radi8/-HL_TX-RX_Filters/Takashi Filters/TestData/4_height.jpg

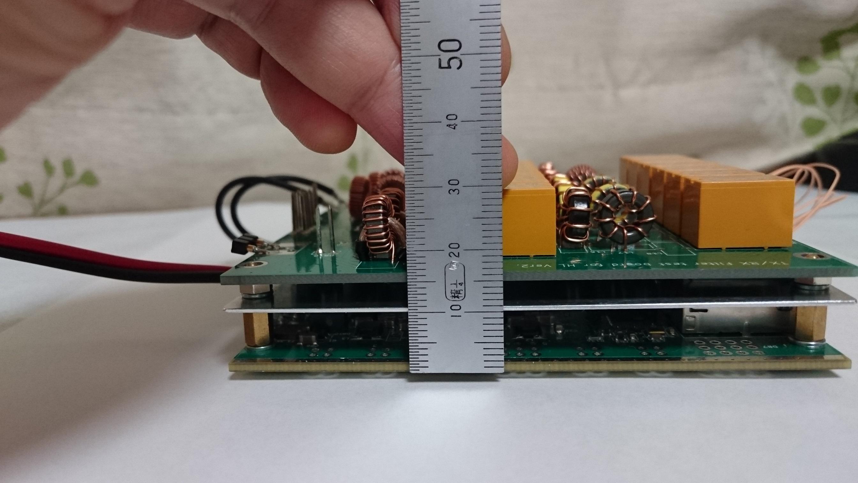
Takashi Filters/TestData/4_height.jpg
