radi8/-HL_TX-RX_Filters/Takashi Filters/TestData/1_HLv2b3_plus_CWKeyerIFwithAudioCodec.jpg

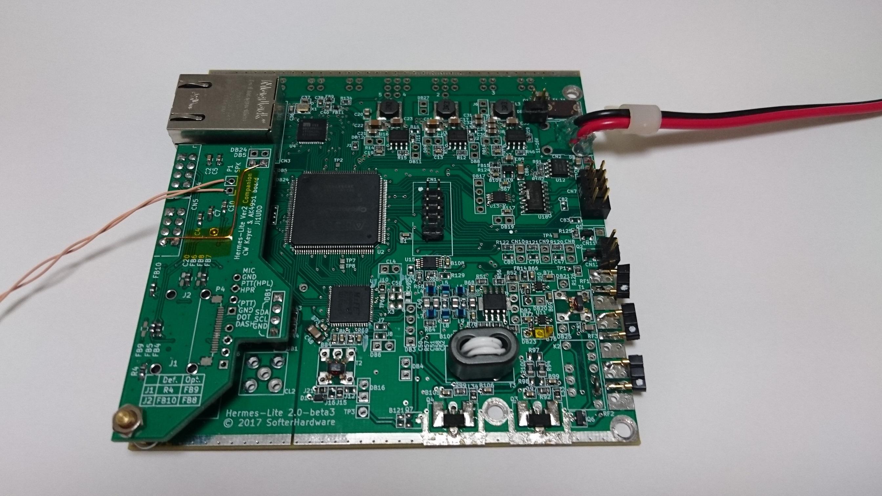
Takashi Filters/TestData/1_HLv2b3_plus_CWKeyerIFwithAudioCodec.jpg
