radi8/-HL_TX-RX_Filters/README.md

# HL_TX-RX_Filters
Transmit and receive filters catalog plus Kicad layout for 100 x 100 mm PCB and part listings
