radi8/-HL_TX-RX_Filters/report.txt

Info: Backing up file "/home/gvj/Kicad/Projects/HL_TX-RX_Filters/sym-lib-table" to file "/home/gvj/Kicad/Projects/HL_TX-RX_Filters/rescue-backup/sym-lib-table-2018-09-30-22-53-34".
Info: Backing up file "/home/gvj/Kicad/Projects/HL_TX-RX_Filters/HL_TX-RX_Filter.sch" to file "/home/gvj/Kicad/Projects/HL_TX-RX_Filters/rescue-backup/HL_TX-RX_Filter-2018-09-30-22-53-34.sch".
Info: Backing up file "/home/gvj/Kicad/Projects/HL_TX-RX_Filters/HL_TX-RX_Filter.pro" to file "/home/gvj/Kicad/Projects/HL_TX-RX_Filters/rescue-backup/HL_TX-RX_Filter-2018-09-30-22-53-34.pro".
Info: Backing up file "/home/gvj/Kicad/Projects/HL_TX-RX_Filters/HL_TX-RX_Filter-cache.lib" to file "/home/gvj/Kicad/Projects/HL_TX-RX_Filters/rescue-backup/HL_TX-RX_Filter-cache-2018-09-30-22-53-34.lib".
Info: Backing up file "/home/gvj/Kicad/Projects/HL_TX-RX_Filters/HL_TX-RX_Filter-rescue.lib" to file "/home/gvj/Kicad/Projects/HL_TX-RX_Filters/rescue-backup/HL_TX-RX_Filter-rescue-2018-09-30-22-53-34.lib".
Info: Backing up file "/home/gvj/Kicad/Projects/HL_TX-RX_Filters/HL_TX-RX_Filter-rescue.dcm" to file "/home/gvj/Kicad/Projects/HL_TX-RX_Filters/rescue-backup/HL_TX-RX_Filter-rescue-2018-09-30-22-53-34.dcm".
Info: Adding library "HL_TX-RX_Filter-rescue", file "${MYPRJ}/HL_TX-RX_Filters/HL_TX-RX_Filter-rescue.lib" to project symbol library table.
Symbol "PE4259" mapped to symbol library "HL_TX-RX_Filter-rescue".
Symbol "PE4259" mapped to symbol library "HL_TX-RX_Filter-rescue".
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
Symbol "D" mapped to symbol library "HL_TX-RX_Filter-rescue".
Symbol "CONN_01X02" mapped to symbol library "HL_TX-RX_Filter-rescue".
Symbol "Conn_Coaxial" mapped to symbol library "HL_TX-RX_Filter-rescue".
Symbol "GND" mapped to symbol library "power".
Info: Symbol library table mapping complete!
