radi8/-HL_TX-RX_Filters/FilterScans/12-10M_Trans_MiniVNA.pdf

# Testexport

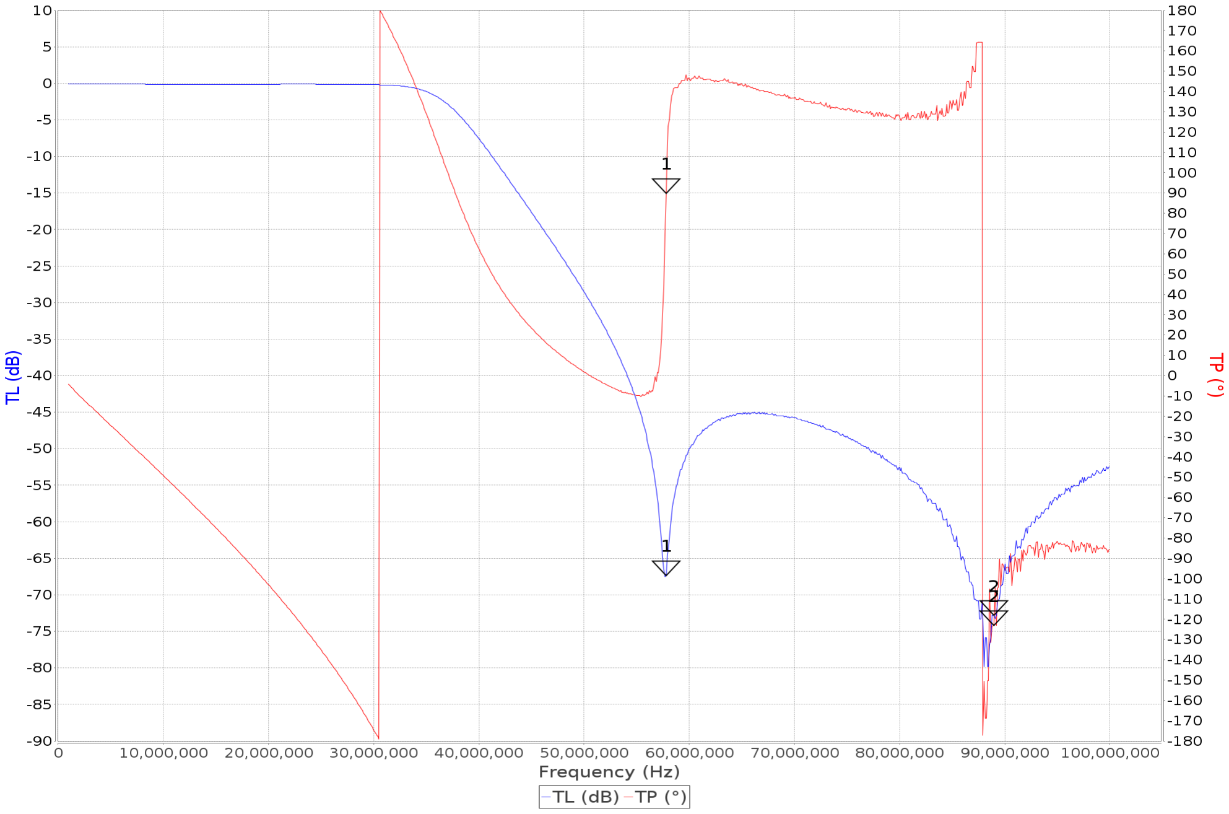
[picture p3: figure]

## Comment:

Date: | 31/08/17 9:53 PM
Mode: | Transmission
Analyser: | miniVNA-pro / mini radio solutions - miniVNA pro
Scan
Start: | 1000000 / 1,000,000
Stop: | 99998969 / 99,998,969
Samples: 943
Overscan: 5
Calibration
Samples: 2000
Overscan: 1
File: | TRAN_miniVNA-pro.cal
User: | gvj

## Plot generated on 31/08/2017, 9:53:38 PM

Marker | Freq. (Hz) | RL (dB) | RP (°) | TL (dB) | TP (°) | SWR | |Z| () | Rs () | Xs ()
1 | 57,795,803 | 0.00 | 0.00 | -67.37 | 89.79 | 0.00:1 | 0.0 | 0.0 | 0.0
2 | 88,975,754 | 0.00 | 0.00 | -72.81 | -123.15 | 0.00:1 | 0.0 | 0.0 | 0.0
1-2 | 31,179,951 | 0.00 | 0.00 | 5.44 | 212.93 | --- | 0.0 | 0.0 | 0.0
© DL2SBA 2013 | vna/J Version 2.8.6c | http://vnaj.dl2sba.com
