radi8/-HL_TX-RX_Filters/Takashi Filters/170814_PA_Mode_Spur_IMD_rev1.1.pdf

## HLv2 Beta3 PA Mode test : Spur and IMD

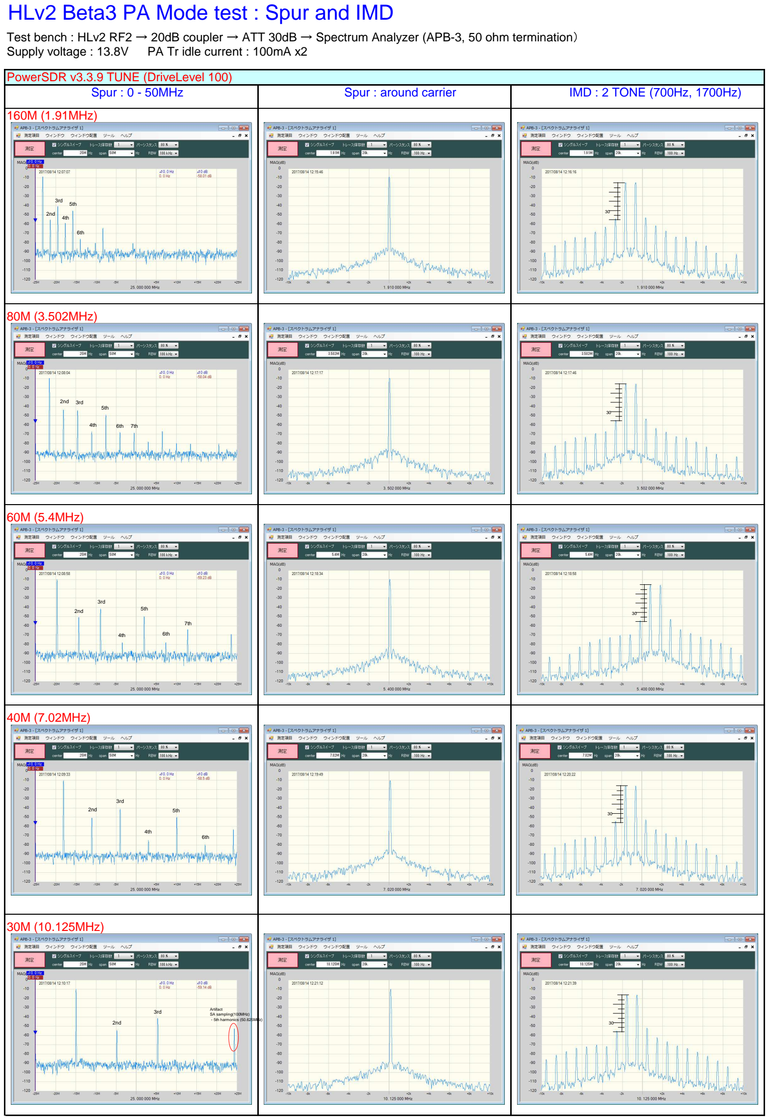
[picture p4: page 1]

Test bench : HLv2 RF2 → 20dB coupler → ATT 30dB → Spectrum Analyzer (APB-3, 50 ohm termination） Supply voltage : 13.8V PA Tr idle current : 100mA x2

PowerSDR v3.3.9 TUNE (DriveLevel 100)
Spur : 0 - 50MHz | Spur : around carrier | IMD : 2 TONE (700Hz, 1700Hz)
160M (1.91MHz)

80M (3.502MHz)

60M (5.4MHz)

40M (7.02MHz)

30M (10.125MHz)

2nd

3rd | Artifact SA sampling(100MHz)
- 5th harmonics (50.625MHz)

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
2nd 3rd

4th

5th

6th 7th

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
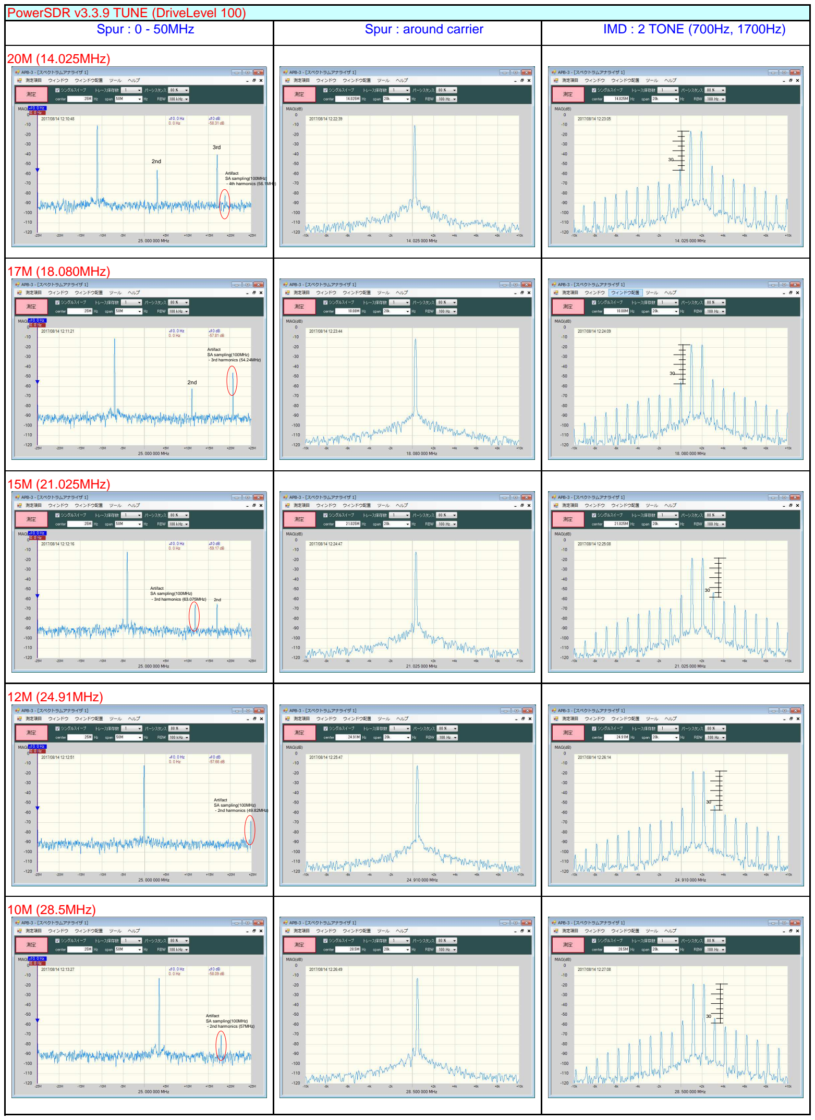
[picture p5: page 2]

PowerSDR v3.3.9 TUNE (DriveLevel 100)
Spur : 0 - 50MHz | Spur : around carrier | IMD : 2 TONE (700Hz, 1700Hz)

20M (14.025MHz)

17M (18.080MHz)

15M (21.025MHz)

12M (24.91MHz)

10M (28.5MHz)

Artifact
SA sampling(100MHz)
- 2nd harmonics (57MHz)

Artifact
SA sampling(100MHz)
- 2nd harmonics (49.82MHz)

Artifact
SA sampling(100MHz)
- 3rd harmonics (63.075MHz) 2nd

2nd

Artifact
SA sampling(100MHz)
- 3rd harmonics (54.24MHz)

2nd

3rd

Artifact
SA sampling(100MHz)
- 4th harmonics (56.1MHz)

30

30

30

30

30
