radi8/-HL_TX-RX_Filters/FiltersBp_gj/30-20M_mesh_schematic.png

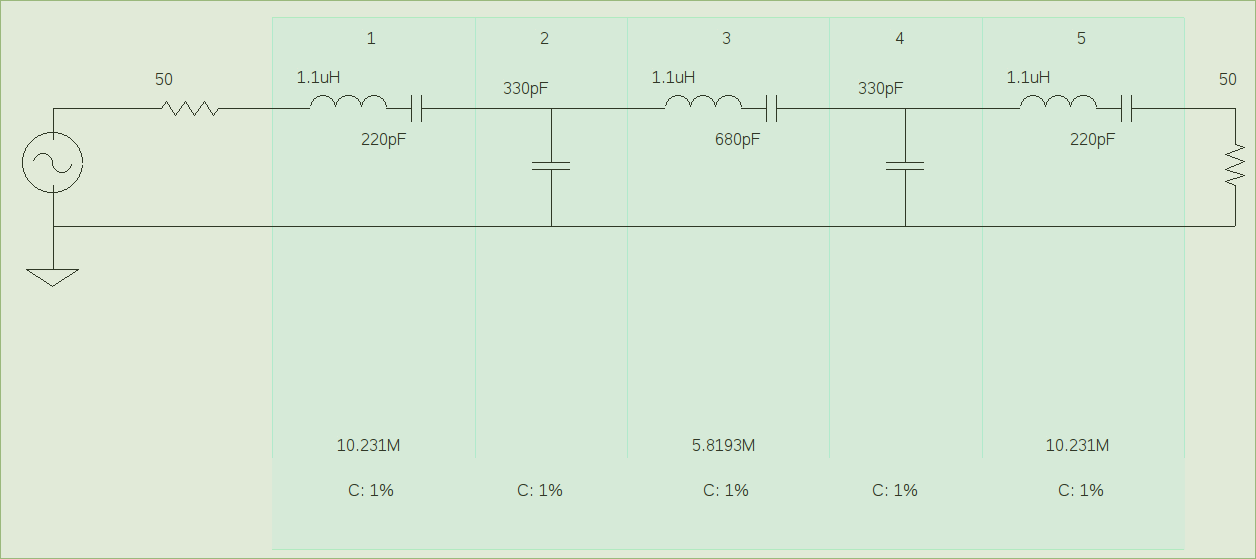
FiltersBp_gj/30-20M_mesh_schematic.png
