radi8/-HL_TX-RX_Filters/FiltersBp_gj/60-40M_mesh_schermatic.png

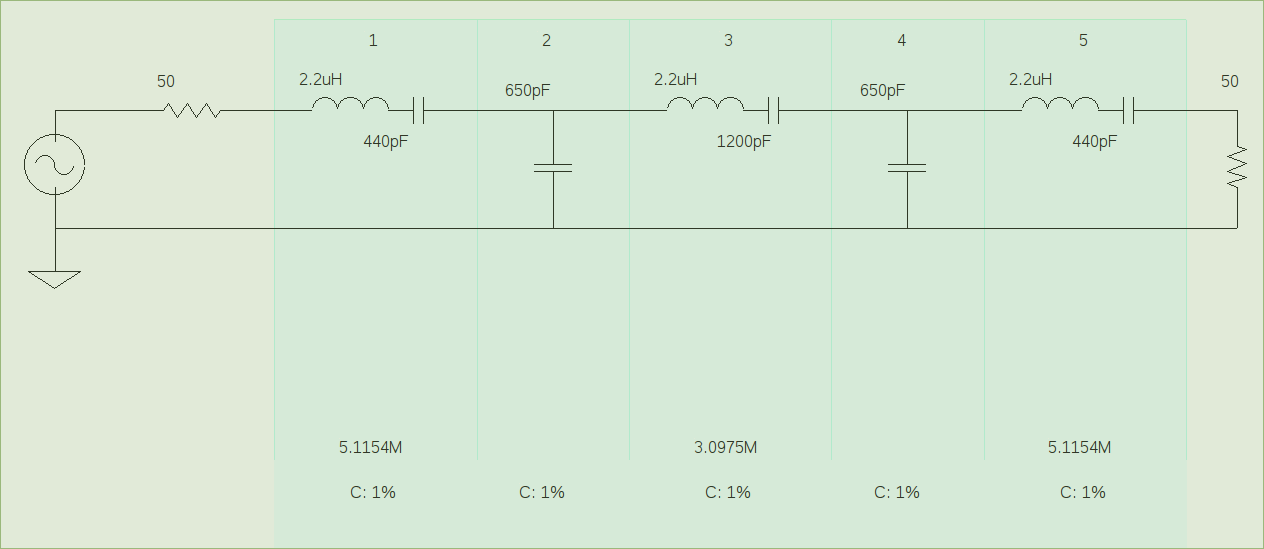
FiltersBp_gj/60-40M_mesh_schermatic.png
