radi8/-HL_TX-RX_Filters/FiltersRx_gj/Final Plots/Flooring Filter.png

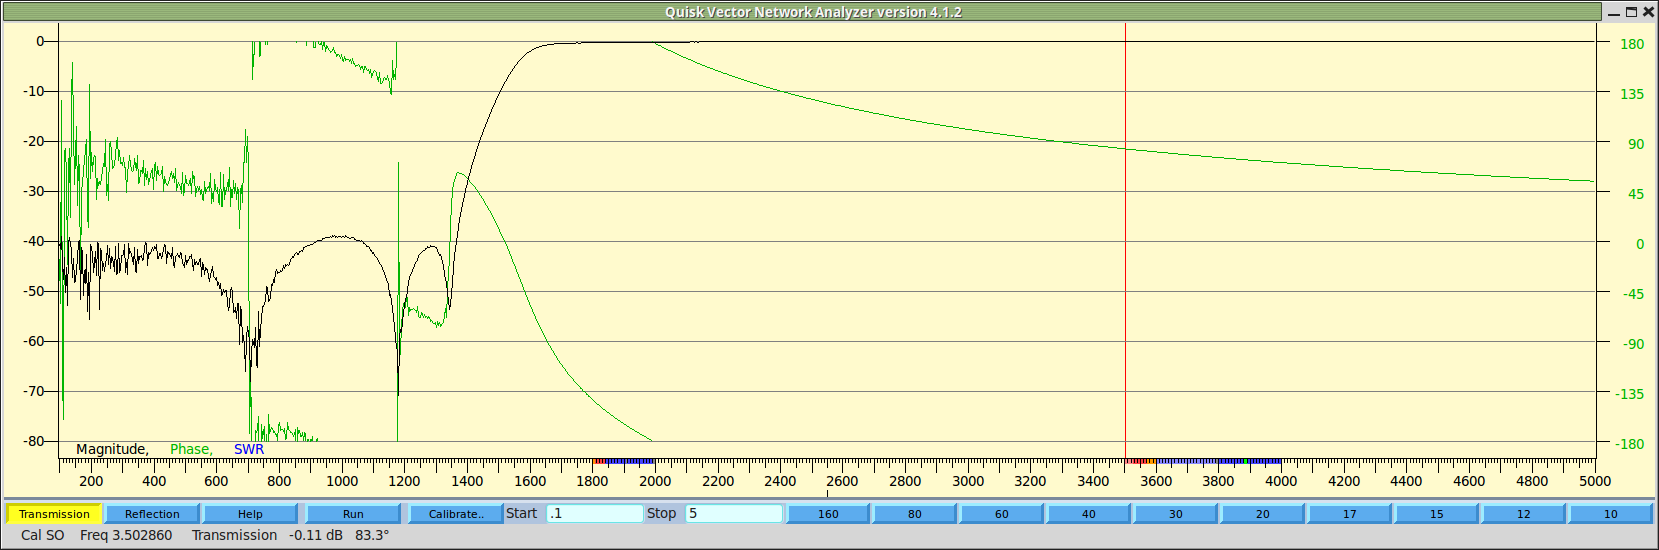
FiltersRx_gj/Final Plots/Flooring Filter.png
