radi8/-HL_TX-RX_Filters/FiltersRx_gj/Screenshot from 2016-07-10 22:16:24.png

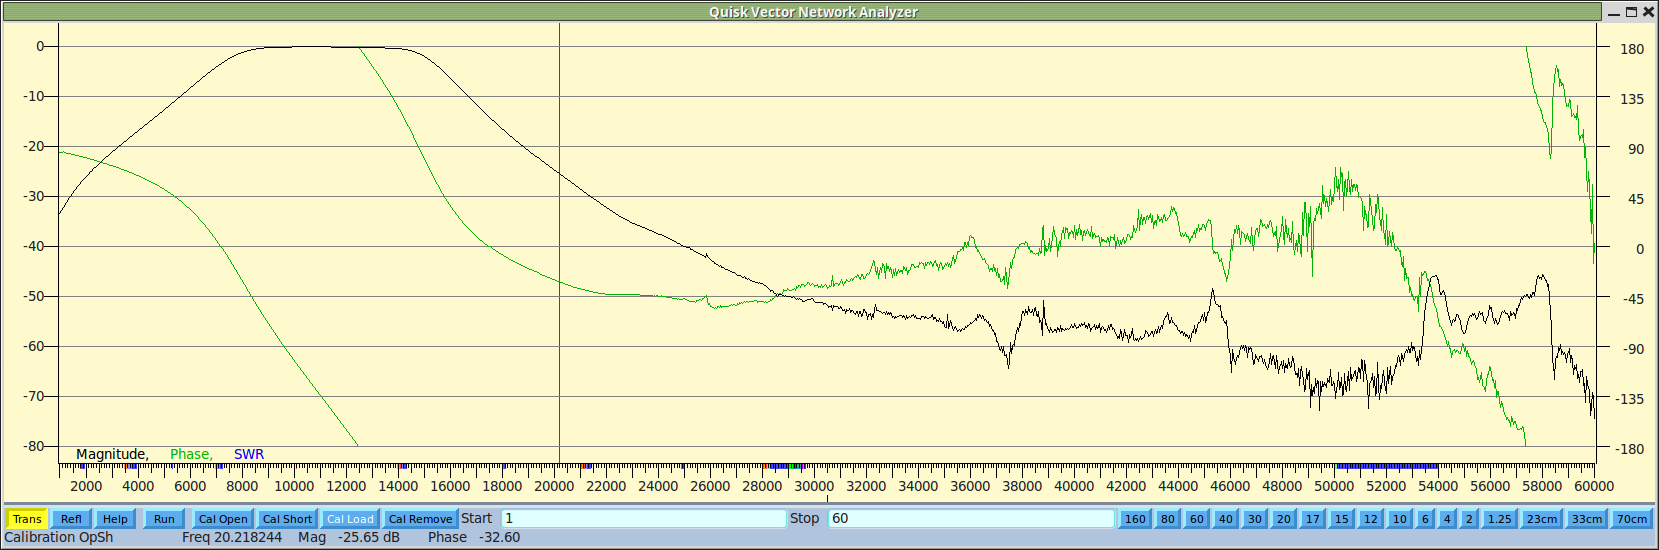
FiltersRx_gj/Screenshot from 2016-07-10 22:16:24.png
