radi8/-HL_TX-RX_Filters/FiltersRx_gj/Screenshot from 2016-07-14 20:33:30.png

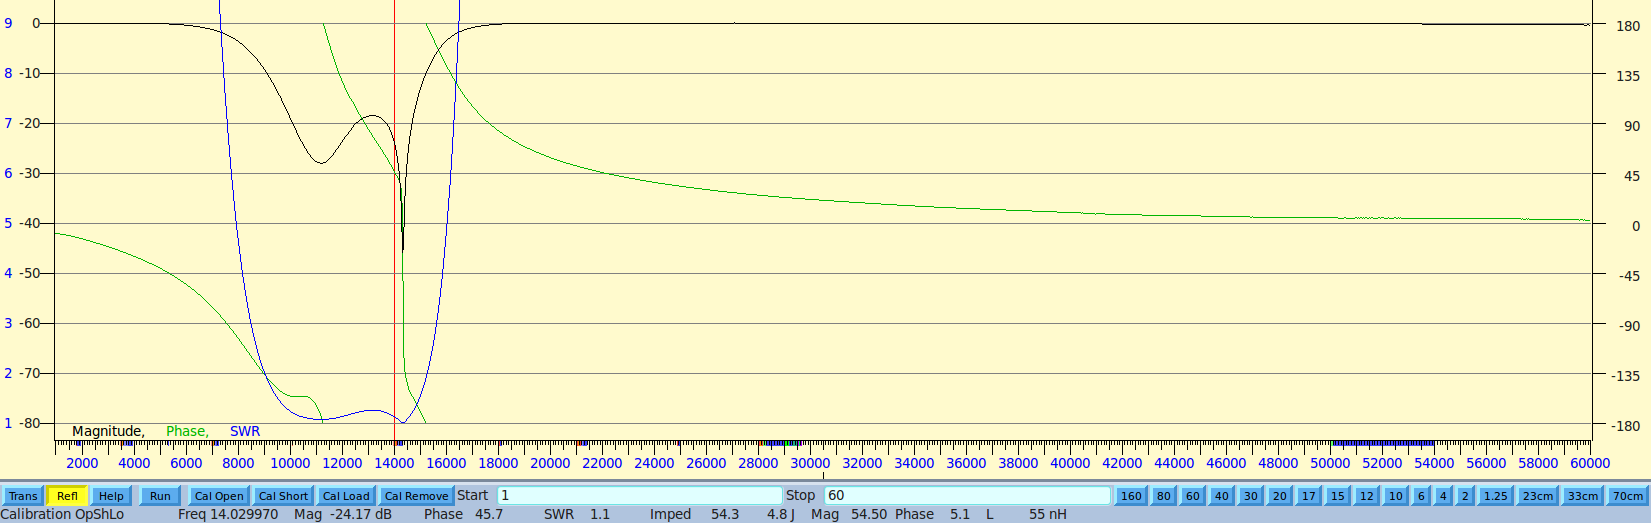
FiltersRx_gj/Screenshot from 2016-07-14 20:33:30.png
