radi8/-HL_TX-RX_Filters/FiltersRx_gj/Screenshots/40Mcauer5poleHP_Plot.png

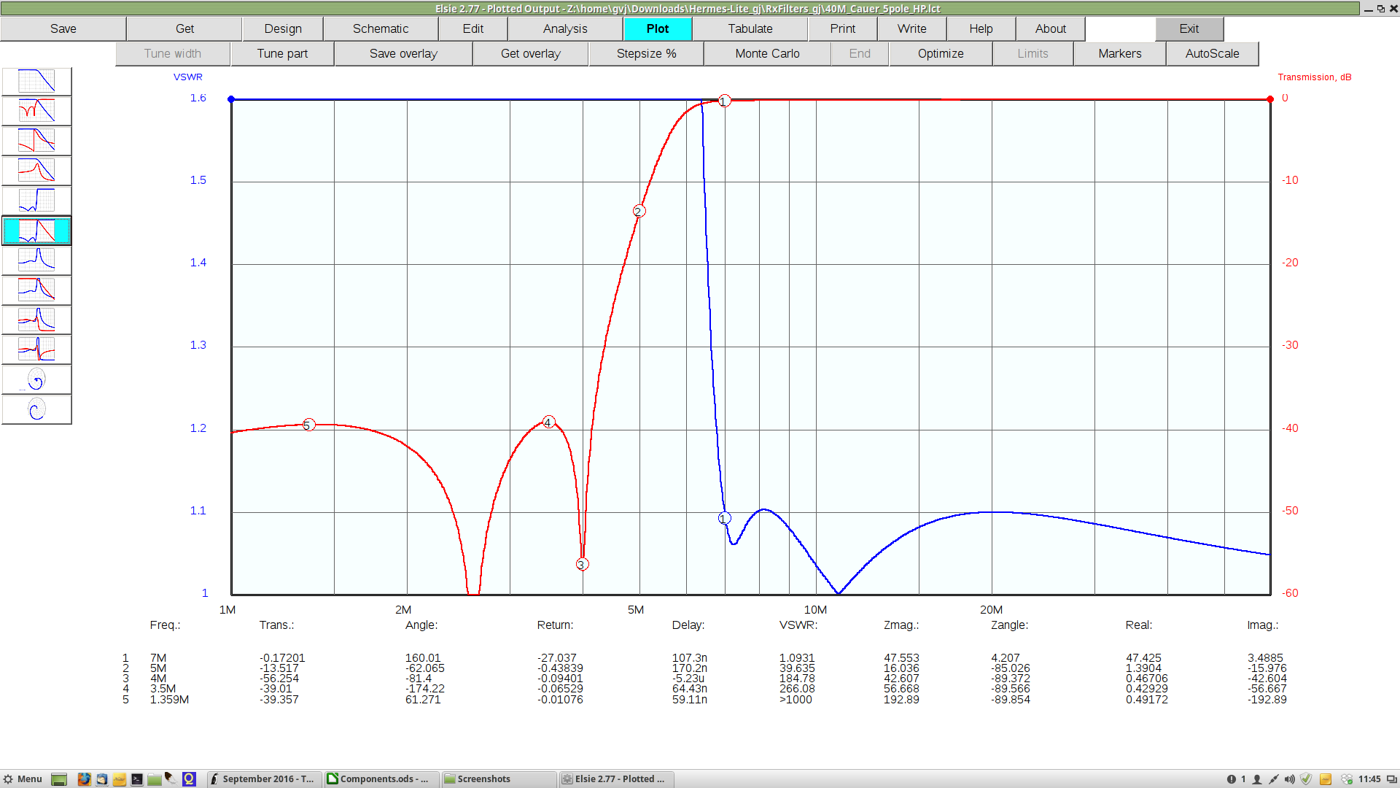
FiltersRx_gj/Screenshots/40Mcauer5poleHP_Plot.png
