radi8/-HL_TX-RX_Filters/FiltersRx_gj/Screenshots/60Mcauer5poleHP_Plot.png

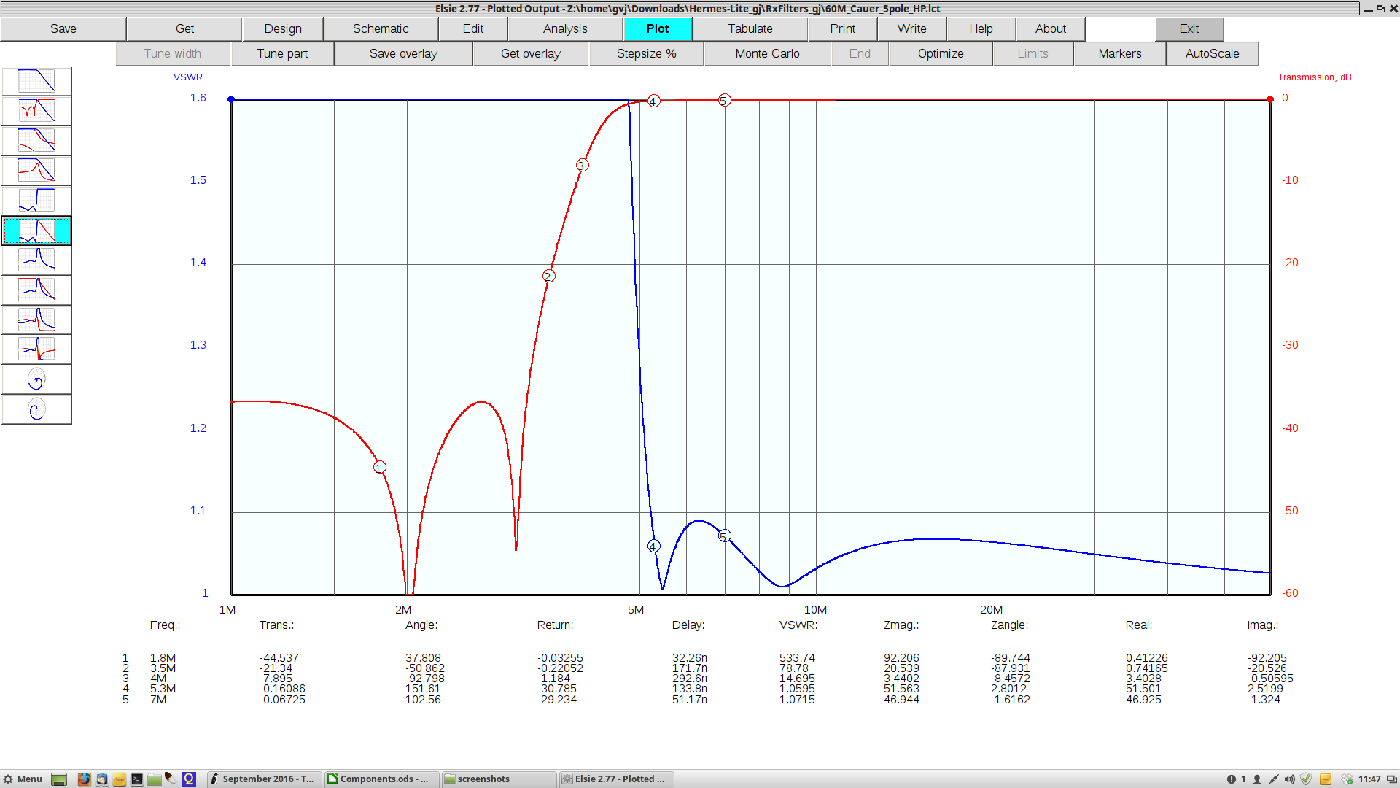
FiltersRx_gj/Screenshots/60Mcauer5poleHP_Plot.png
