radi8/-HL_TX-RX_Filters/FiltersRx_gj/Screenshots/80M_HP_Filter_5pole.png

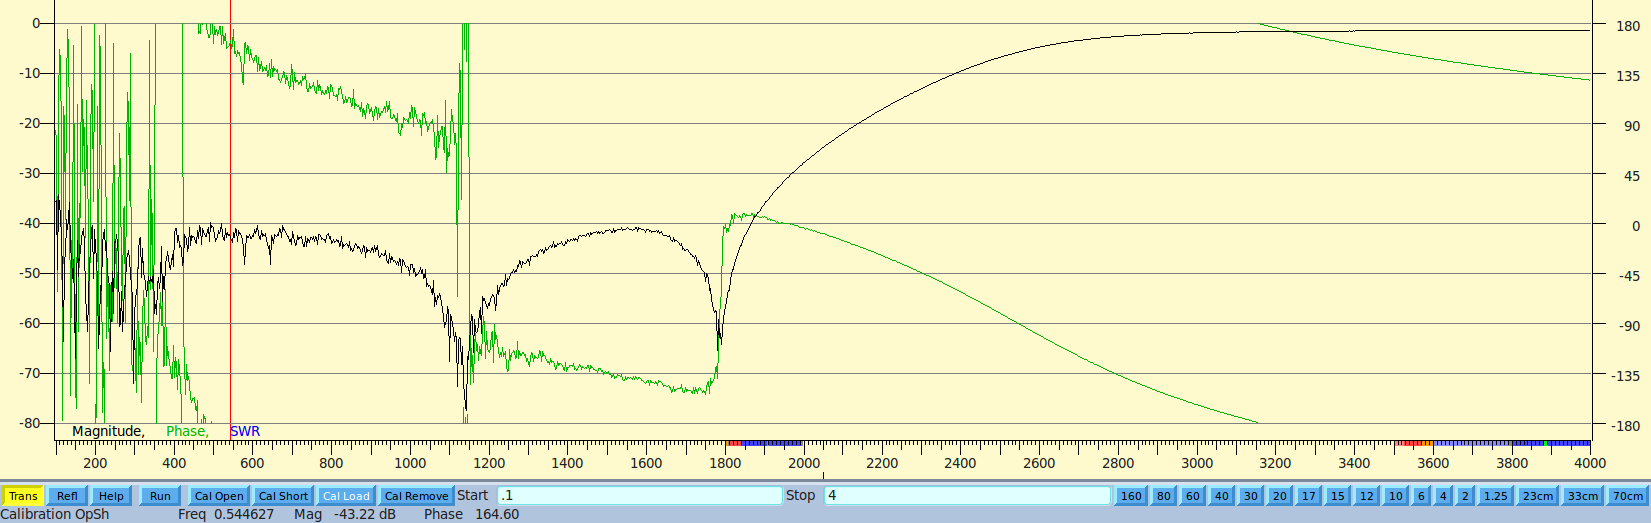
FiltersRx_gj/Screenshots/80M_HP_Filter_5pole.png
