radi8/-HL_TX-RX_Filters/FiltersRx_gj/Screenshots/80Mcauer5poleHP_Schem.png

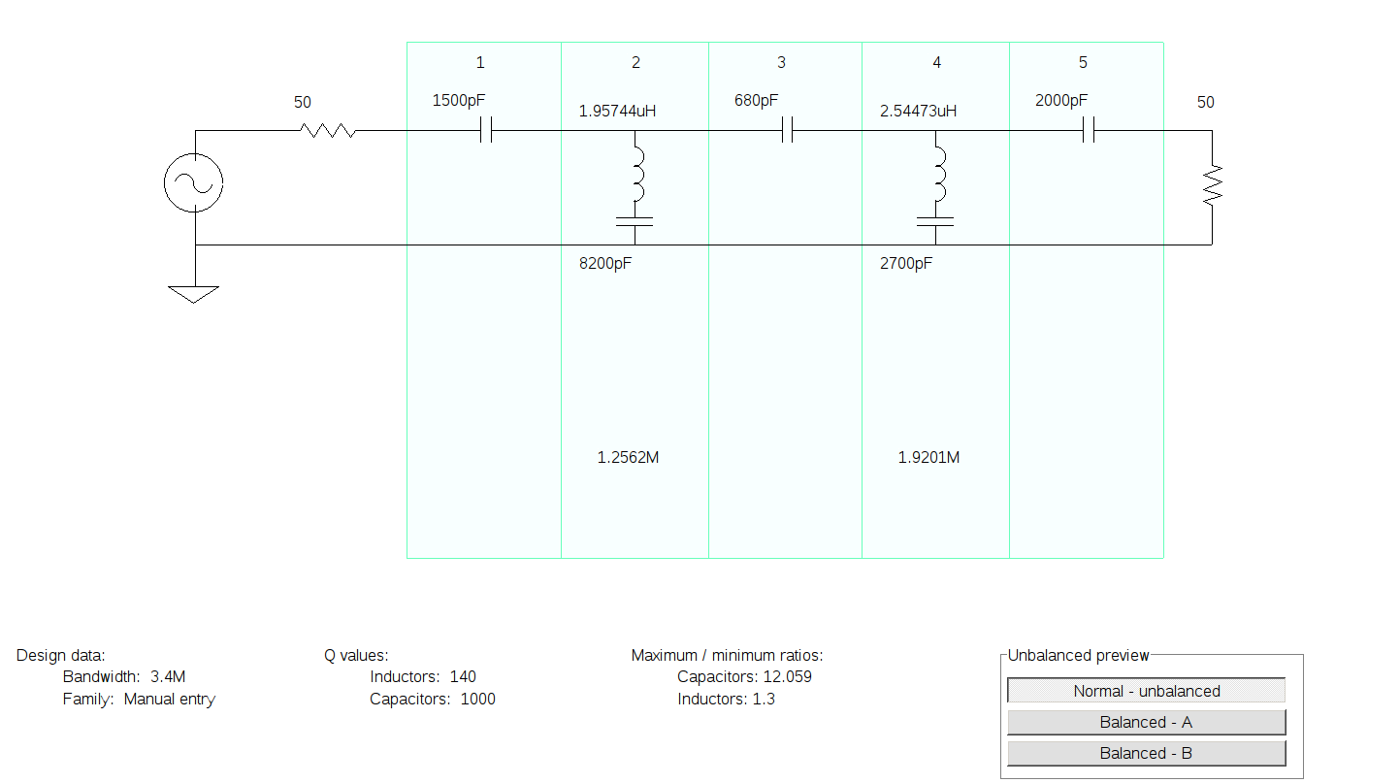
FiltersRx_gj/Screenshots/80Mcauer5poleHP_Schem.png
