radi8/-HL_TX-RX_Filters/FiltersRx_gj/Screenshots/160Mcauer7poleHP_Plot.png

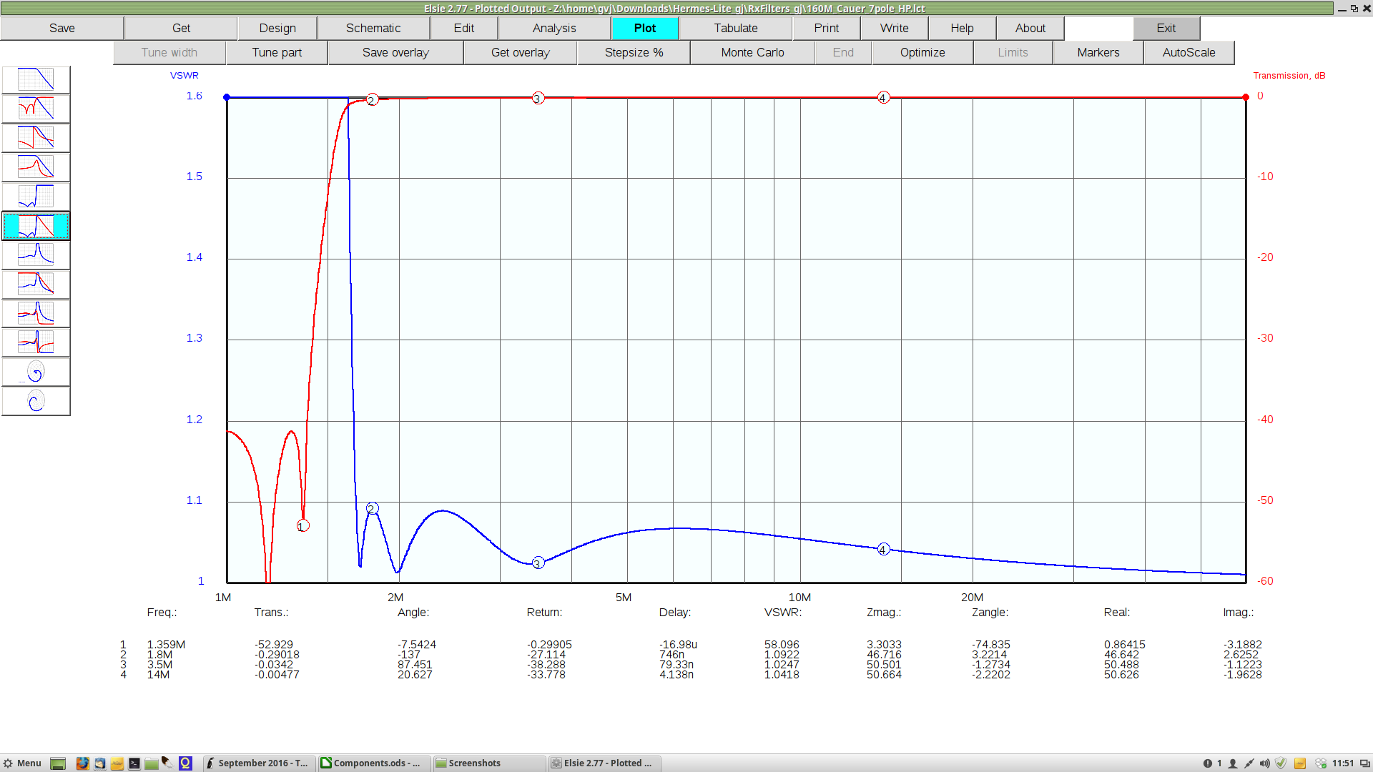
FiltersRx_gj/Screenshots/160Mcauer7poleHP_Plot.png
