radi8/-HL_TX-RX_Filters/FiltersRx_gj/Screenshots/Diode_switch_open.png

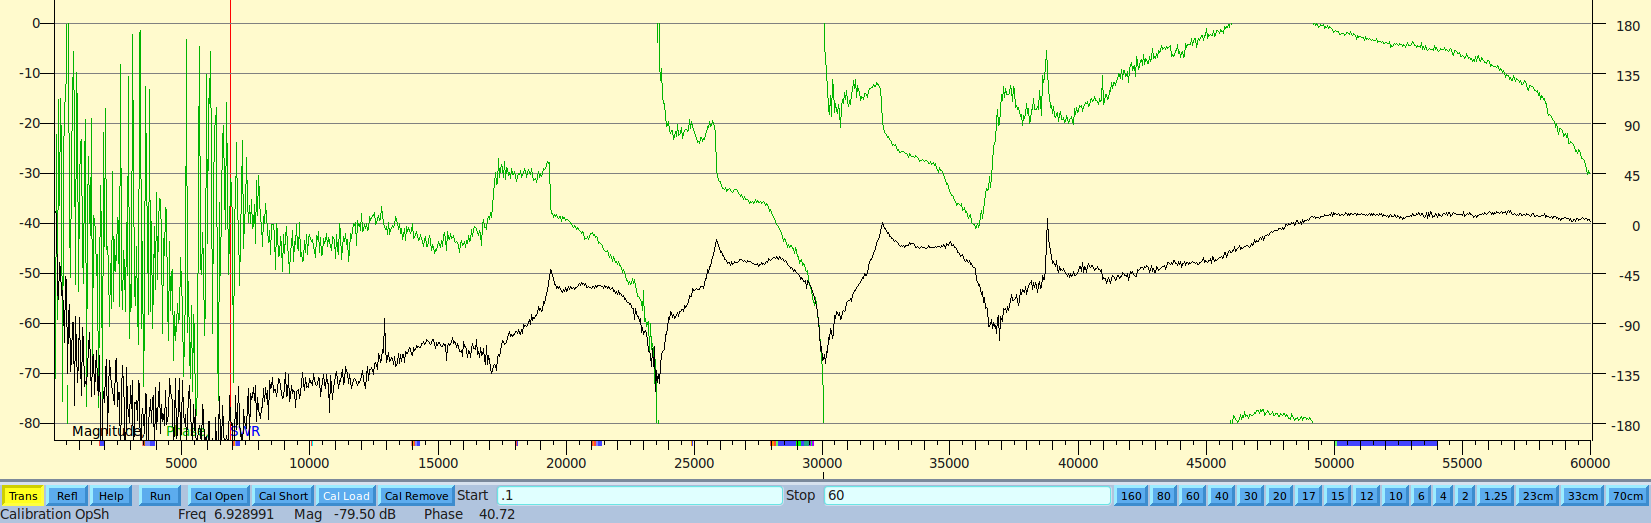
FiltersRx_gj/Screenshots/Diode_switch_open.png
