radi8/-HL_TX-RX_Filters/FiltersRx_gj/Screenshots/Filtered.png

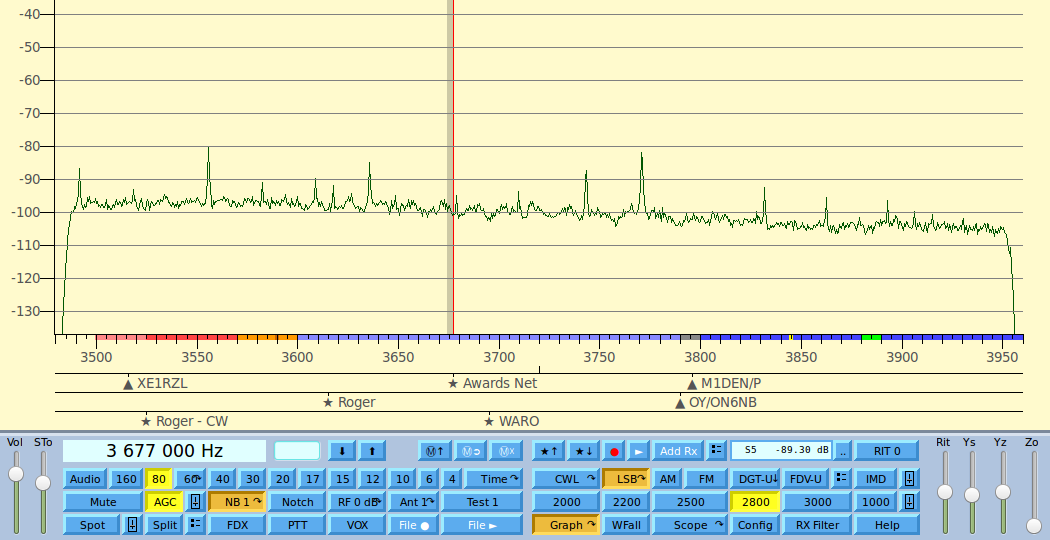
FiltersRx_gj/Screenshots/Filtered.png
