radi8/-HL_TX-RX_Filters/FiltersRx_gj/Screenshots/HPF_LPF_Filter.png

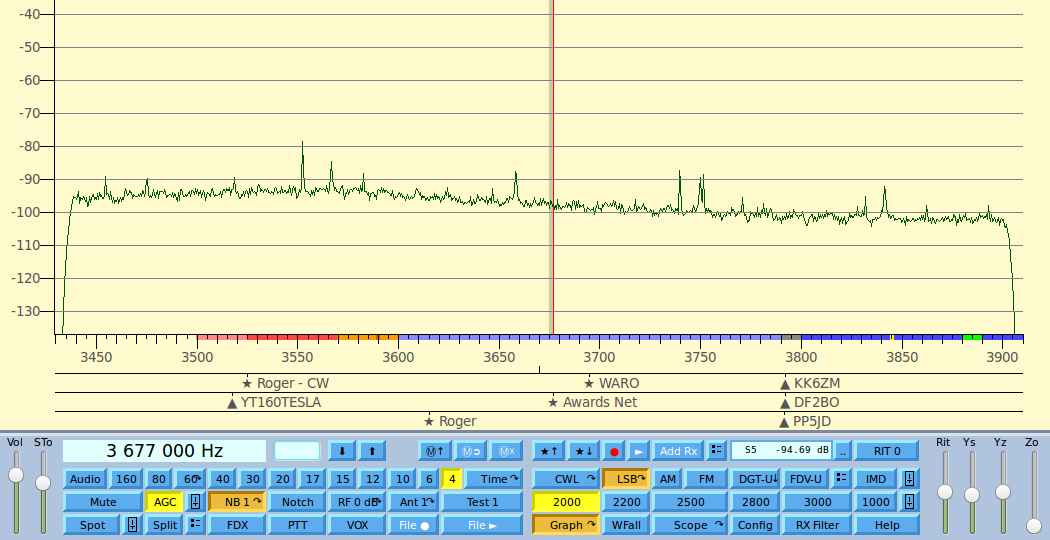
FiltersRx_gj/Screenshots/HPF_LPF_Filter.png
