radi8/-HL_TX-RX_Filters/FiltersRx_gj/Screenshots/No_Filter.png

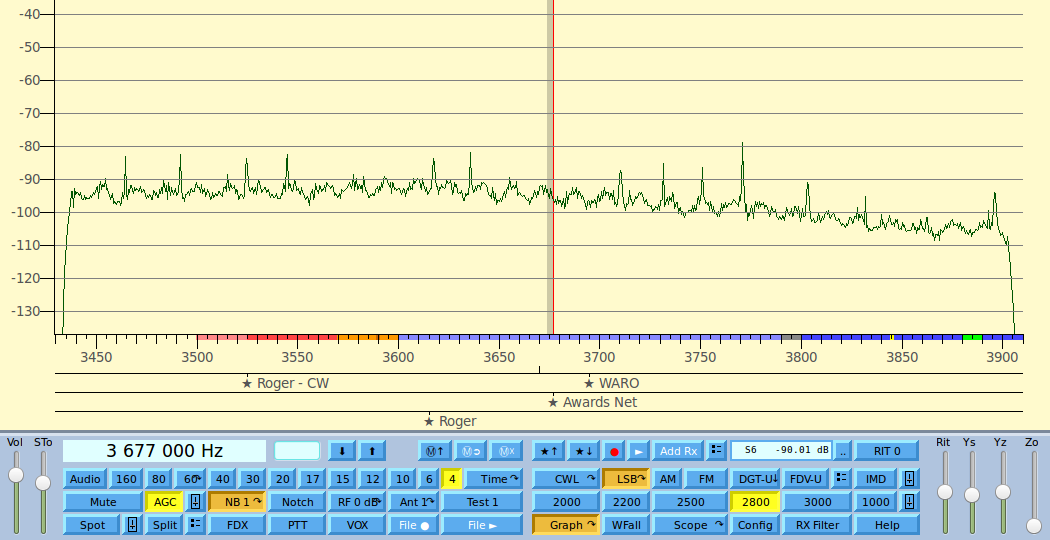
FiltersRx_gj/Screenshots/No_Filter.png
