radi8/-HL_TX-RX_Filters/FiltersRx_gj/Screenshots/With_HPF.png

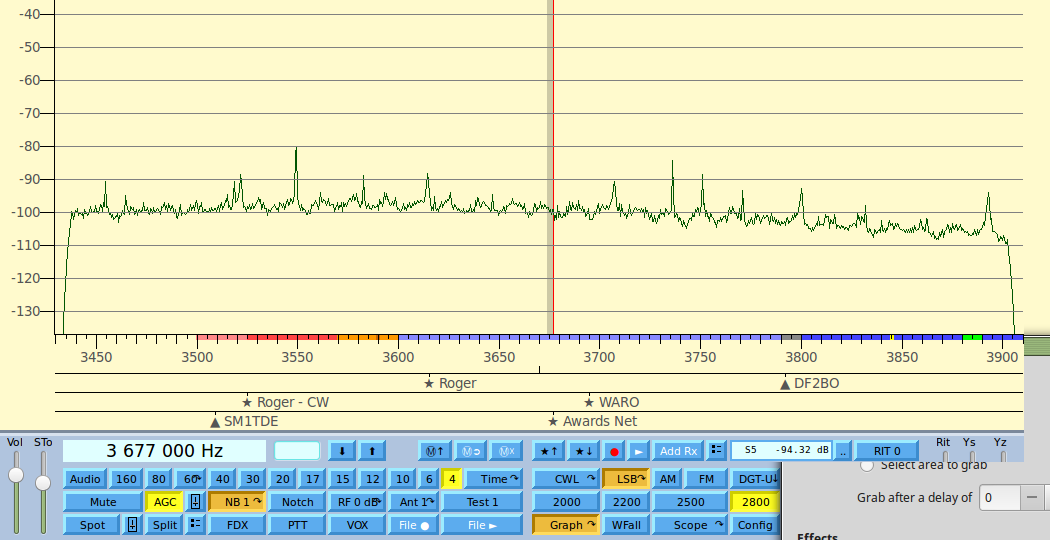
FiltersRx_gj/Screenshots/With_HPF.png
