radi8/-HL_TX-RX_Filters/FiltersTx_gj/12-10M_Cauer_LP_Plot.png

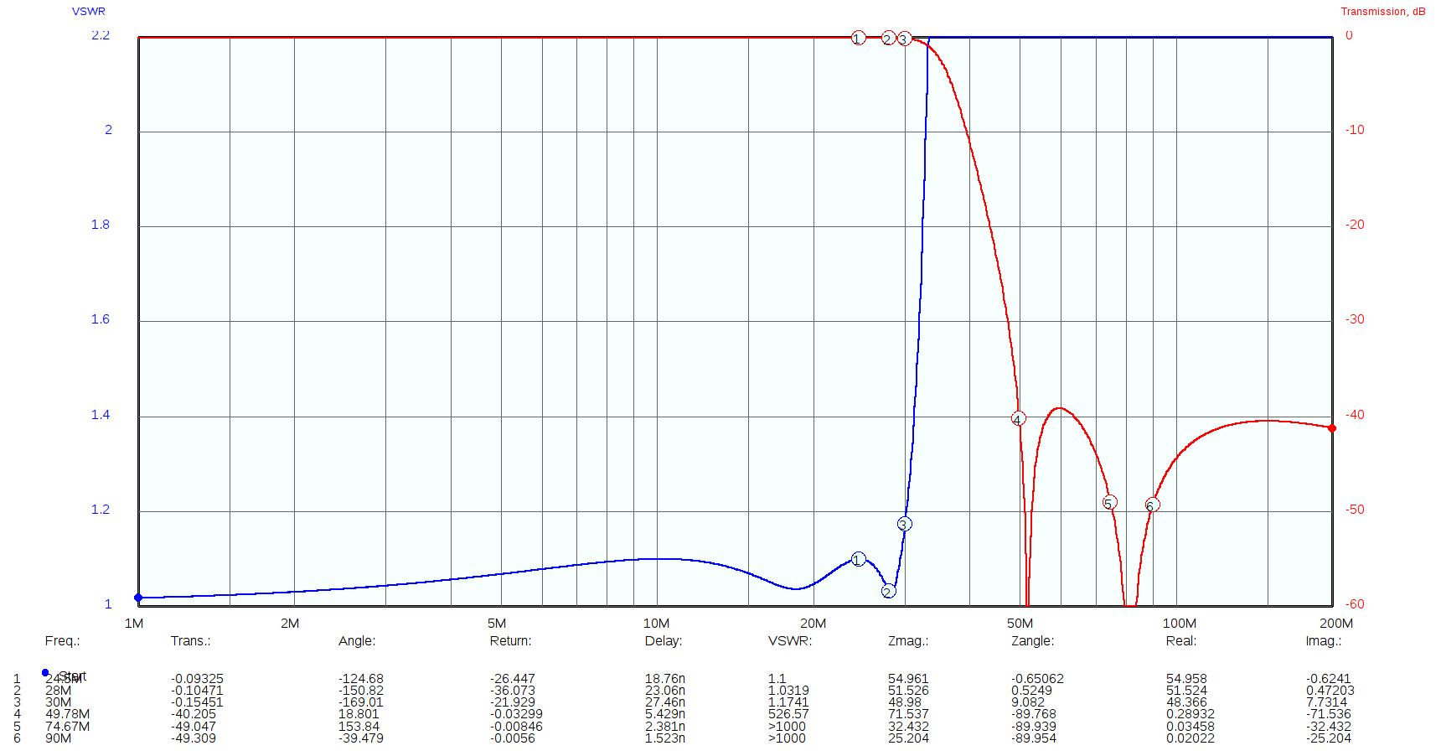
FiltersTx_gj/12-10M_Cauer_LP_Plot.png
