radi8/-HL_TX-RX_Filters/HL_TX-RX_FilterBack.png

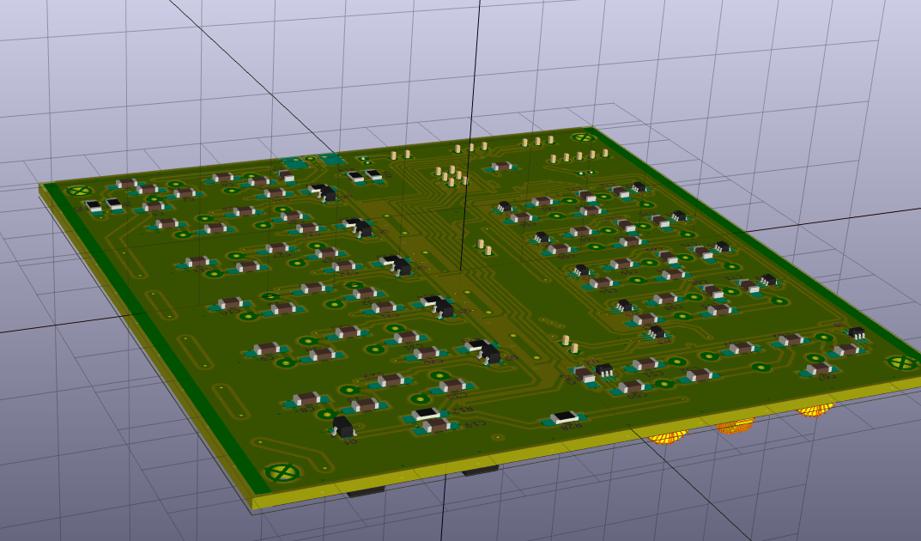
HL_TX-RX_FilterBack.png
