radi8/-HL_TX-RX_Filters/HL_TX-RX_FilterFront.png

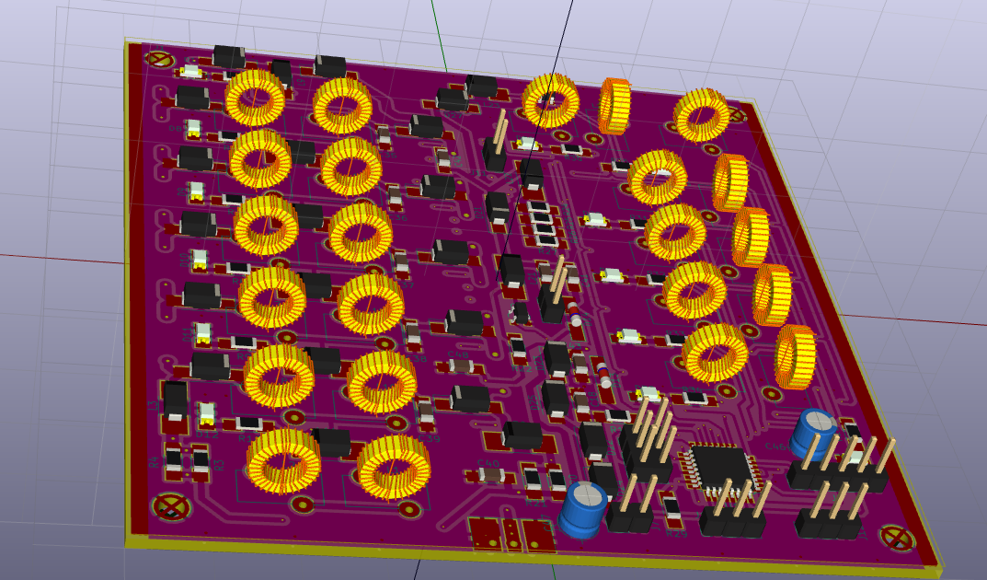
HL_TX-RX_FilterFront.png
