radi8/-HL_TX-RX_Filters/FiltersRx_gj/Filter Components.ods

 | Low Pass Filter Set
Band | C1 pF | L1 nH | C2 pF | C3 pF | L2 nH | C4 pF | C5 pF | L3 nH | C6 pF | C7 pF | L1 turns | L2 turns | L3 turns | File Name
56 MHz LPF | 33 | 158.57 | 10 | 68 | 98.4821 | 33 | 15 |  |  |  | 5t 10x10 mm | 4t 10x10 mm |  | 56MHz_Cauer_5pole_LP.lct
12-10 M LPF | 68 | 313.189 | 13.3 | 142 | 235.414 | 41.2 | 47 |  |  |  | 11t T37-10 | 10t T37-10 |  | 12-10M_Cauer_5pole_LP.lct
17-15 M LPF | 100 | 408.425 | 15 | 200 | 338.431 | 43 | 75 |  |  |  | 12t T37-6 | 11t T37-6 |  | 17-15M_Cauer_5pole_LP.lct
30-20 M LPF | 150 | 635.009 | 39 | 300 | 445.407 | 130 | 120 |  |  |  | 15t T37-6 | 12t T37-6 |  | 30-20M_Cauer_5pole_LP.lct
40 M LPF | 292 | 1273.17 | 39 | 599 | 1016.85 | 120 | 220 |  |  |  | 18t T37-2 | 16t T37-2 |  | 40M_Cauer_5pole_LP.lct
80 M LPF | 540 | 2366.21 | 82 | 1082 | 1812.16 | 270 | 390 |  |  |  | 24t T37-2 | 21t T37-2 |  | 80M_Cauer_5pole_LP.lct
160 M LPF | 1000 | 4486.48 | 180 | 2100 | 3397.71 | 552 | 736 |  |  |  | 33t T37-2 | 29t T37-2 |  | 160M_Cauer_5pole_LP.lct
 | High Pass Filter Set
17 M HPF | 270 | 389.643 | 1500 | 130 | 489.027 | 510 | 360 |  |  |  | 11t T37-6 | 13t T37-6 |  | 17M_Cauer_5pole_HP.lct
30 M HPF | 470 | 679.552 | 2400 | 236 | 910.842 | 780 | 680 |  |  |  | 15t T37-6 | 17t T37-6 |  | 30M_Cauer_5pole_HP.lct
40 M HPF | 680 | 970.957 | 3900 | 340 | 1308.34 | 1200 | 1000 |  |  |  | 16t T37-2 | 18t T37-2 |  | 40M_Cauer_5pole_HP.lct
60 M HPF | 1000 | 1322.7 | 4700 | 470 | 1787.18 | 1500 | 1500 |  |  |  | 18t T37-2 | 21t T37-2 |  | 60M_Cauer_5pole_HP.lct
80 M HPF | 1500 | 1957.44 | 8200 | 680 | 2544.73 | 2700 | 2000 |  |  |  | 22t T37-2 | 25t T37-2 |  | 80M_Cauer_5pole_HP.lct
160 M HPF | 3000 | 3962.68 | .012u | 1600 | 5705.29 | 2400 | 1800 | 6067.17 | 3000 | 6200 | 31t T37-2 | 38t T37-2 | 39t T37-2 | 160M_Cauer_7pole_HP.lct
160 M HPF | 0.012 | 1 |  |  | Value | Qty | Stock | Voltage | Stock | Voltage | Order
12-10 M LPF | 3.3 | 1 |  |  |  |  |  | 1206 | 0805 | 0805
12-10 M LPF | 8.2 | 1 |  |  | 3.3 | 1 | 0 |  |  |  | E14
12-10 M LPF | 10 | 1 |  |  | 8.2 | 1 | 0 |  |  |  | E14
17 M HPF | 10 | 1 |  |  | 10 | 5 | 100 | 100V
17-15 M LPF | 10 | 1 |  |  | 15 | 1 | 0 |  |  |  | China
30-20 M LPF | 10 | 1 |  |  | 22 | 2 | 25 | 100V
40 M HPF | 10 | 1 |  |  | 33 | 2 | 25 | 100V
17-15 M LPF | 15 | 1 |  |  | 39 | 2 | 5 | 100V |  |  | E14
12-10 M LPF | 22 | 1 |  |  | 47 | 1 | 25 | 100V
40 M LPF | 22 | 1 |  |  | 56 | 2 | 5 | 50V |  |  | E14
12-10 M LPF | 33 | 1 |  |  | 68 | 1 | 5 | 3KV |  |  | Y
17-15 M LPF | 33 | 1 |  |  | 82 | 3 | 5 | 630V |  |  | E14
30-20 M LPF | 39 | 1 |  |  | 100 | 6 | 38 | 100V |  |  | China
40 M LPF | 39 | 2 |  |  | 120 | 5 | 10 | 100V |  |  | China
12-10 M LPF | 47 | 1 |  |  | 150 | 3 | 15 | 200V
160 M LPF | 56 | 1 |  |  | 180 | 4 | 10 | 630V | 200 | 50V | China
30 M HPF | 56 | 1 |  |  | 220 | 1 | 28 | 100V
12-10 M LPF | 68 | 1 |  |  | 270 | 5 | 103 | 630V
17-15 M LPF | 75 | 1 |  |  | 330 | 1 | 25 | 100V
160 M LPF | 82 | 1 |  |  | 390 | 2 | 0 |  |  |  | China
80 M LPF | 82 | 2 |  |  | 470 | 2 | 20 | 200V
160 M HPF | 100 | 1 |  |  | 560 | 1 | 2 | 630V |  |  | E14
160 M LPF | 100 | 1 |  |  | 680 | 5 | 100 | 630V
17-15 M LPF | 100 | 3 |  |  | 1000 | 7 | 21 | 100V
30 M HPF | 100 | 1 |  |  | 1200 | 5 | 0 |  |  |  | E14
12-10 M LPF | 120 | 1 |  |  | 1500 | 7 | 100 | 100V
17 M HPF | 120 | 2 |  |  | 1800 | 1 | 5 | 630V | 2 | 100V
30-20 M LPF | 120 | 2 |  |  | 2700 | 1 | 0 |  |  |  | E14
40 M LPF | 120 | 1 |  |  | 3900 | 1 | 100 | 100V
30-20 M LPF | 150 | 3 |  |  | 6200 | 1 | 5 | 50V |  |  | HPF
160 M LPF | 180 | 1 |  |  | 8200 | 1 | 12 | 50V |  |  | E14
17 M HPF | 180 | 2 |  |  | .012u | 1 | 0 |  |  |  | E14
30 M HPF | 180 | 1
40 M LPF | 220 | 1
17 M HPF | 270 | 1
40 M LPF | 270 | 1
80 M LPF | 270 | 3
40 M HPF | 330 | 1
17 M HPF | 390 | 1
80 M LPF | 390 | 1
160 M LPF | 470 | 1
30 M HPF | 470 | 1
40 M LPF | 560 | 1
160 M LPF | 680 | 1
30 M HPF | 680 | 2
40 M HPF | 680 | 1
80 M HPF | 680 | 1
160 M LPF | 1000 | 3
40 M HPF | 1000 | 1
80 M HPF | 1000 | 2
80 M LPF | 1000 | 1
160 M HPF | 1200 | 2
30 M HPF | 1200 | 2
40 M HPF | 1200 | 1
160 M HPF | 1500 | 5
17 M HPF | 1500 | 1
80 M HPF | 1500 | 1
160 M HPF | 1800 | 1
80 M HPF | 2700 | 1
40 M HPF | 3900 | 1
160 M HPF | 6200 | 1
80 M HPF | 8200 | 1
