radi8/-HL_TX-RX_Filters/FiltersRx_gj/Documentation/Components.ods

Sheet: Filters
Filter | C1 | C2 | C3 | C4 | C5 | C6 | C7 | L1 | L2 | L3
160M_Cauer_7pole_HP | 3000 | 0.012 | 1600 | 2400 | 1800 | 3000 | 6200 | 3.96268 | 5.70529 | 6.06717
80M_Cauer_5pole_HP | 1500 | 8200 | 680 | 2700 | 2000 |  |  | 1.95744 | 2.54473
60M_Cauer_5pole_HP | 1000 | 4700 | 470 | 1500 | 1500 |  |  | 1.3227 | 1.78718
40M_Cauer_5pole_HP | 680 | 3900 | 340 | 1200 | 1000 |  |  | 0.963121 | 1.32644
30M_Cauer_5pole_HP | 510 | 2400 | 240 | 750 | 750 |  |  | 0.683599 | 0.950955
17M_Cauer_5pole_HP | 270 | 1500 | 130 | 510 | 360 |  |  | 0.389643 | 0.489027
12M_Cauer_5pole_HP | 200 | 1100 | 100 | 360 | 270 |  |  | 0.288928 | 0.378509
 |  | 1 | 10 |  | y
 |  | 1 | 100 |  | y
 |  | 1 | 120 |  | y
 | 0 | 1 | 130 | 120+10
 | 0 | 1 | 200 | 2x100
 | 0 | 1 | 240 | 2x120
 |  | 2 | 270 |  | y
 | 0 | 1 | 340 | 2x120+100
 | 0 | 2 | 360 | 3x120
 |  | 1 | 470 |  | y
 | *** | 2 | 510
 |  | 2 | 680 |  | y
 | 0 | 2 | 750 | 2x120+510
 |  | 2 | 1000 |  | y
 | 0 | 1 | 1100 | 1000+100
 | 0 | 1 | 1200 | 1000+2x100
 |  | 4 | 1500
 | 0 | 1 | 1600 | 1500+100
 |  | 1 | 1800 |  | y
 | 0 | 1 | 2000 | 2x1000
 | 0 | 2 | 2400 | 2x1200
 |  | 1 | 2700
 | 0 | 2 | 3000 | 3x1000
 |  | 1 | 3900 |  | y
 |  | 1 | 4700
 | 0 | 1 | 6200 | 4700+1500
 |  | 1 | 8200
 |  | 1 | 0.012
 | 14 | 38 | 27

Sheet: Stock
Capacitors in stock
Qty | Value | Case | Voltage | Type | Tolerance% | Part# | Supplier
5 | 6.8 | 1206 | 100 | NPO | +/- .25pF | 478-5171-1-ND | DigiKey
10 | 10 | 1206 | 100 | NPO | 5 | 1800832 | Element14
25 | 10 | 1206 | 100 | NPO | 5 | RS | 126-411
50 | 22 | 1206 | 100 | NPO | 5 | 940-6441 | Element14
25 | 22 | 1206 | 100 | NPO | 5 | RS | 126-427
15 | 22 | 1812 | 100 | Unknown | 10 | Ted
100 | 22 | 0805 | Probably 50 | Probably NPO | Probably 5 | Glenn
5 | 24 | 0805 | 250 | NPO | 1 | 399-8757-1-ND | DigiKey
5 | 27 | 1206 | 100 | NPO | 5 | 1582751 | Element14
10 | 33 | 1206 | 50 | NPO | 5 | 1414727 | Element14
5 | 33 | 1206 | 500 | NPO | 5 | 709-1272-1-ND | DigiKey
25 | 33 | 1206 | 100 | NPO | 5 | RS | 126-433
5 | 39 | 1206 | 100 | NPO | 5 | 478-5039-1-ND | DigiKey
25 | 47 | 1206 | 100 | NPO | 5 | RS | 126-449
5 | 56 | 1206 | 50 | NPO | 5 | 1164014 | Element14
5 | 62 | 0805 | 100 | NPO | 5 | 478-6215-1-ND | DigiKey
5 | 68 | 1808 | 3KV | NPO | 5 | 709-1256-1-ND | DigiKey
5 | 82 | 1206 | 630 | NPO | 5 | 2218891 | Element14
20 | 100 | 1206 | 100 | NPO | 5 | 1414704 | Element14
18 | 100 | 1206 | 100 | NPO | 5 | RS | 126-310
150 | 100 | 0805 | Probably 50 | Probably NPO | Probably 5 | Glenn
10 | 120 | 1206 | 100 | COG | 5 | 7414146 | Element14
15 | 150 | 1206 | 200 | NPO | 5 | 1875645 | Element14
50 | 150 | 1812 | 100 | Unknown | 10 | Ted
10 | 180 | 1206 | 630 | NPO | 5 | 2218879 | Element14
200 | 180 | 0805 | 50 | NPO | 5 | Glenn
5 | 220 | 1206 | 630 | NPO | 5 | 1907370 | Element14
10 | 220 | 1206 | 500 | NPO | 5 | 1216450 | Element14
18 | 220 | 1206 | 100 | NPO | 5 | RS | 126-455
3 | 270 | 1206 | 630 | NPO | 5 | 2218882 | Element14
5 | 330 | 1206 | 630 | NPO | 5 | 2057297 | Element14
25 | 330 | 1206 | 100 | NPO | 5 | RS | 126-461
8 | 450 | 1812 | 100 | Unknown | 10 | Ted
20 | 470 | 1206 | 200 | NPO | 5 | 1414735 | Element14
25 | 470 | 1206 | 100 | NPO | 5 | RS | 126-326
5 | 510 | 1206 | 50 | NPO | 5 | 1650955 | Element14
2 | 560 | 1206 | 630 | NPO | 5 | 2218889 | Element14
1 | 680 | 1206 | 200 | NPO | 5 | 1875398 | Element14
10 | 1000 | 1206 | 100 | NPO | 5 | 1171989 | Element14
11 | 1000 | 1206 | 100 | NPO | 5 | RS | 126-332
5 | 1000 | 1812 | 100 | Unknown | 10 | Ted
500 | 1000 | 0603 | Probably 50 | X7R | Probably 5 | Glenn
300 | 1000 | 0805 | Probably 50 | Probably NPO | Probably 5 | Glenn
500 | 1000 | 0805 | Probably 50 | X7R | Probably 5 | Glenn
3 | 1200 | 1206 | 630 | NPO | 5 | 2211024 | Element14
5 | 1500 | 1206 | 100 | NPO | 5 | 2112827 | Element14
5 | 1800 | 1206 | 630 | NPO | 5 | 445-4155-1-ND | DigiKey
2 | 1800 | 0805 | 100 | NPO | 5 | 2210941 | Element14
5 | 2000 | 0805 | 100 | NPO | 5 | 490-6447-1-ND | DigiKey
25 | 2200 | 1206 | 100 | NPO | 5 | RS | 126-348
2 | 3300 | 1206 | 630 | NPO | 5 | 1844422 | Element14
25 | 4700 | 1206 | 100 | NPO | 5 | RS | 126-376
5 | 6200 | 1206 | 50 | NPO | 5 | 490-1751-1-ND | DigiKey
12 | 8200 | 1206 | 50 | NPO | 5 | 490-1753-1-ND | DigiKey
5 | 9100 | 0806 | 50 | NPO | 5 | 490-1641-1-ND | DigiKey
25 | 10000 | 1206 | 100 | NPO | 5 | RS | 126-360
50 | 10000 | 1812 | 100 | Unknown | 10 | Ted
500 | 10000 | 0603 | Probably 50 | Probably NPO | Probably 5 | Glenn
500 | 10000 | 0603 | Probably 50 | Probably NPO | Probably 5 | Glenn
100 | 10000 | 0805 | Probably 50 | Probably NPO | Probably 5 | Glenn
25 | 22000 | 1206 | 100 | NPO | 5 | RS | 126-376
25 | 47000 | 1206 | 100 | NPO | 5 | RS | 126-382
50 | 47000 | 1812 | 100 | Unknown | 10 | Ted
25 | 100000 | 1206 | 100 | NPO | 5 | RS | 126-398
100 | 100000 | 0603 | Probably 50 | Probably NPO | Probably 5 | Glenn
25 | 220000 | 1206 | 100 | NPO | 5 | RS | 126-405
