radi8/-HL_TX-RX_Filters/Takashi Filters/170809_LPF_test_report.pdf

30/20M LPF experimental result | 6. Aug. 2017 ji1udd

### 8. Aug. 2017 Design parameter

FLEX-1500 filter parameter is used.
http://www.flexradio.com/downloads/flex-1500-service-manual-v-0-1-pdf

### Transmission loss

### Return loss

### Test path

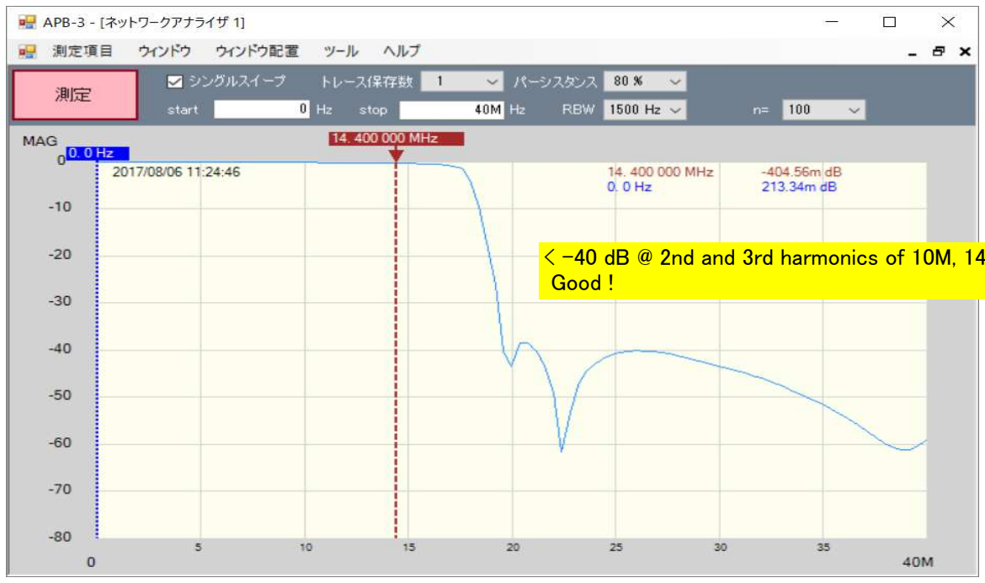
[picture p48: figure]
Good !

< -40 dB @ 2nd and 3rd harmonics of 10M, 14MHz

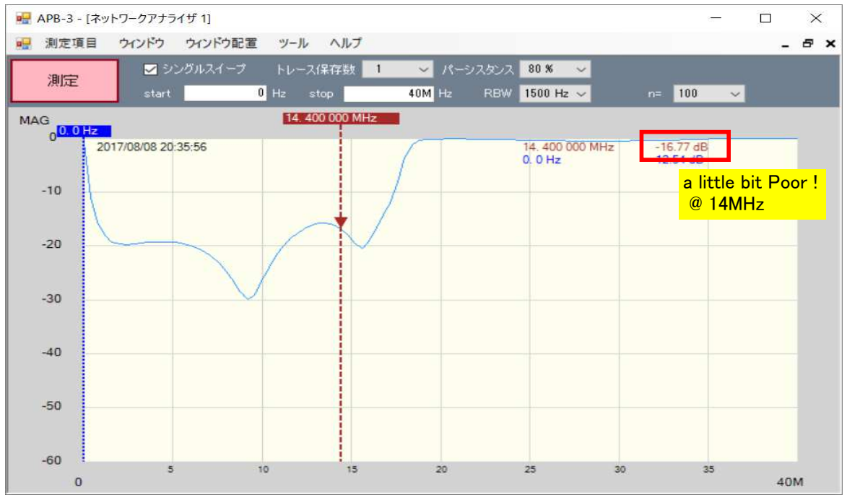
[picture p49: figure]
a little bit Poor ! @ 14MHz

### LPF

### LPF Relay

(ANT side)

### LPF part

### LPF Relay

(HL side)

T/R

### Relay

40M LPF experimental result | 8. Aug. 2017 ji1udd

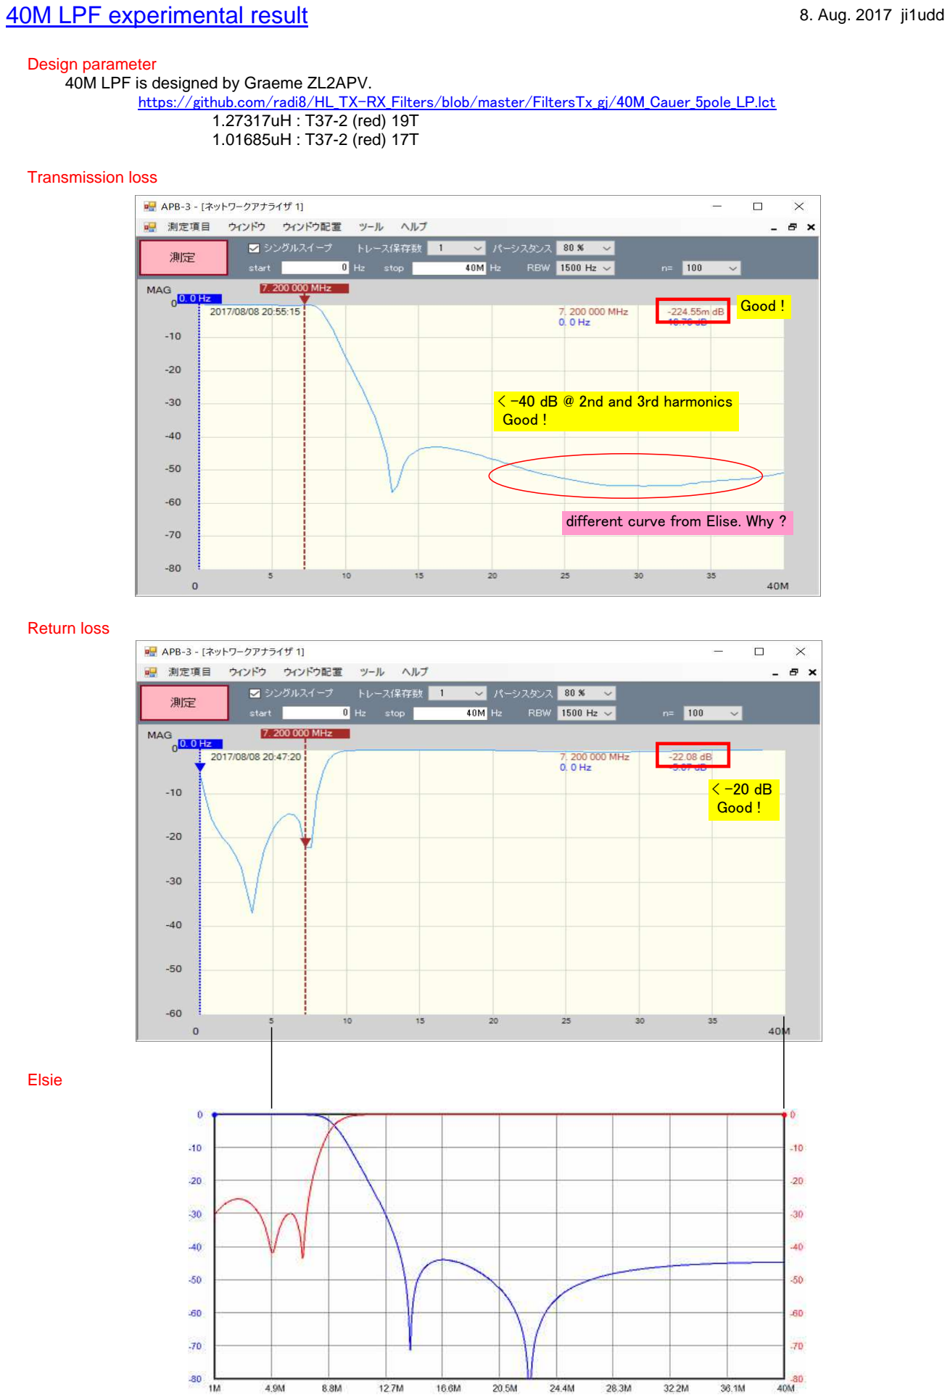
[picture p50: page 2]

### Design parameter

40M LPF is designed by Graeme ZL2APV.
https://github.com/radi8/HL_TX-RX_Filters/blob/master/FiltersTx_gj/40M_Cauer_5pole_LP.lct

### 1.27317uH : T37-2 (red) 19T 1.01685uH : T37-2 (red) 17T

### Transmission loss

### Return loss

### Elsie

< -20 dB
Good !

Good !

< -40 dB @ 2nd and 3rd harmonics Good !

different curve from Elise. Why ?
