radi8/-HL_TX-RX_Filters/Takashi Filters/80M_Rx_HPF＋30-20M_LPF_test_report.pdf

80M Rx HPF + 30/20M LPF test report | 6. Aug. 2017 ji1udd

(*1) 80M Rx HPF is designed by Graeme ZL2APV.
https://github.com/radi8/HL_TX-RX_Filters/blob/master/FiltersRx_gj/80M_Cauer_5pole_HP.lct

(*2) 30/20M LPF: FLEX-1500 filter parameter is used.
http://www.flexradio.com/downloads/flex-1500-service-manual-v-0-1-pdf

Rx path #1
3.5MHz HPF is ON

30/20M
LPF
(*2)

LPF
Relay
(ANT side)
LPF part

LPF
Relay
(HL side)

T/R
Relay

HPF
SW
(ANT side)

3.5MHz
HPF
(*1)

HPF
SW
(HL side)
HPF part

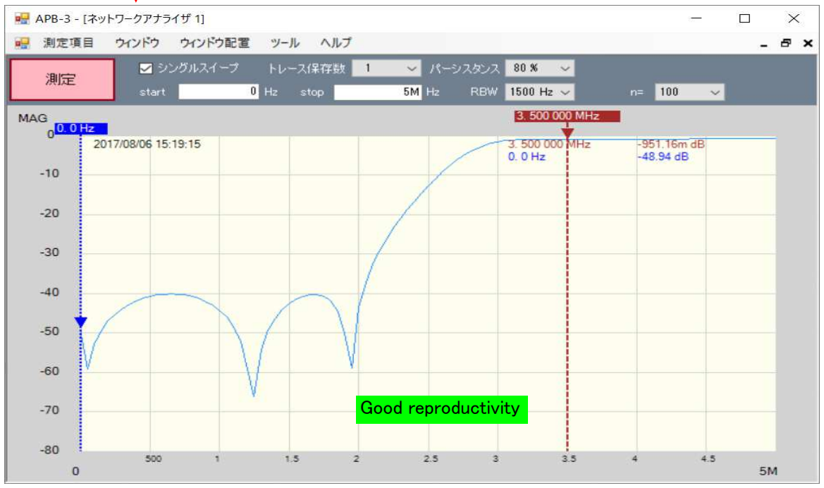
[picture p51: figure]
Good reproductivity

HPF
loss
@14.4MHz
0.1dB

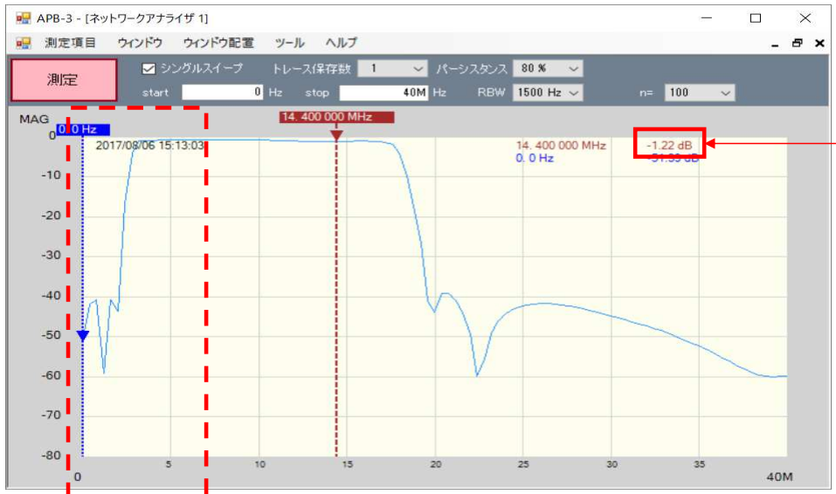
[picture p52: figure]

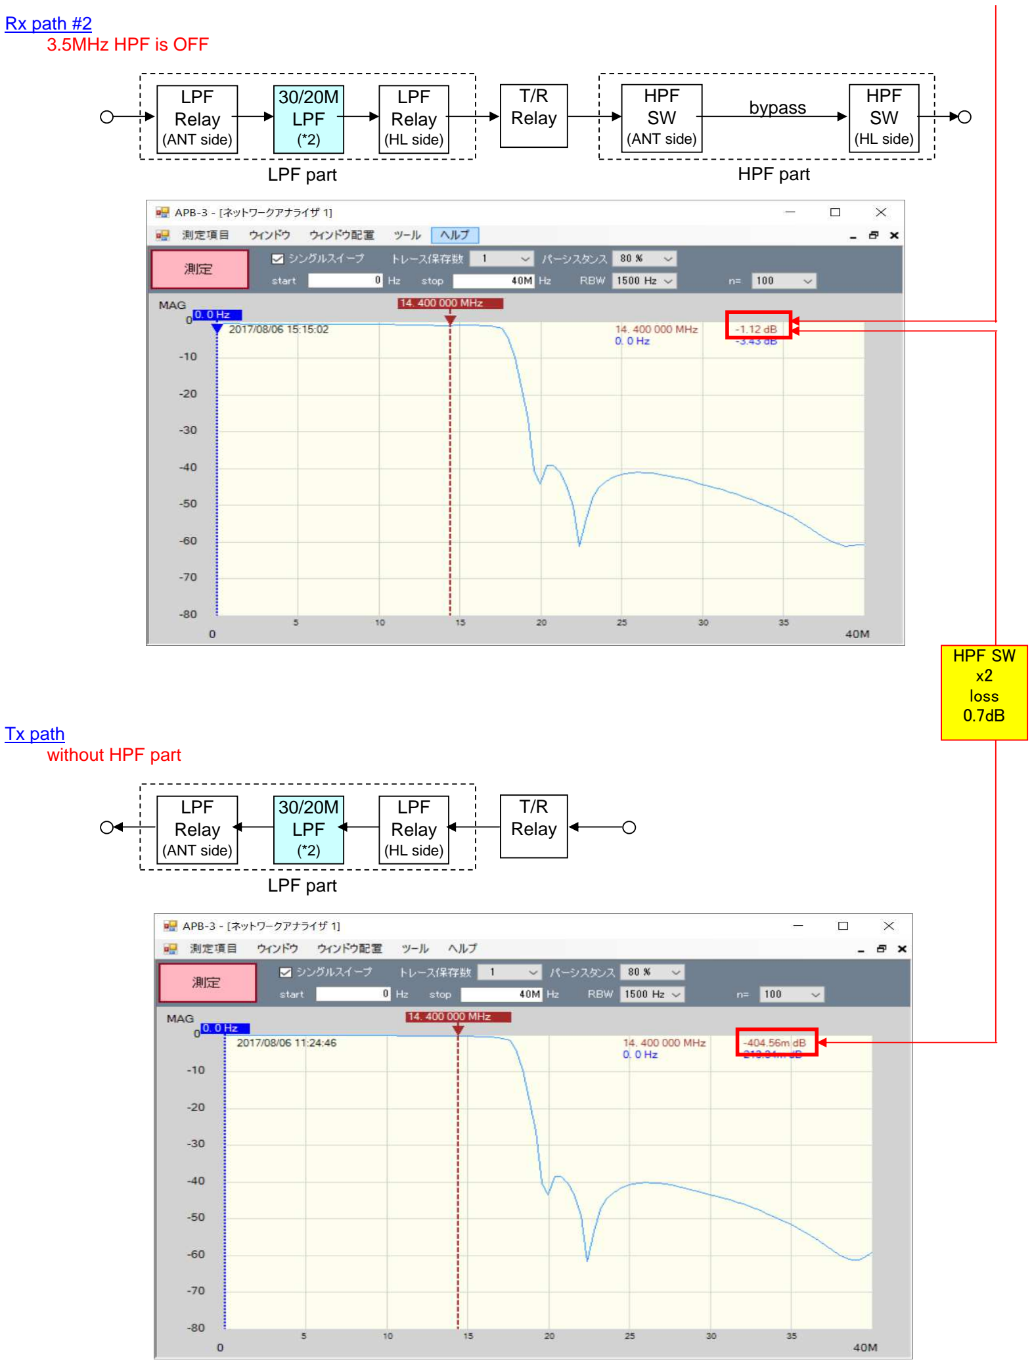
[picture p53: figure]
Rx path #2 3.5MHz HPF is OFF; Tx path without HPF part; 30/20M LPF (*2); LPF Relay (ANT side); LPF part; LPF Relay (HL side); T/R Relay; HPF SW (ANT side); HPF SW (HL side); HPF part; bypass; HPF SW x2 loss 0.7dB
