radi8/-HL_TX-RX_Filters/Takashi Filters/TestData/Rx_Noise_AL-Shield_effect.pdf

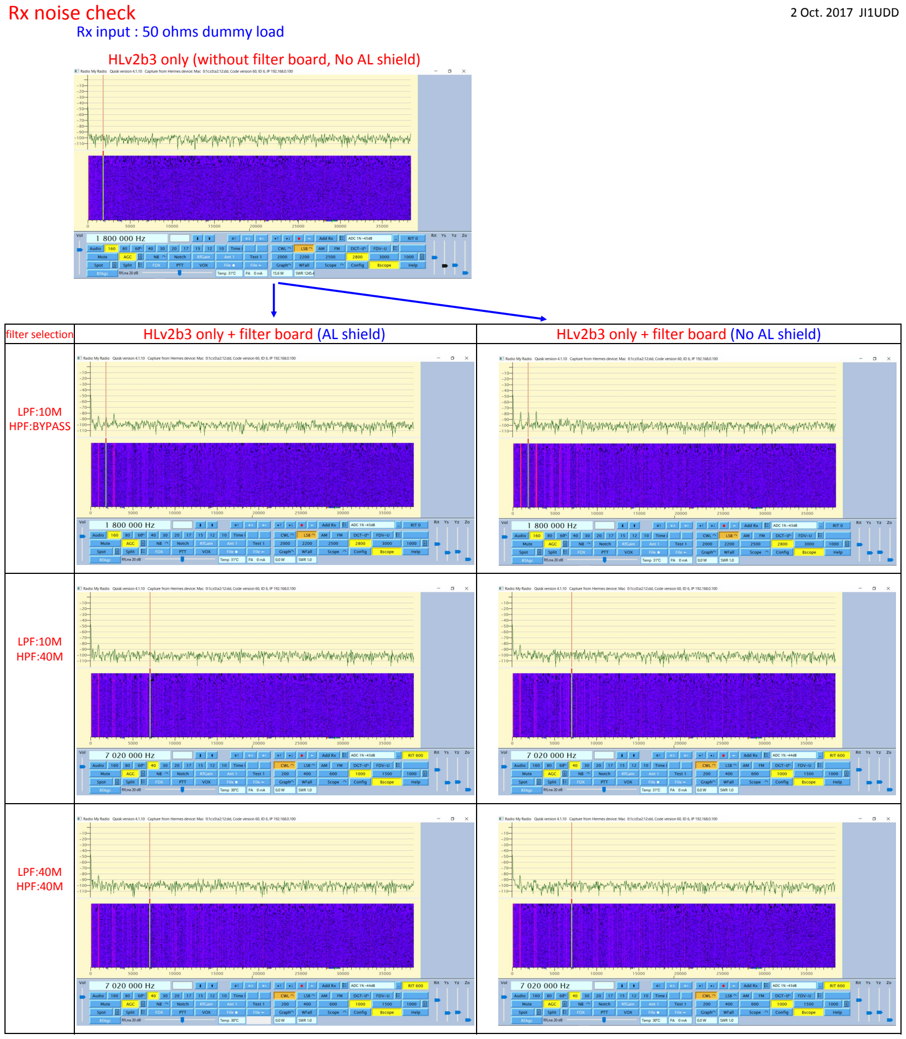
[picture p54: page 1]

Rx noise check | 2 Oct. 2017 JI1UDD
Rx input : 50 ohms dummy load
filter selection | HLv2b3 only + filter board (AL shield) | HLv2b3 only + filter board (No AL shield)

LPF:10M HPF:BYPASS

LPF:10M HPF:40M

LPF:40M HPF:40M

HLv2b3 only (without filter board, No AL shield)
