radi8/-HL_TX-RX_Filters/Takashi Filters/TestData/2_plus_ALshield.jpg

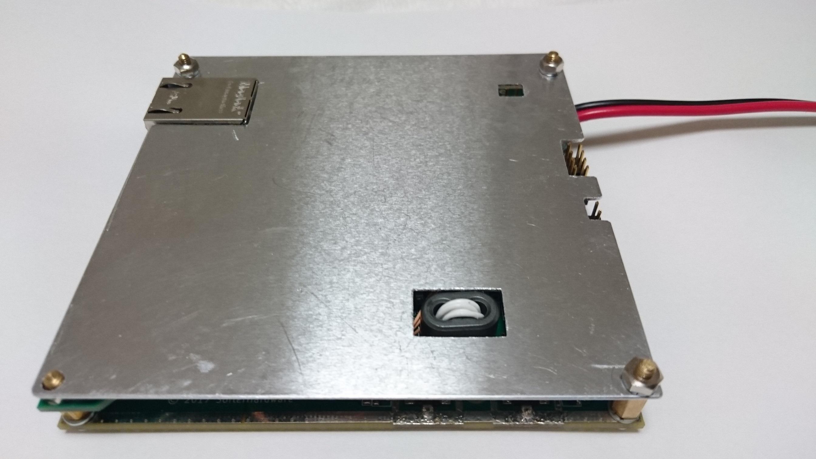
Takashi Filters/TestData/2_plus_ALshield.jpg
