radi8/-HL_TX-RX_Filters/Takashi Filters/TestData/3_plus_Filter.jpg

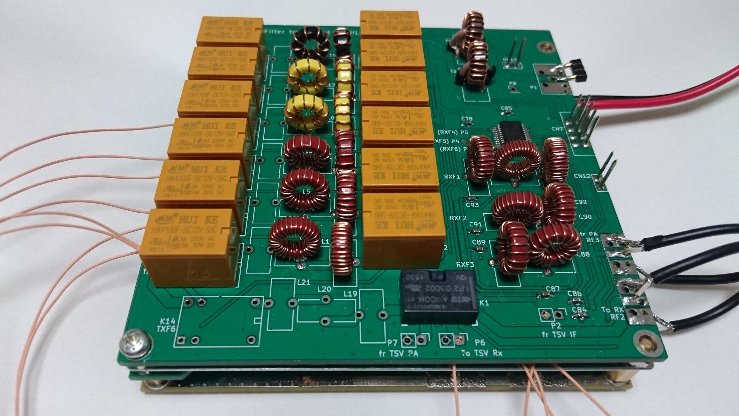
Takashi Filters/TestData/3_plus_Filter.jpg
