radi8/-HL_TX-RX_Filters/Bias PSU/LM2587 50v.pdf

## WEBENCH ® Design Report

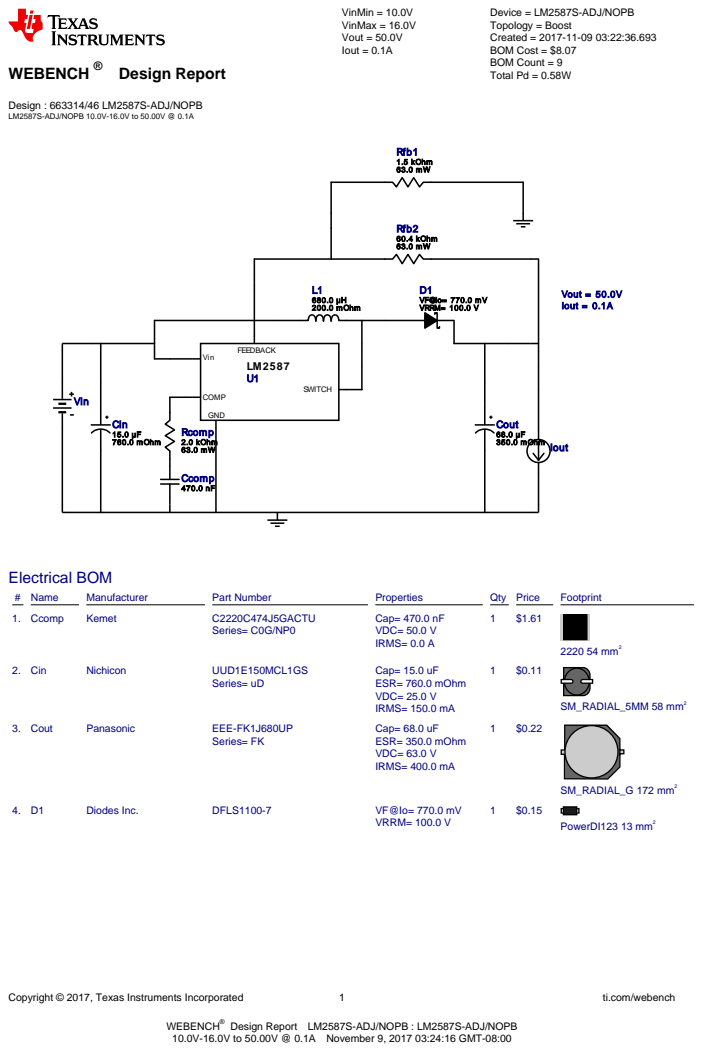
[picture p57: page 1]
Copyright © 2017, Texas Instruments Incorporated; ti.com/webench; VinMin = 10.0V VinMax = 16.0V Vout = 50.0V Iout = 0.1A; Ccomp 470.0 nF; Rcomp 2.0 kOhm 63.0 mW; Cin 15.0 µF 760.0 mOhm; Cout 68.0 µF 350.0 mOhm; D1 VF@Io= 770.0 mV VRRM= 100.0 V; L1 680.0 µH 200.0 mOhm; FEEDBACK; Vin; COMP; SWITCH; GND; Vout = 50.0V Iout = 0.1A; Rfb1 1.5 kOhm 63.0 mW; Rfb2 60.4 kOhm 63.0 mW; Iout; Electrical BOM; # Name; Manufacturer; Part Number; Properties; Qty Price; Footprint; 1. Ccomp; Kemet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

Device = LM2587S-ADJ/NOPB
Topology = Boost
Created = 2017-11-09 03:22:36.693
BOM Cost = $8.07
BOM Count = 9
Total Pd = 0.58W

Design : 663314/46 LM2587S-ADJ/NOPB
LM2587S-ADJ/NOPB 10.0V-16.0V to 50.00V @ 0.1A

WEBENCH®
10.0V-16.0V to 50.00V @ 0.1A November 9, 2017 03:24:16 GMT-08:00

Design Report LM2587S-ADJ/NOPB : LM2587S-ADJ/NOPB

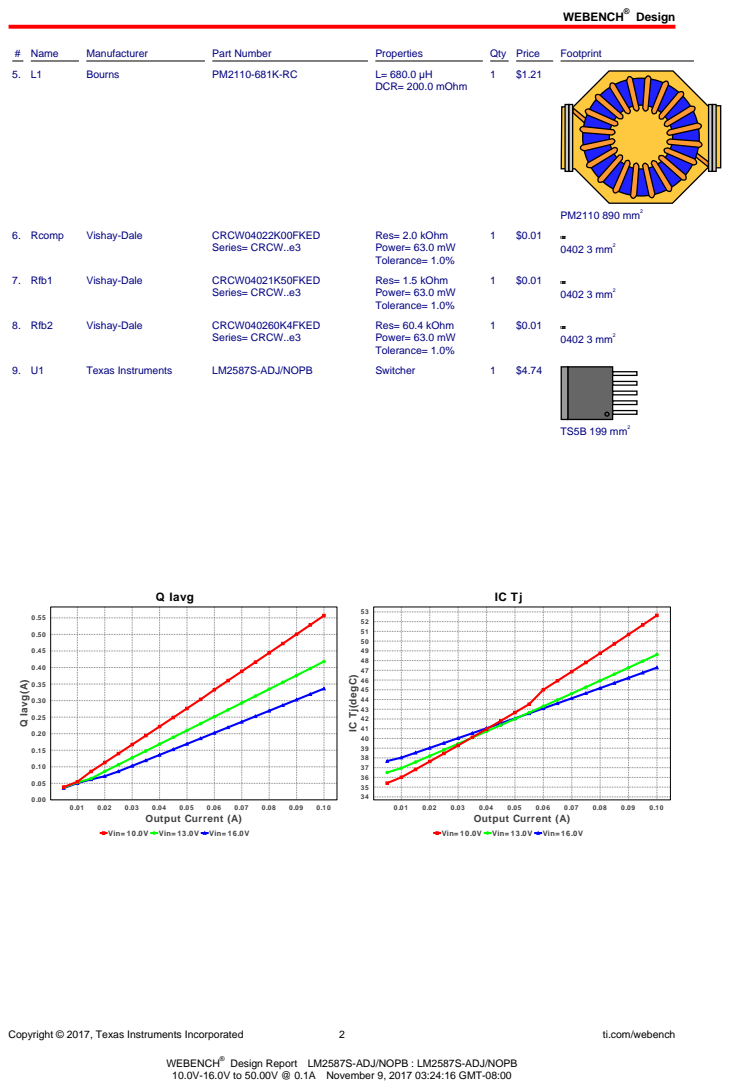
[picture p58: page 2]
Design; Copyright © 2017, Texas Instruments Incorporated; ti.com/webench; # Name; Manufacturer; Part Number; Properties; Qty Price; Footprint; Bourns; DCR= 200.0 mOhm; PM2110 890 mm²; 6. Rcomp; Vishay-Dale; CRCW04022K00FKED; Series= CRCW..e3; Res= 2.0 kOhm Power= 63.0 mW Tolerance= 1.0%; 0402 3 mm²; 7. Rfb1; CRCW04021K50FKED; Res= 1.5 kOhm Power= 63.0 mW Tolerance= 1.0%; 8. Rfb2; CRCW040260K4FKED; Res= 60.4 kOhm Power= 63.0 mW Tolerance= 1.0%; Texas Instruments; LM2587S-ADJ/NOPB; Switcher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

IC Tj(degC)

Vin= 10.0V Vin= 13.0V Vin= 16.0V

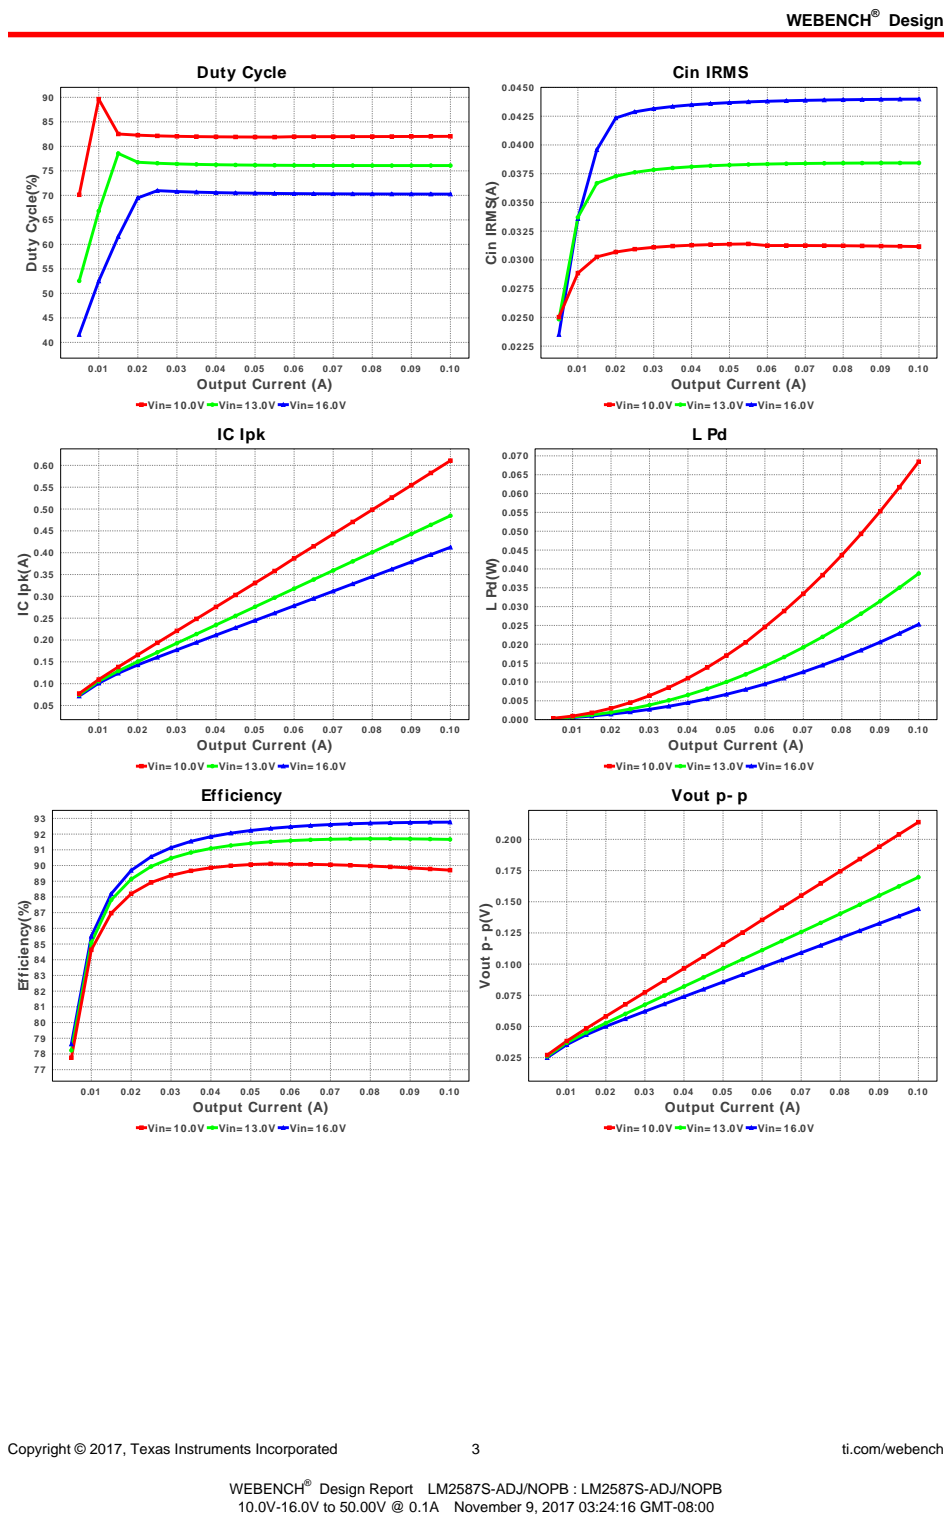
[picture p59: page 3]
Copyright © 2017, Texas Instruments Incorporated; ti.com/webench; Duty Cycle; 0.10 Output Current (A); Duty Cycle(%); Cin IRMS; Cin IRMS(A); IC Ipk; IC Ipk(A); Efficiency(%); Vout p- p(V)

Vin= 10.0V Vin= 13.0V Vin= 16.0V

Efficiency

Vout p- p

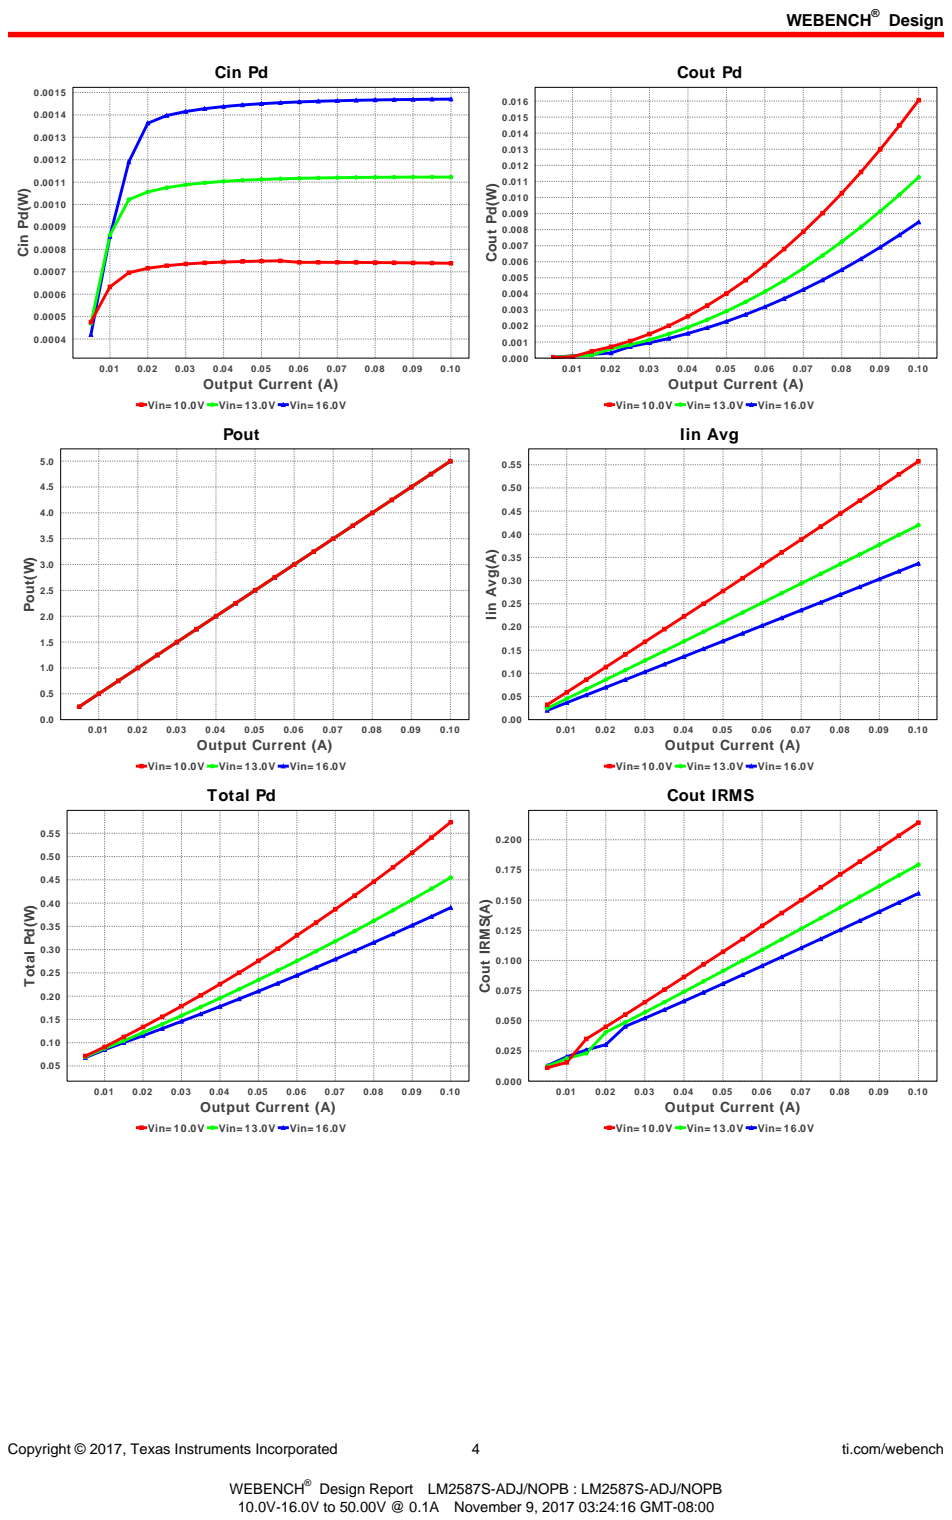
[picture p60: page 4]
Copyright © 2017, Texas Instruments Incorporated; ti.com/webench; Cin Pd; 0.10 Output Current (A); Cin Pd(W); Cout Pd; Cout Pd(W); Pout; Pout(W); Iin Avg; Iin Avg(A); Total Pd; Total Pd(W); Cout IRMS(A)

Vin= 10.0V Vin= 13.0V Vin= 16.0V

Cout IRMS

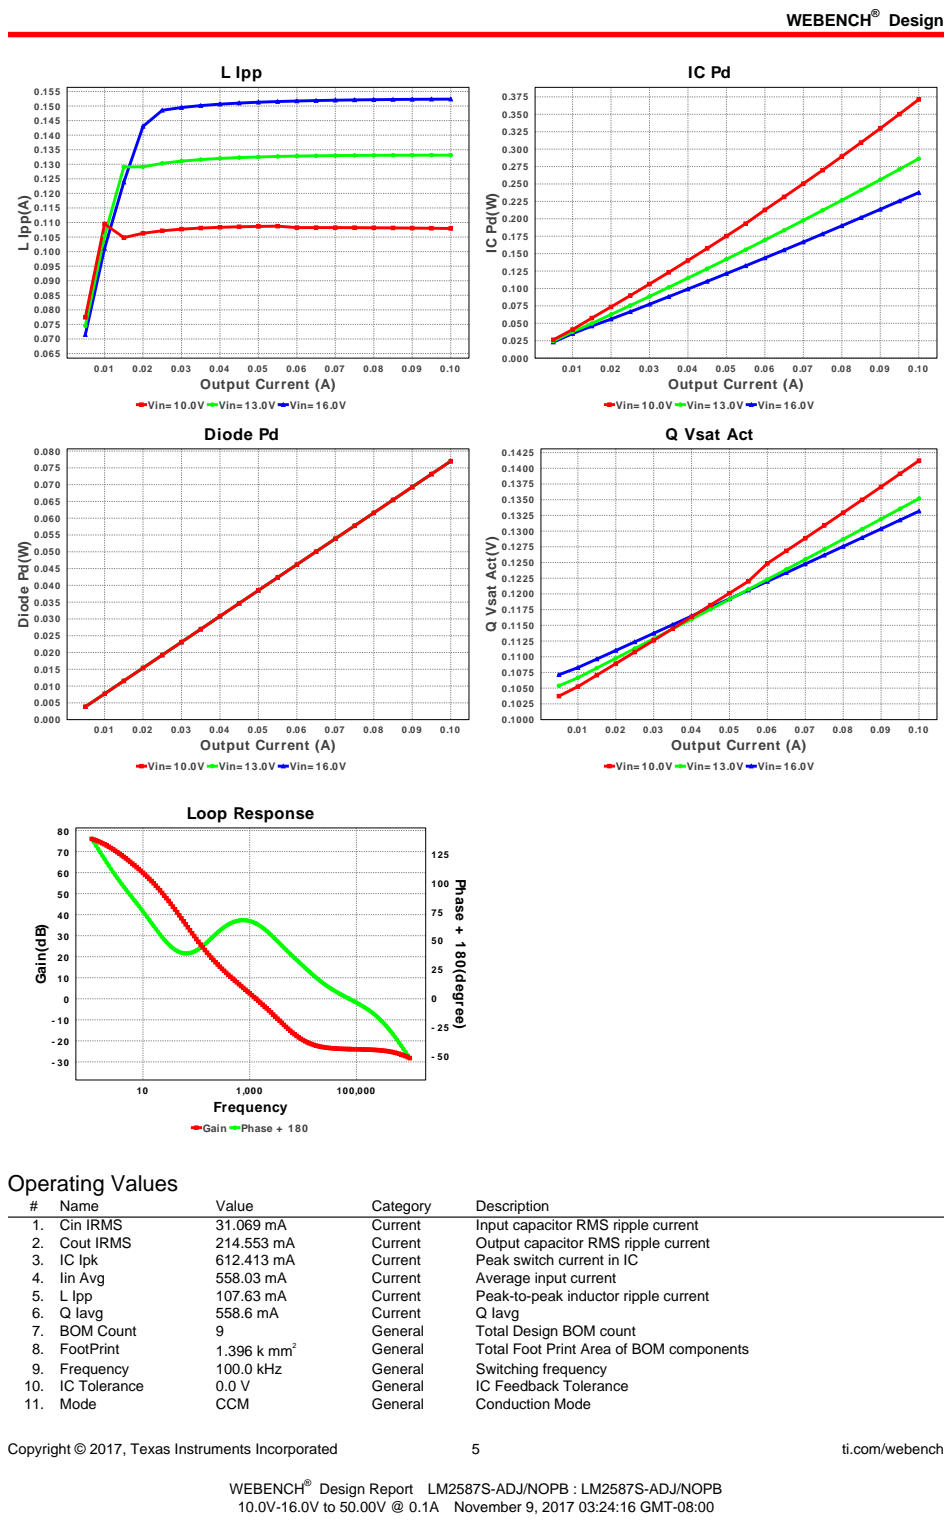
[picture p61: page 5]
Copyright © 2017, Texas Instruments Incorporated; ti.com/webench; L Ipp; 0.10 Output Current (A); L Ipp(A); Diode Pd(W); Q Vsat Act(V); Loop Response; Gain Phase + 180; 100,000 Frequency; Gain(dB); Phase + 180(degree); Operating Values; Name; Value; Category; Description; 1. Cin IRMS; Current; Input capacitor RMS ripple current; 2. Cout IRMS; Output capacitor RMS ripple current; 3. IC Ipk; Peak switch current in IC; 4. Iin Avg; Average input current; 5. L Ipp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

Vin= 10.0V Vin= 13.0V Vin= 16.0V
Diode Pd

Q Vsat Act

Copyright © 2017, Texas Instruments Incorporated | 6 | ti.com/webench
# | Name | Value | Category | Description

12. Pout | 5.0 W | General | Total output power
13. Q Vsat Act | 151.306 mV | General | Q Vsat
14. Total BOM | $8.07 | General | Total BOM Cost
15. Low Freq Gain | 77.753 dB | Op_Point | Gain at 1Hz
16. Vout Actual | 50.758 V | Op_Point | Vout Actual calculated based on selected voltage divider resistors
17. Cross Freq | 843.776 Hz | Op_point | Bode plot crossover frequency
18. Duty Cycle | 82.098 % | Op_point | Duty cycle
19. Efficiency | 89.601 % | Op_point | Steady state efficiency
20. Gain Marg | -18.487 dB | Op_point | Bode Plot Gain Margin
21. IC Tj | 59.371 degC | Op_point | IC junction temperature
22. ICThetaJA | 40.0 degC/W | Op_point | IC junction-to-ambient thermal resistance
23. IOUT_OP | 100.0 mA | Op_point | Iout operating point
24. Phase Marg | 59.961 deg | Op_point | Bode Plot Phase Margin
25. VIN_OP | 10.0 V | Op_point | Vin operating point
26. Vout p-p | 214.345 mV | Op_point | Peak-to-peak output ripple voltage
27. Cin Pd | 733.619 µW | Power | Input capacitor power dissipation
28. Cout Pd | 16.111 mW | Power | Output capacitor power dissipation
29. Diode Pd | 77.0 mW | Power | Diode power dissipation
30. IC Pd | 377.215 mW | Power | IC power dissipation
31. L Pd | 68.86 mW | Power | Inductor power dissipation
32. Total Pd | 580.295 mW | Power | Total Power Dissipation
33. Vout Tolerance | 1.971 % | Vout Tolerance based on IC Tolerance (no load) and voltage divider
| | | | resistors if applicable

## Design Inputs

# | Name | Value | Description

1. Iout | 100.0 m | Maximum Output Current
2. VinMax | 16.0 | Maximum input voltage
3. VinMin | 10.0 | Minimum input voltage
4. Vout | 50.0 | Output Voltage
5. base_pn | LM2587 | Base Product Number
6. source | DC | Input Source Type
7. Ta | 30.0 | Ambient temperature

## Design Assistance

1. LM2587 Product Folder : http://www.ti.com/product/LM2587 : contains the data sheet and other resources.

Texas Instruments' WEBENCH simulation tools attempt to recreate the performance of a substantially equivalent physical implementation
of the design. Simulations are created using Texas Instruments' published specifications as well as the published specifications of other device manufacturers. While Texas Instruments does update this information periodically, this information may not be current at the time the simulation is built. Texas Instruments does not warrant the accuracy or completeness of the specifications or any information contained therein. Texas Instruments does not warrant that any designs or recommended parts will meet the specifications you entered, will be suitable for your application or fit for any particular purpose, or will operate as shown in the simulation in a physical implementation. Texas Instruments does not warrant that the designs are production worthy.
You should completely validate and test your design implementation to confirm the system functionality for your application prior to production.
Use of Texas Instruments' WEBENCH simulation tools is subject to Texas Instruments' Site Terms and Conditions of Use. (http://www.ti.com/corp/docs/legal/termsofuse.shtml) Prototype boards based on WEBENCH created designs are provided AS IS without warranty of any kind for evaluation and testing purposes and are subject to the terms of the Evaluation License Agreement. (http://www.ti.com/corp/docs/legal/termsofuse_estore.shtml)
