radi8/-HL_TX-RX_Filters/Bias PSU/LM3478 120v.pdf

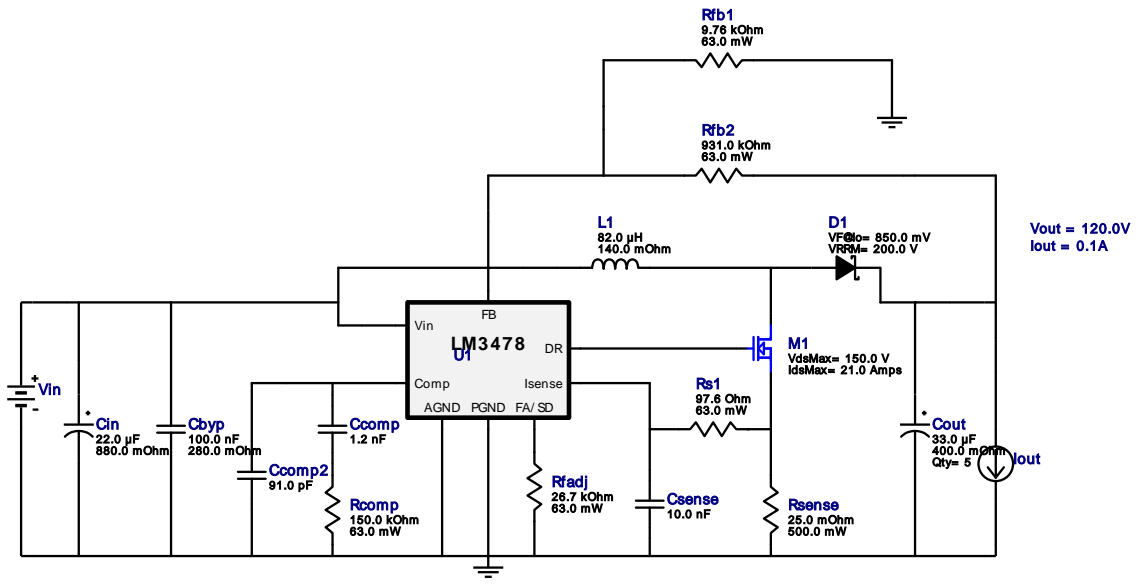
[picture p62: figure]
Cbyp 100.0 nF 280.0 mOhm; Ccomp 1.2 nF; Ccomp2 91.0 pF; Cin 22.0 µF 880.0 mOhm; Cout 33.0 µF 400.0 mOhm Qty= 5; Csense 10.0 nF; D1 VF@Io= 850.0 mV VRRM= 200.0 V; L1 82.0 µH 140.0 mOhm; M1 VdsMax= 150.0 V IdsMax= 21.0 Amps; Rcomp 150.0 kOhm 63.0 mW; Rfadj 26.7 kOhm 63.0 mW; Rs1 97.6 Ohm 63.0 mW; Rsense 25.0 mOhm 500.0 mW; Comp; Isense; AGND PGND; Vin; Vout = 120.0V Iout = 0.1A; Rfb1 9.76 kOhm 63.0 mW; Rfb2 931.0 kOhm 63.0 mW; Iout

Copyright © 2018, Texas Instruments Incorporated | 1 | ti.com/webench

WEBENCH®
Design Report LM3478MMX/NOPB : LM3478MMX/NOPB 10.0V-16.0V to 120.00V @ 0.1A March 11, 2018 12:06:37 GMT-07:00

## WEBENCH ® Design Report

Design : 663314/58 LM3478MMX/NOPB
LM3478MMX/NOPB 10.0V-16.0V to 120.00V @ 0.1A

VinMin = 10.0V
VinMax = 16.0V
Vout = 120.0V
Iout = 0.1A

Device = LM3478MMX/NOPB
Topology = Boost
Created = 2018-03-11 12:06:07.841 BOM Cost = $8.77
BOM Count = 20
Total Pd = 1.67W
1. With the low turn of voltage of the LM34x8 your power supply may current limit before you reach your working input voltage. If this happens, or to preempt this from happening, you can include a low pass RC filter from input voltage to Vin on the IC. Make sure the rise time on the RC network is slower than your supply's rise time.

### My Comments

No comments

## Electrical BOM

# Name | Manufacturer | Part Number | Properties | Qty Price | Footprint

1. Cbyp | AVX | 08053C104KAT2A (http://datasheets.avx.com/X7RDielectric.pdf) Series= X7R | Cap= 100.0 nF ESR= 280.0 mOhm VDC= 25.0 V IRMS= 0.0 A
1 | $0.01
| | | | | 0805 7 mm²
2. Ccomp | Samsung Electro- Mechanics | CL21C122JBFNNWE (http://www.samsungsem.com/servlet/FileDownload?type%3Dspec%26file%3DCL21C122JBFNNWE.pdf) Series= C0G/NP0

Cap= 1.2 nF
VDC= 50.0 V
IRMS= 0.0 A

1 $0.01
0805 7 mm²
3. Ccomp2 | Samsung Electro- Mechanics | CL21C910JBANNNC (http://www.samsungsem.com/servlet/FileDownload?type%3Dspec%26file%3DCL21C910JBANNNC.pdf) Series= C0G/NP0

Cap= 91.0 pF
VDC= 50.0 V
IRMS= 0.0 A

1 $0.01
0805 7 mm²
4. Cin | Nichicon | UUD1H220MCL1GS (http://products.nichicon.co.jp/en/pdf/XJA043/e%2Dud.pdf) Series= uD

Cap= 22.0 uF
ESR= 880.0 mOhm
VDC= 50.0 V
IRMS= 165.0 mA

1 $0.09

SM_RADIAL_6.3AMM 80
mm²
5. Cout | Panasonic | EEV-EB2E330SM (http://industrial.panasonic.com/www%2Ddata/pdf/ABA0000/ABA0000CE11.pdf) Series= ?

Cap= 33.0 uF
ESR= 400.0 mOhm
VDC= 250.0 V
IRMS= 560.0 mA

5 $1.31

EB_K16 483 mm²

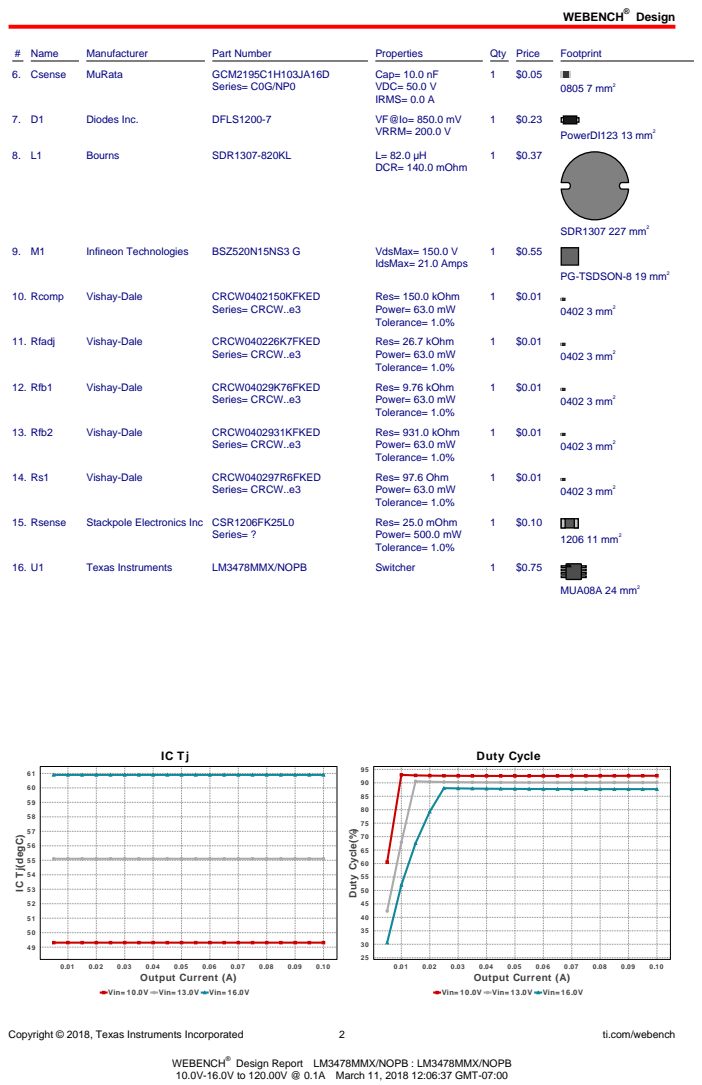
[picture p63: page 2]
Design; Copyright © 2018, Texas Instruments Incorporated; ti.com/webench; # Name; Manufacturer; Part Number; Properties; Qty Price; Footprint; 6. Csense; MuRata; GCM2195C1H103JA16D; Series= C0G/NP0; Cap= 10.0 nF VDC= 50.0 V IRMS= 0.0 A; 0805 7 mm²; Diodes Inc.; DFLS1200-7; VRRM= 200.0 V; PowerDI123 13 mm²; Bourns; SDR1307-820KL; DCR= 140.0 mOhm; SDR1307 227 mm²; Infineon Technologies; BSZ520N15NS3 G; VdsMax= 150.0 V; IdsMax= 21.0 Amps; 10. Rcomp; Vishay-Dale; CRCW0402150KFKED; Series= CRCW..e3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

PG-TSDSON-8 19 mm²

IC Tj(degC)

Vin= 10.0V Vin= 13.0V Vin= 16.0V

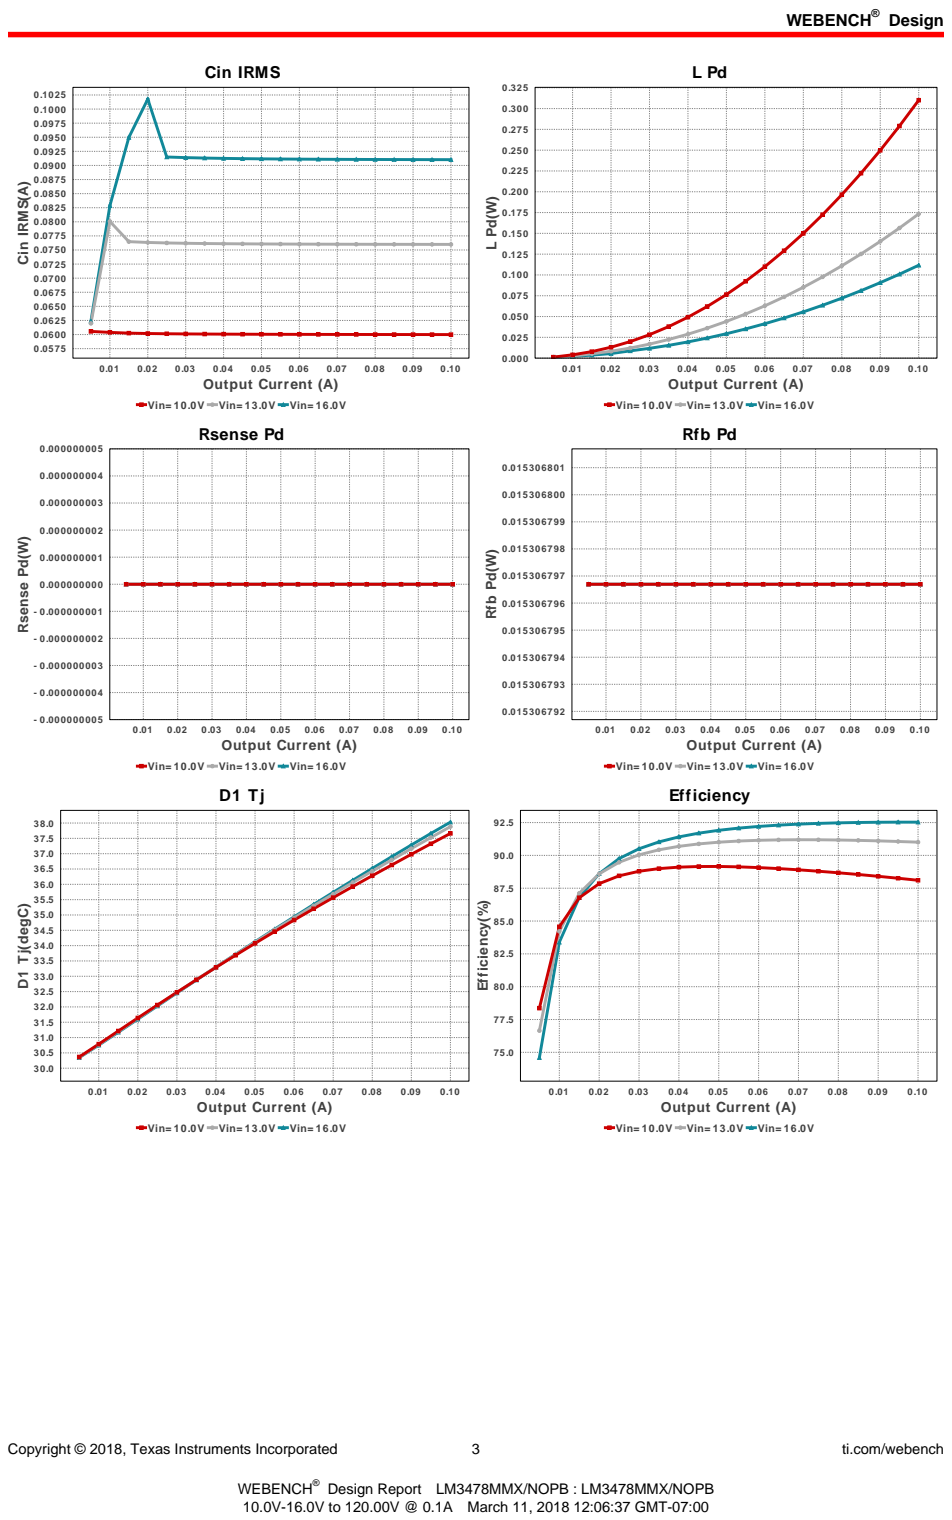
[picture p64: page 3]
Copyright © 2018, Texas Instruments Incorporated; ti.com/webench; Cin IRMS; 0.10 Output Current (A); Cin IRMS(A); Rsense Pd(W); Rfb Pd; Rfb Pd(W); D1 Tj(degC); Efficiency(%)

Vin= 10.0V Vin= 13.0V Vin= 16.0V
Rsense Pd

Efficiency

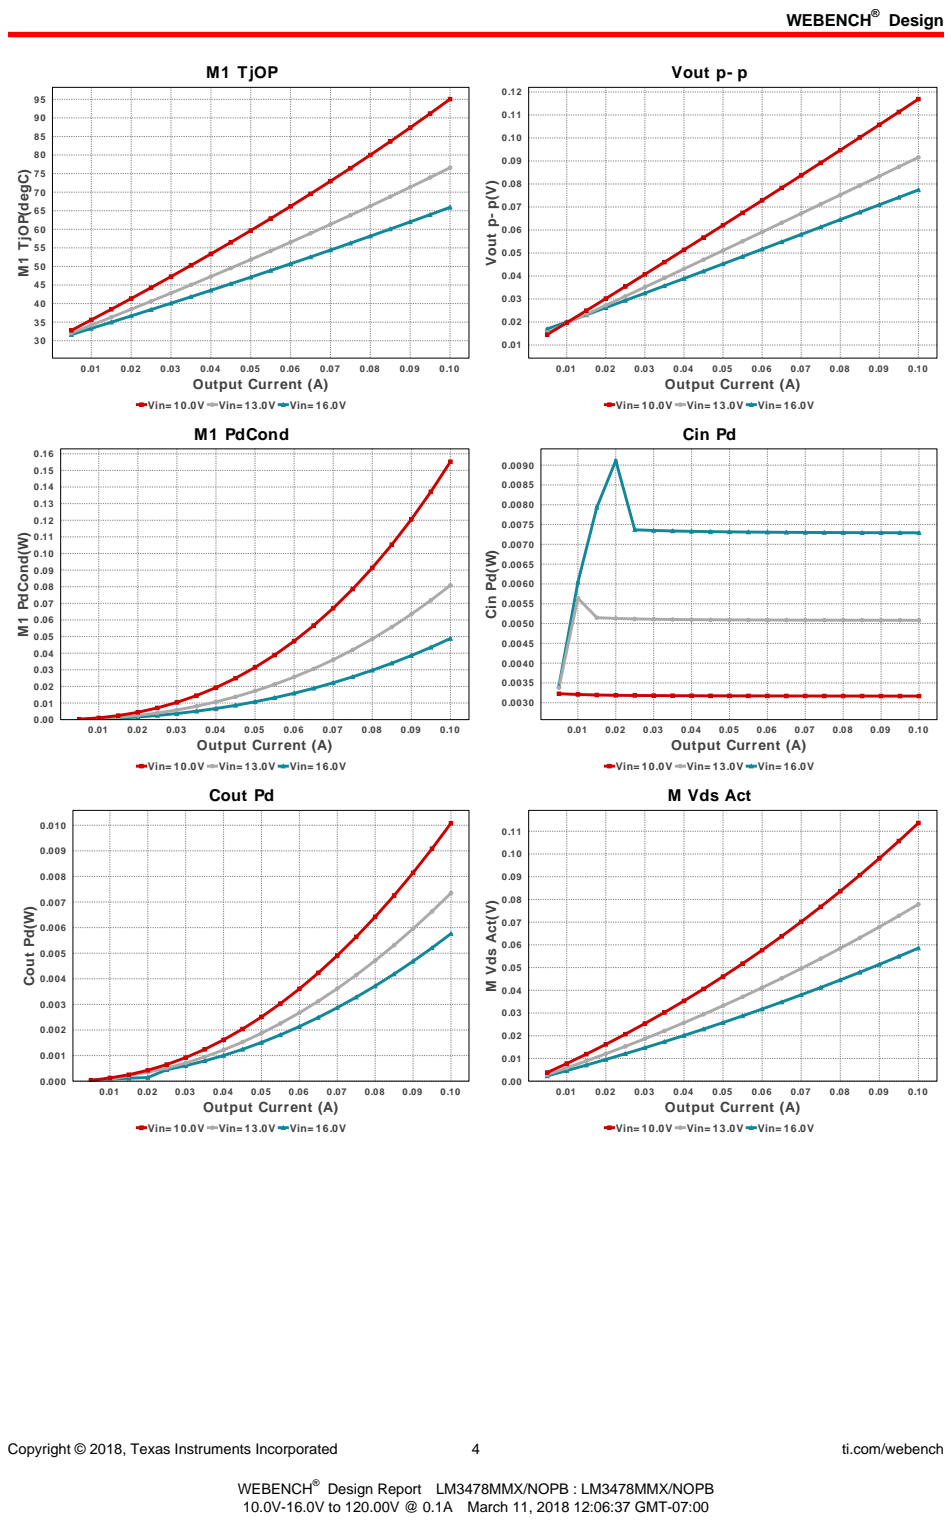
[picture p65: page 4]
Copyright © 2018, Texas Instruments Incorporated; ti.com/webench; M1 TjOP; 0.10 Output Current (A); M1 TjOP(degC); Vout p- p; Vout p- p(V); M1 PdCond(W); Cin Pd; Cin Pd(W); Cout Pd; Cout Pd(W); M Vds Act(V)

Vin= 10.0V Vin= 13.0V Vin= 16.0V
M1 PdCond

M Vds Act

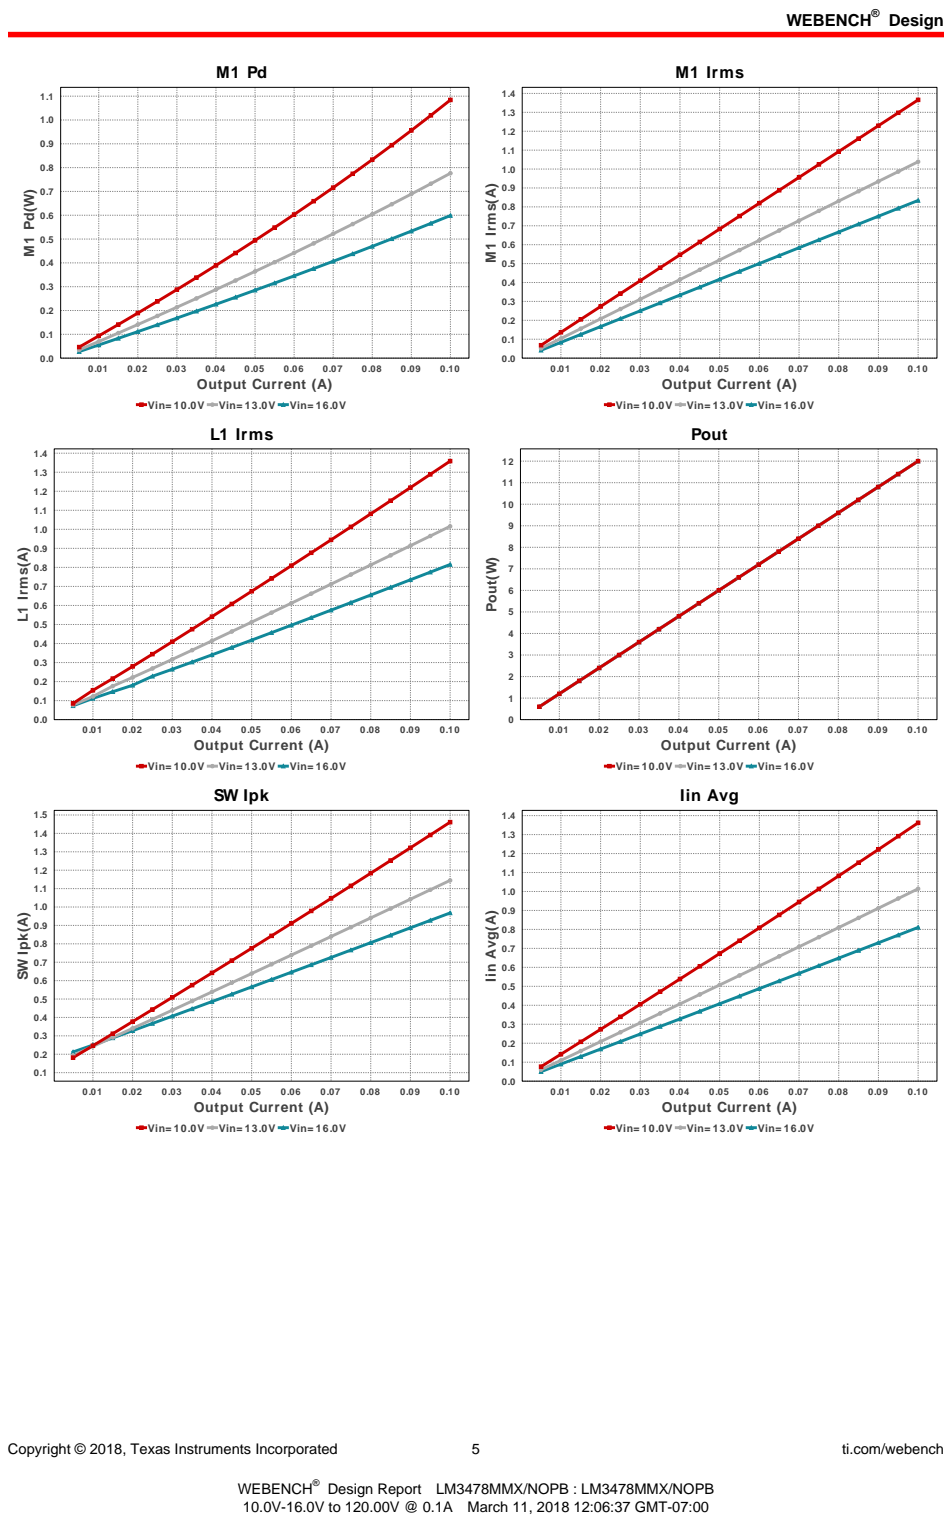
[picture p66: page 5]
Copyright © 2018, Texas Instruments Incorporated; ti.com/webench; 0.10 Output Current (A); M1 Irms; M1 Irms(A); L1 Irms; L1 Irms(A); Pout; Pout(W); SW Ipk; SW Ipk(A); Iin Avg; Iin Avg(A)

Vin= 10.0V Vin= 13.0V Vin= 16.0V

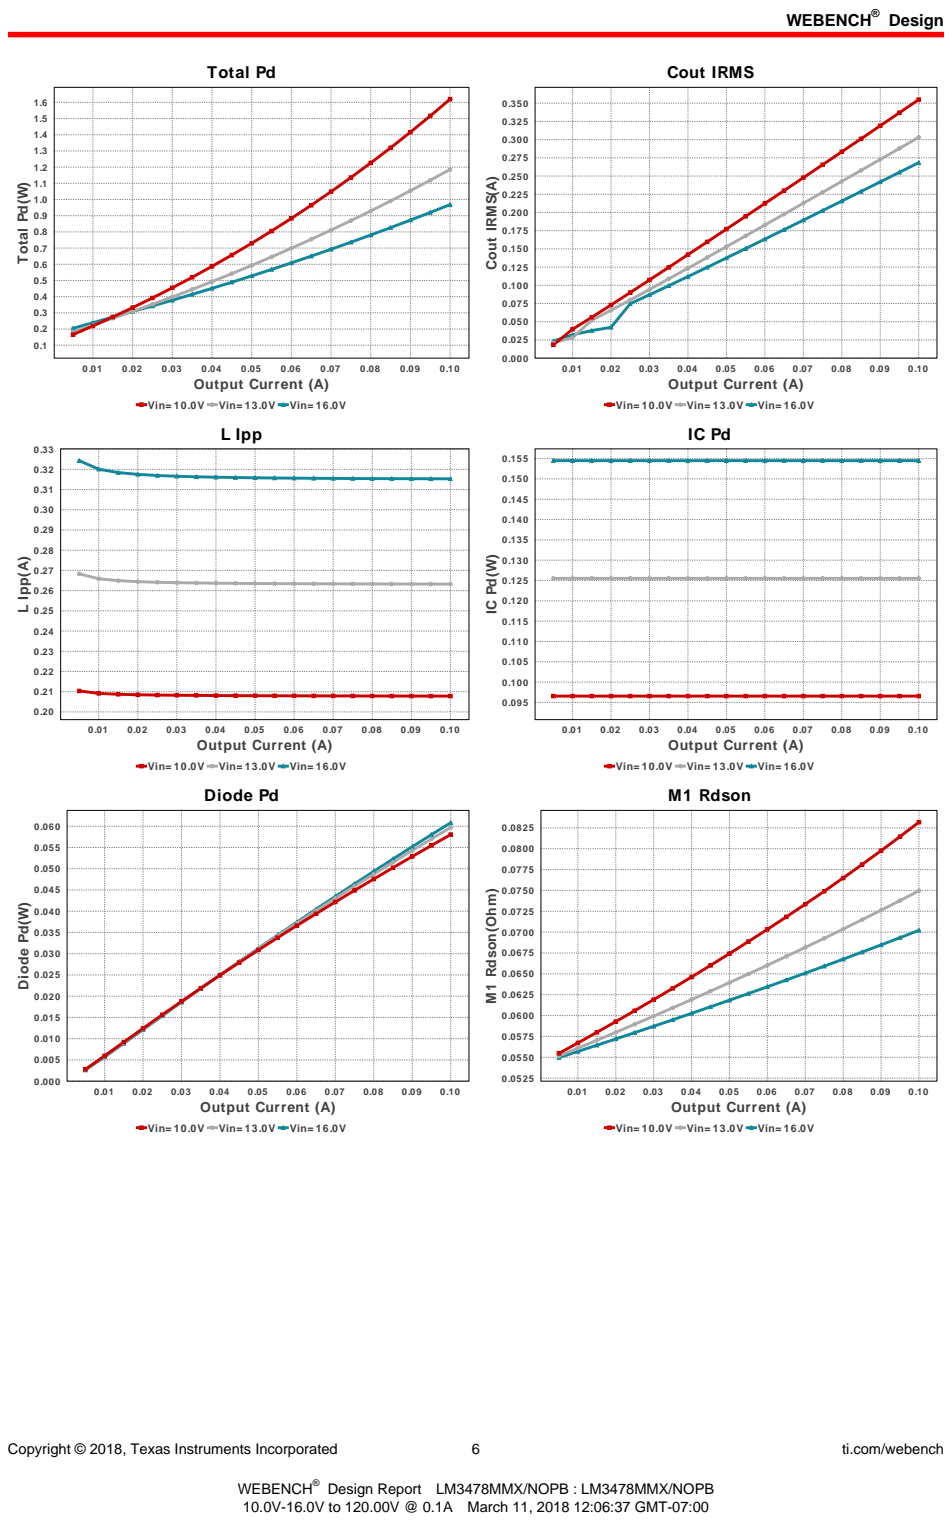
[picture p67: page 6]
Copyright © 2018, Texas Instruments Incorporated; ti.com/webench; Total Pd; 0.10 Output Current (A); Total Pd(W); Cout IRMS; Cout IRMS(A); L Ipp; L Ipp(A); Diode Pd(W); M1 Rdson(Ohm)

Vin= 10.0V Vin= 13.0V Vin= 16.0V

Diode Pd

M1 Rdson

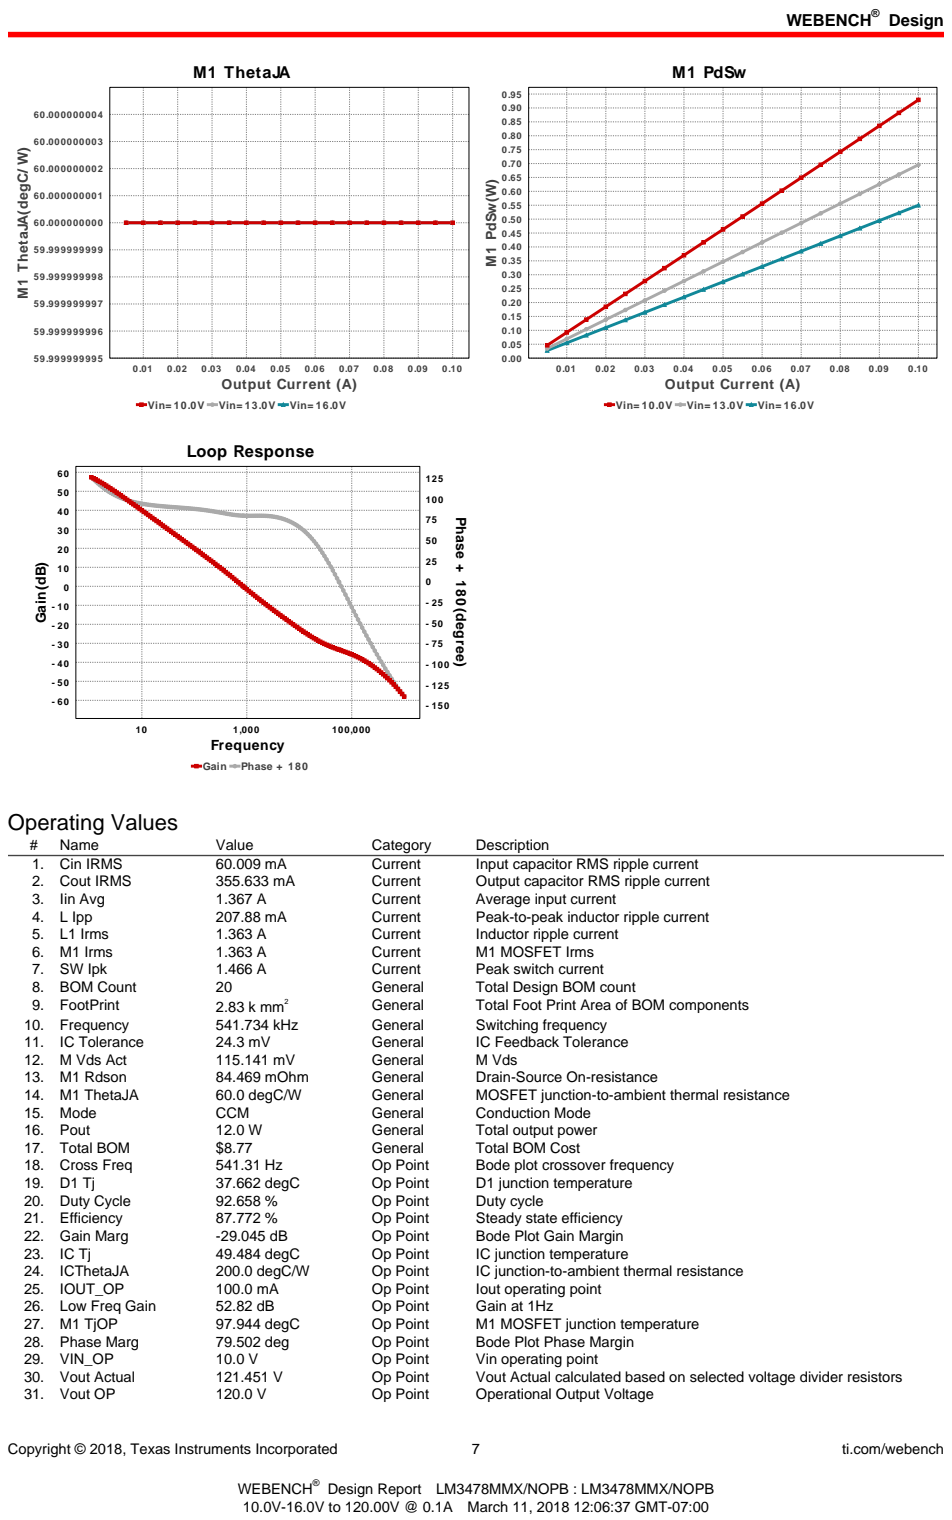
[picture p68: page 7]
Copyright © 2018, Texas Instruments Incorporated; ti.com/webench; M1 ThetaJA; 0.10 Output Current (A); M1 ThetaJA(degC/ W); M1 PdSw; M1 PdSw(W); Loop Response; Gain Phase + 180; 100,000 Frequency; Gain(dB); Phase + 180(degree); Operating Values; Name; Value; Category; Description; 1. Cin IRMS; Current; Input capacitor RMS ripple current; 2. Cout IRMS; Output capacitor RMS ripple current; 3. Iin Avg; Average input current; 4. L Ipp; Peak-to-peak inductor ripple current; 5. L1 Irms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

Vin= 10.0V Vin= 13.0V Vin= 16.0V

Copyright © 2018, Texas Instruments Incorporated | 8 | ti.com/webench
# | Name | Value | Category | Description

32. Vout Tolerance | 3.966 % | Op Point | Vout Tolerance based on IC Tolerance (no load) and voltage divider
| | | | resistors if applicable
33. Vout p-p | 117.283 mV | Op Point | Peak-to-peak output ripple voltage
34. Cin Pd | 3.169 mW | Power | Input capacitor power dissipation
35. Cout Pd | 10.118 mW | Power | Output capacitor power dissipation
36. Diode Pd | 58.042 mW | Power | Diode power dissipation
37. IC Pd | 97.42 mW | Power | IC power dissipation
38. L Pd | 312.299 mW | Power | Inductor power dissipation
39. M1 Pd | 1.132 W | Power | M1 MOSFET total power dissipation
40. M1 PdCond | 156.95 mW | Power | M1 MOSFET conduction losses
41. M1 PdSw | 975.451 mW | Power | M1 MOSFET switching losses
42. Rfb Pd | 15.307 mW | Power | Rfb Power Dissipation
43. Rsense Pd | 36.827 mW | Power | LED Current Rsns Power Dissipation
44. Total Pd | 1.672 W | Power | Total Power Dissipation

## Design Inputs

# | Name | Value | Description

1. Iout | 100.0 m | Maximum Output Current
2. VinMax | 16.0 | Maximum input voltage
3. VinMin | 10.0 | Minimum input voltage
4. Vout | 120.0 | Output Voltage
5. base_pn | LM3478 | Base Product Number
6. source | DC | Input Source Type
7. Ta | 30.0 | Ambient temperature

## Design Assistance

1. LM3478 Product Folder : http://www.ti.com/product/LM3478 : contains the data sheet and other resources.

Texas Instruments' WEBENCH simulation tools attempt to recreate the performance of a substantially equivalent physical implementation
of the design. Simulations are created using Texas Instruments' published specifications as well as the published specifications of other device manufacturers. While Texas Instruments does update this information periodically, this information may not be current at the time the simulation is built. Texas Instruments does not warrant the accuracy or completeness of the specifications or any information contained therein. Texas Instruments does not warrant that any designs or recommended parts will meet the specifications you entered, will be suitable for your application or fit for any particular purpose, or will operate as shown in the simulation in a physical implementation. Texas Instruments does not warrant that the designs are production worthy.
You should completely validate and test your design implementation to confirm the system functionality for your application prior to production.
Use of Texas Instruments' WEBENCH simulation tools is subject to Texas Instruments' Site Terms and Conditions of Use. (http://www.ti.com/corp/docs/legal/termsofuse.shtml) Prototype boards based on WEBENCH created designs are provided AS IS without warranty of any kind for evaluation and testing purposes and are subject to the terms of the Evaluation License Agreement. (http://www.ti.com/corp/docs/legal/termsofuse_estore.shtml)
