radi8/-HL_TX-RX_Filters/Bias PSU/LM5022 120v.pdf

## WEBENCH ® Design Report

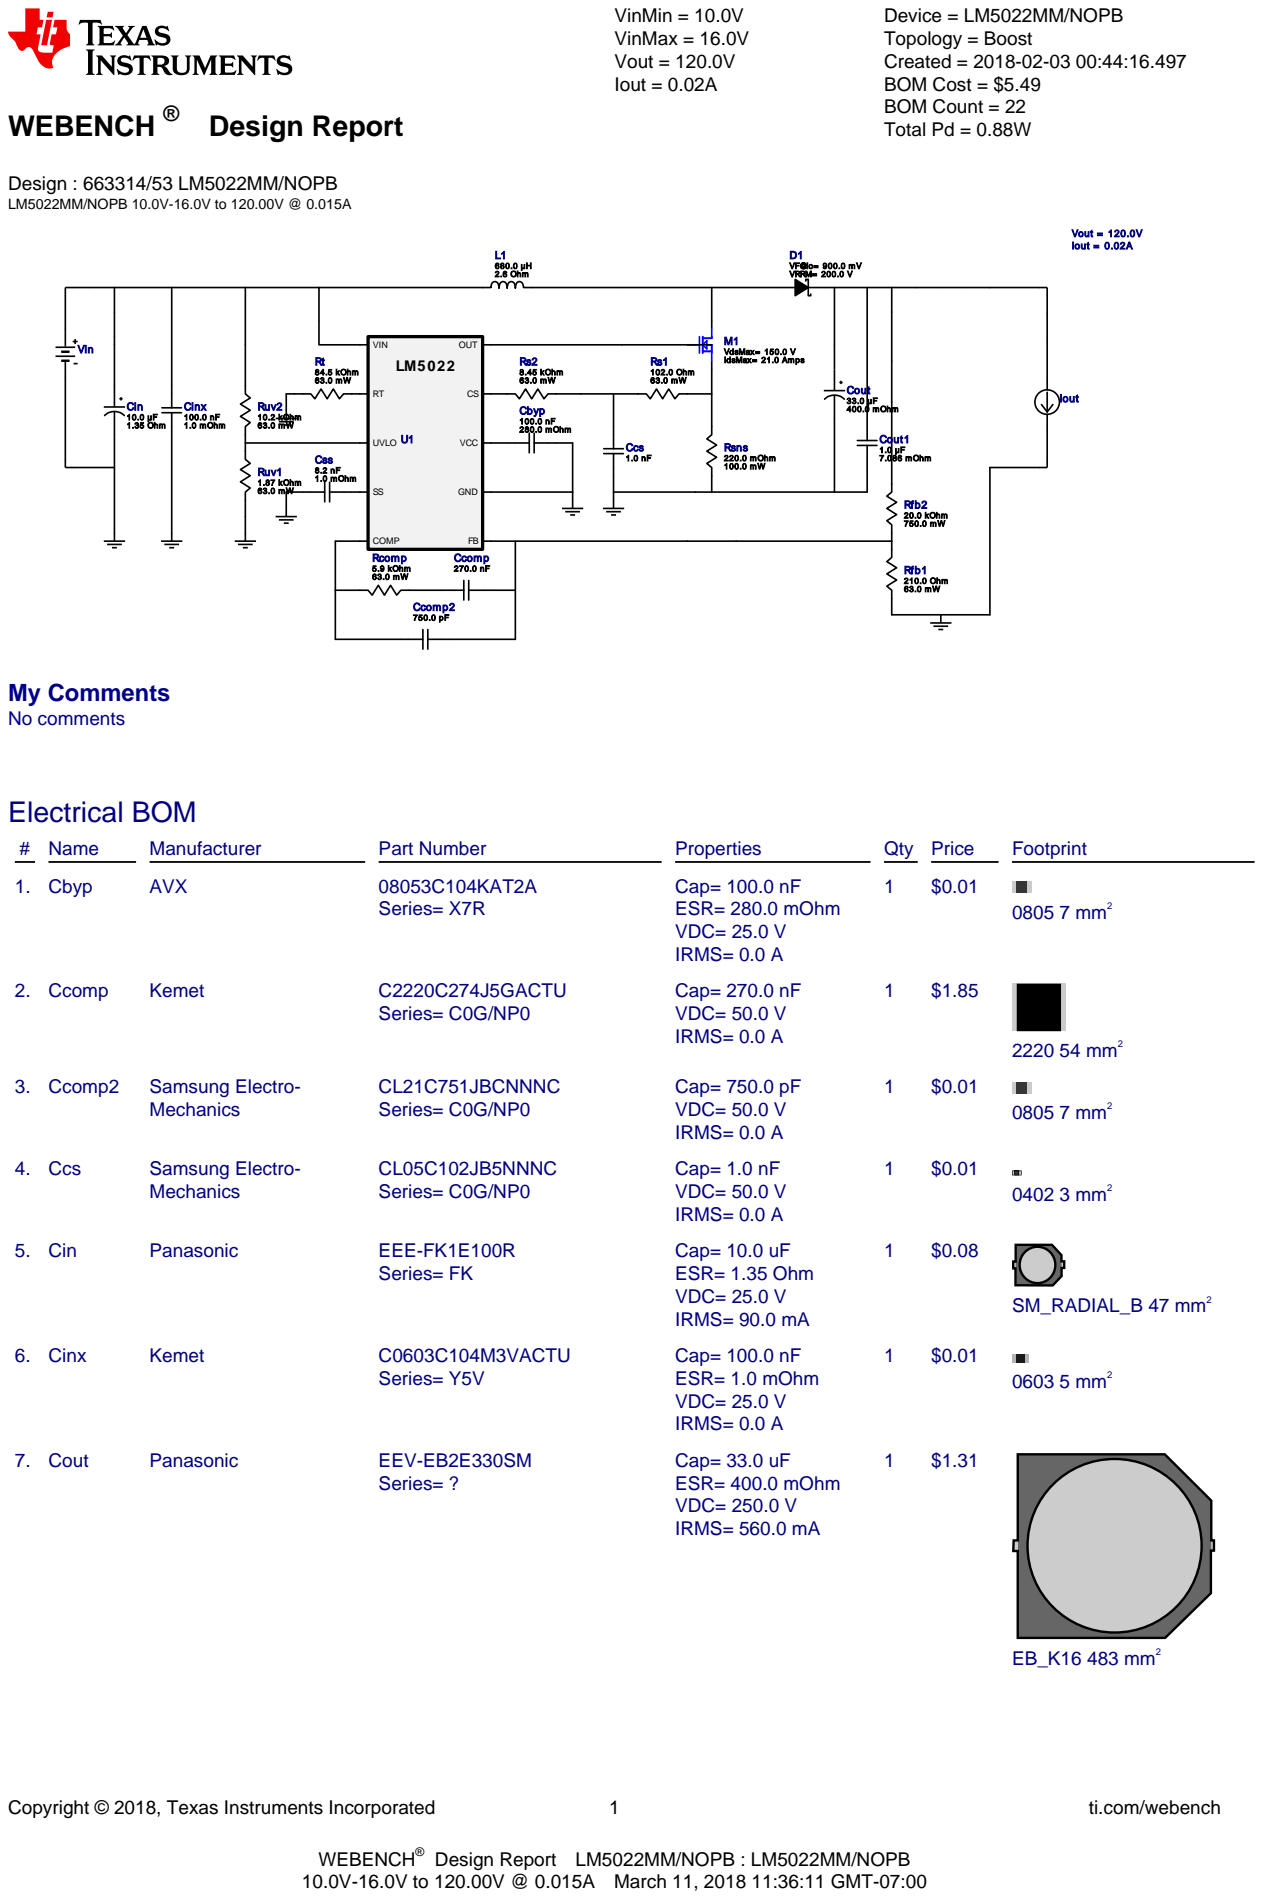
[picture p69: page 1]
Copyright © 2018, Texas Instruments Incorporated; ti.com/webench; Design : 663314/53 LM5022MM/NOPB LM5022MM/NOPB 10.0V-16.0V to 120.00V @ 0.015A; VinMin = 10.0V VinMax = 16.0V Vout = 120.0V Iout = 0.02A; Device = LM5022MM/NOPB Topology = Boost Created = 2018-02-03 00:44:16.497 BOM Cost = $5.49 BOM Count = 22 Total Pd = 0.88W; Cbyp 100.0 nF 280.0 mOhm; Ccomp 270.0 nF; Ccomp2 750.0 pF; Ccs 1.0 nF; Cin 10.0 µF 1.35 Ohm; Cinx 100.0 nF 1.0 mOhm; Cout 33.0; mOhm; Cout1; µF Css; 7.086 mOhm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

WEBENCH®
10.0V-16.0V to 120.00V @ 0.015A March 11, 2018 11:36:11 GMT-07:00

Design Report LM5022MM/NOPB : LM5022MM/NOPB

Design

Copyright © 2018, Texas Instruments Incorporated | 2 | ti.com/webench
# Name | Manufacturer | Part Number | Properties | Qty Price | Footprint

8. Cout1 | MuRata | GRM55DR72E105KW01L (http://psearch.en.murata.com/capacitor/product/GRM55DR72E105KW01%23.pdf) Series= X7R | Cap= 1.0 uF ESR= 7.086 mOhm VDC= 250.0 V IRMS= 2.0605 A
1 | $0.29
| | | | | 2220_200 54 mm²
9. Css | MuRata | GRM155R71E822KA01D (http://search.murata.co.jp/Ceramy/PnsearchViewAction.do) Series= X7R | Cap= 8.2 nF ESR= 1.0 mOhm VDC= 25.0 V IRMS= 0.0 A
1 | $0.01
| | | | | 0402 3 mm²
10. D1 | SMC Diode Solutions | SK220ATR (http://www.smc%2Ddiodes.com/propdf/SK220A%20N0942%20REV.A.pdf) | VF@Io= 900.0 mV VRRM= 200.0 V
1 | $0.04

SMA 37 mm²
11. L1 | Bourns | SDR1005-681KL (http://www.bourns.com/data/global/pdfs/SDR1005.pdf) | L= 680.0 µH DCR= 2.6 Ohm
1 | $0.29

SDR1005 176 mm²
12. M1 | Infineon Technologies | BSZ520N15NS3 G (http://www.infineon.com/dgdl/BSZ520N15NS3%2BRev2.2.pdf) | VdsMax= 150.0 V IdsMax= 21.0 Amps | 1 | $0.55

PG-TSDSON-8 19 mm²
13. Rcomp | Vishay-Dale | CRCW04025K90FKED (http://www.vishay.com/docs/20035/dcrcwe3.pdf) Series= CRCW..e3 | Res= 5.9 kOhm Power= 63.0 mW Tolerance= 1.0% | 1 | $0.01
0402 3 mm²
14. Rfb1 | Vishay-Dale | CRCW0402210RFKED (http://www.vishay.com/docs/20035/dcrcwe3.pdf) Series= CRCW..e3 | Res= 210.0 Ohm Power= 63.0 mW Tolerance= 1.0% | 1 | $0.01
0402 3 mm²
15. Rfb2 | Vishay-Dale | CRCW201020K0FKEF (http://www.vishay.com/docs/20035/dcrcwe3.pdf) Series= CRCW..e3 | Res= 20.0 kOhm Power= 750.0 mW Tolerance= 1.0% | 1 | $0.04
2010 32 mm²
16. Rs1 | Vishay-Dale | CRCW0402102RFKED (http://www.vishay.com/docs/20035/dcrcwe3.pdf) Series= CRCW..e3 | Res= 102.0 Ohm Power= 63.0 mW Tolerance= 1.0% | 1 | $0.01
0402 3 mm²
17. Rs2 | Vishay-Dale | CRCW04028K45FKED (http://www.vishay.com/docs/20035/dcrcwe3.pdf) Series= CRCW..e3 | Res= 8.45 kOhm Power= 63.0 mW Tolerance= 1.0% | 1 | $0.01
0402 3 mm²
18. Rsns | Panasonic | ERJ-3RQFR22V (http://www.panasonic.com/industrial/components/pdf/AOA0000CE3.pdf) Series= ERJ-3R | Res= 220.0 mOhm Power= 100.0 mW Tolerance= 1.0% | 1 | $0.02
0603 5 mm²
19. Rt | Vishay-Dale | CRCW040284K5FKED (http://www.vishay.com/docs/20035/dcrcwe3.pdf) Series= CRCW..e3 | Res= 84.5 kOhm Power= 63.0 mW Tolerance= 1.0% | 1 | $0.01
0402 3 mm²
20. Ruv1 | Vishay-Dale | CRCW04021K87FKED (http://www.vishay.com/docs/20035/dcrcwe3.pdf) Series= CRCW..e3 | Res= 1.87 kOhm Power= 63.0 mW Tolerance= 1.0% | 1 | $0.01
0402 3 mm²
21. Ruv2 | Vishay-Dale | CRCW040210K2FKED (http://www.vishay.com/docs/20035/dcrcwe3.pdf) Series= CRCW..e3 | Res= 10.2 kOhm Power= 63.0 mW Tolerance= 1.0% | 1 | $0.01
0402 3 mm²
22. U1 | Texas Instruments | LM5022MM/NOPB (http://www.ti.com/product/LM5022) | Switcher | 1 | $0.90

MUB10A 24 mm²

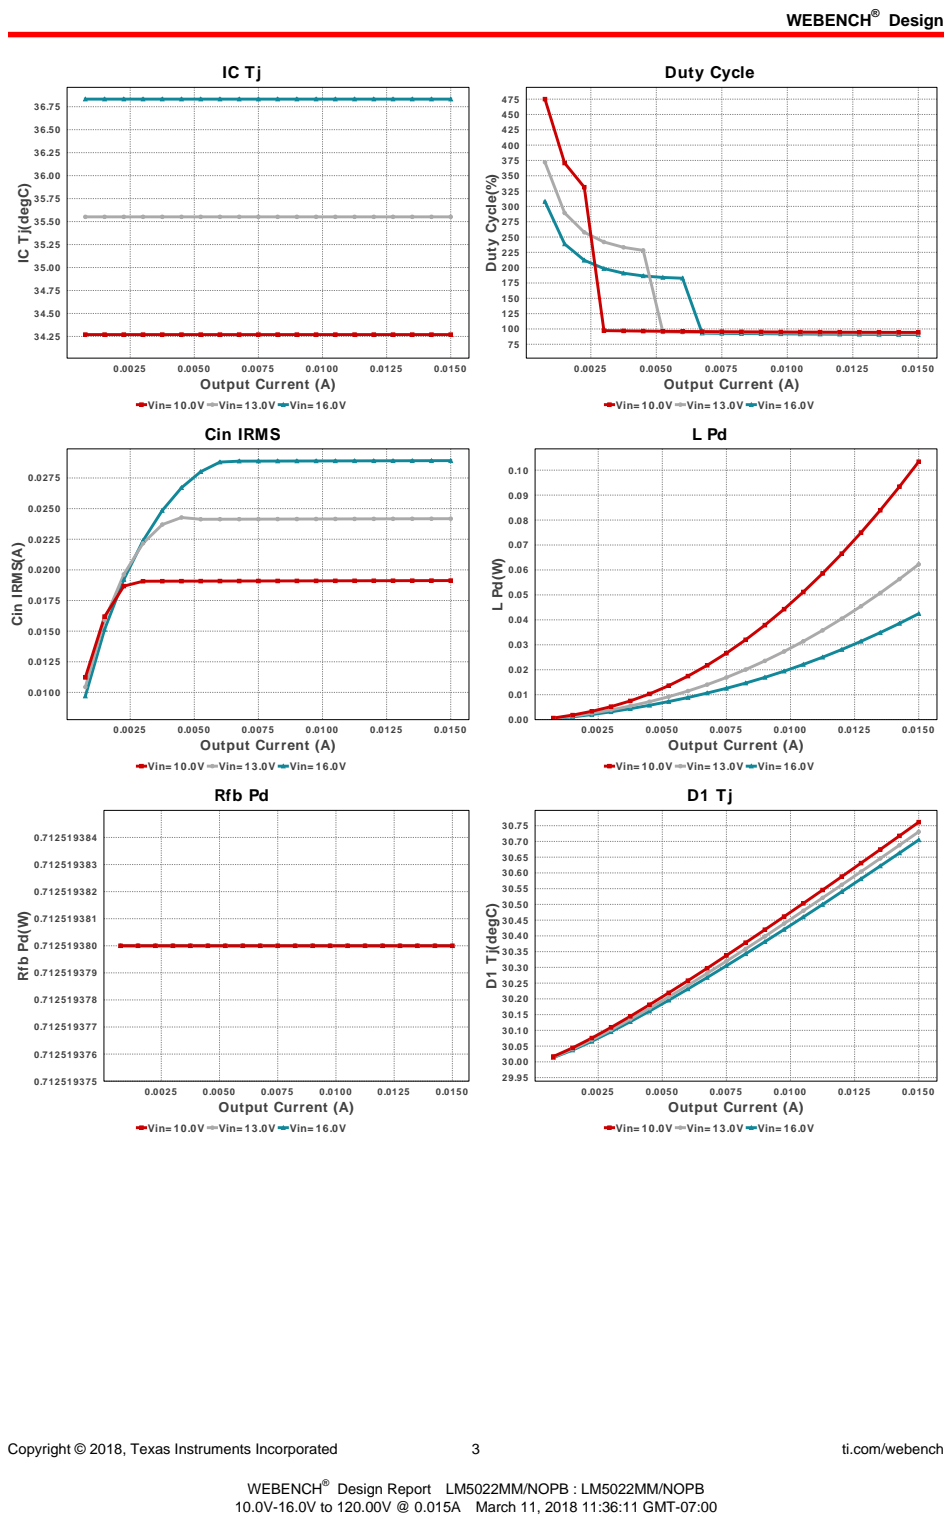
[picture p70: page 3]
Copyright © 2018, Texas Instruments Incorporated; ti.com/webench; 0.0150 Output Current (A); Duty Cycle; Duty Cycle(%); Cin IRMS(A); Rfb Pd; Rfb Pd(W); D1 Tj(degC)

IC Tj(degC)

Vin= 10.0V Vin= 13.0V Vin= 16.0V
Cin IRMS

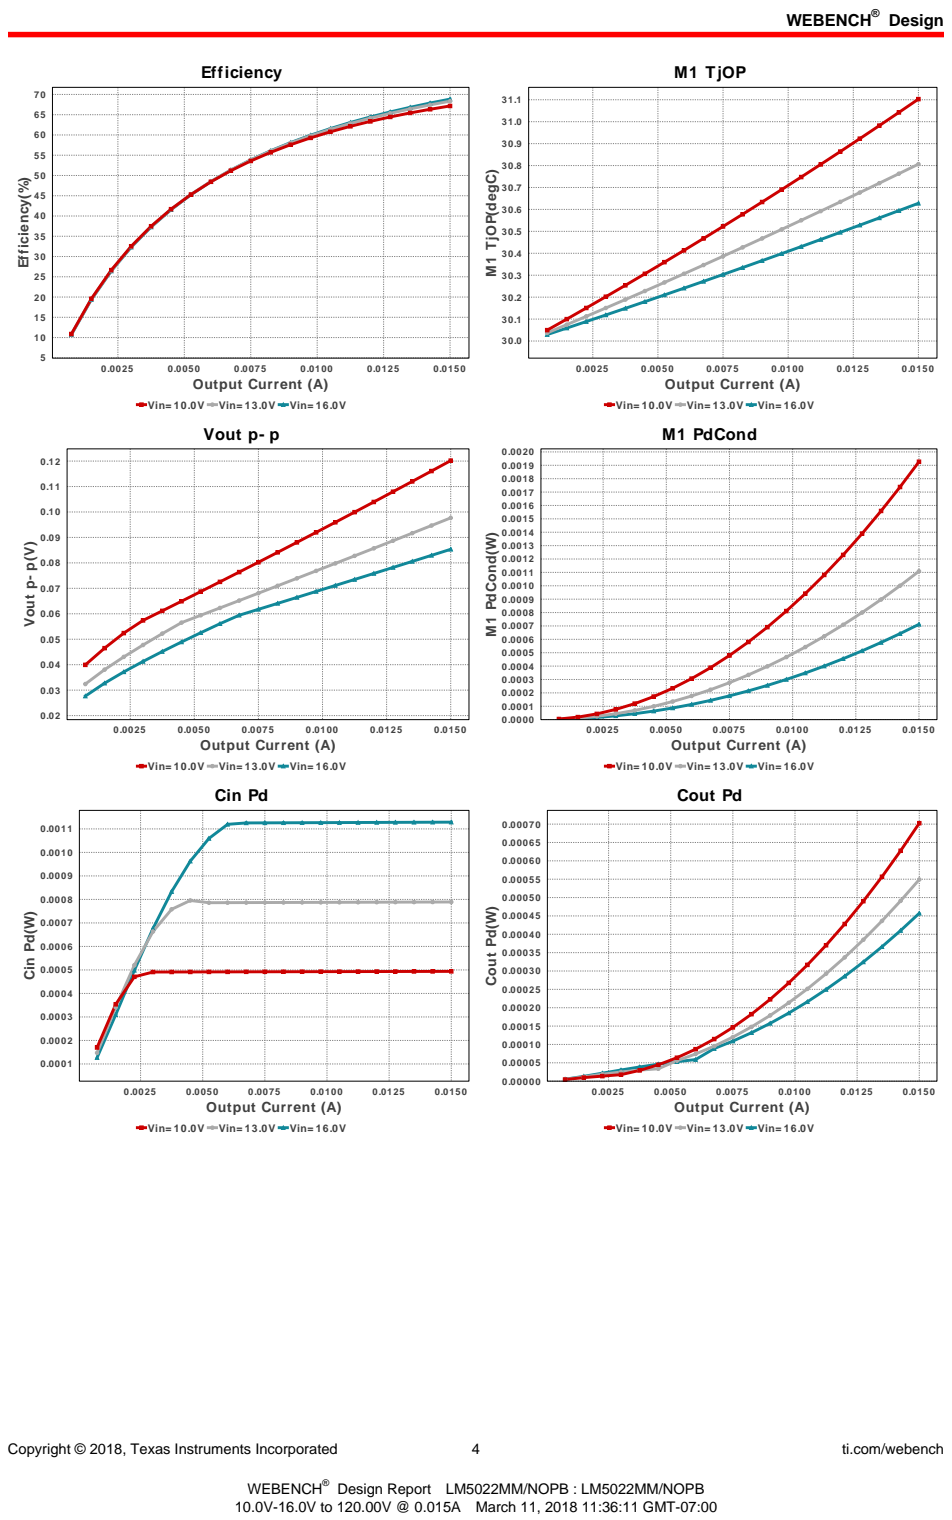
[picture p71: page 4]
Copyright © 2018, Texas Instruments Incorporated; ti.com/webench; Efficiency; 0.0150 Output Current (A); Efficiency(%); M1 TjOP; M1 TjOP(degC); Vout p- p(V); M1 PdCond(W); Cin Pd; Cin Pd(W); Cout Pd; Cout Pd(W)

Vin= 10.0V Vin= 13.0V Vin= 16.0V
Vout p- p

M1 PdCond

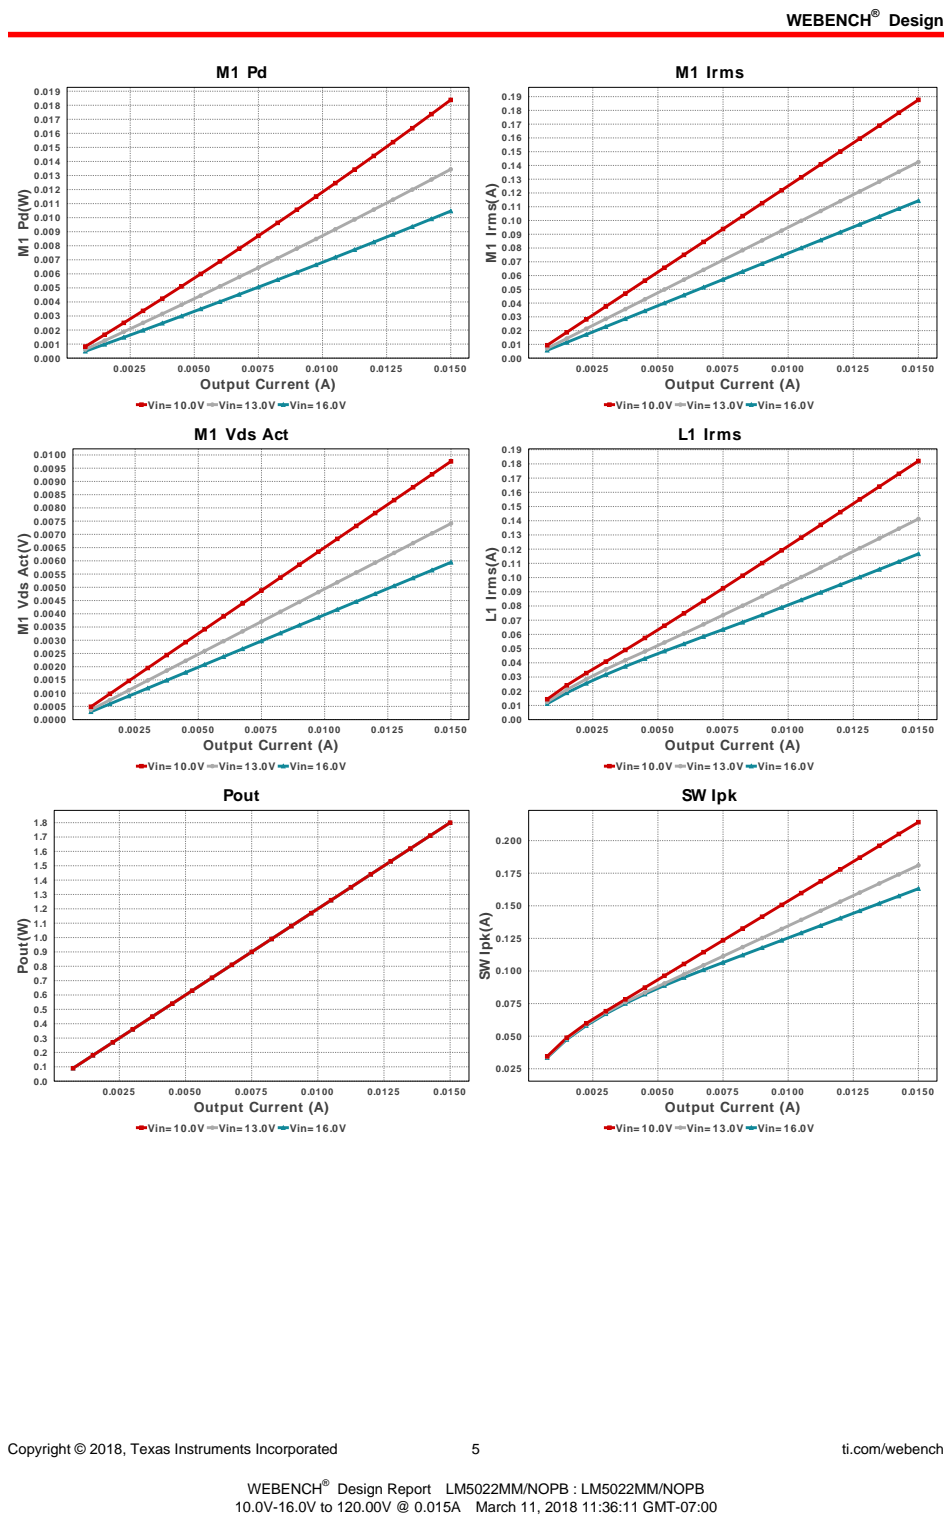
[picture p72: page 5]
Copyright © 2018, Texas Instruments Incorporated; ti.com/webench; 0.0150 Output Current (A); M1 Irms; M1 Irms(A); M1 Vds Act(V); L1 Irms; L1 Irms(A); Pout; Pout(W); SW Ipk; SW Ipk(A)

Vin= 10.0V Vin= 13.0V Vin= 16.0V
M1 Vds Act

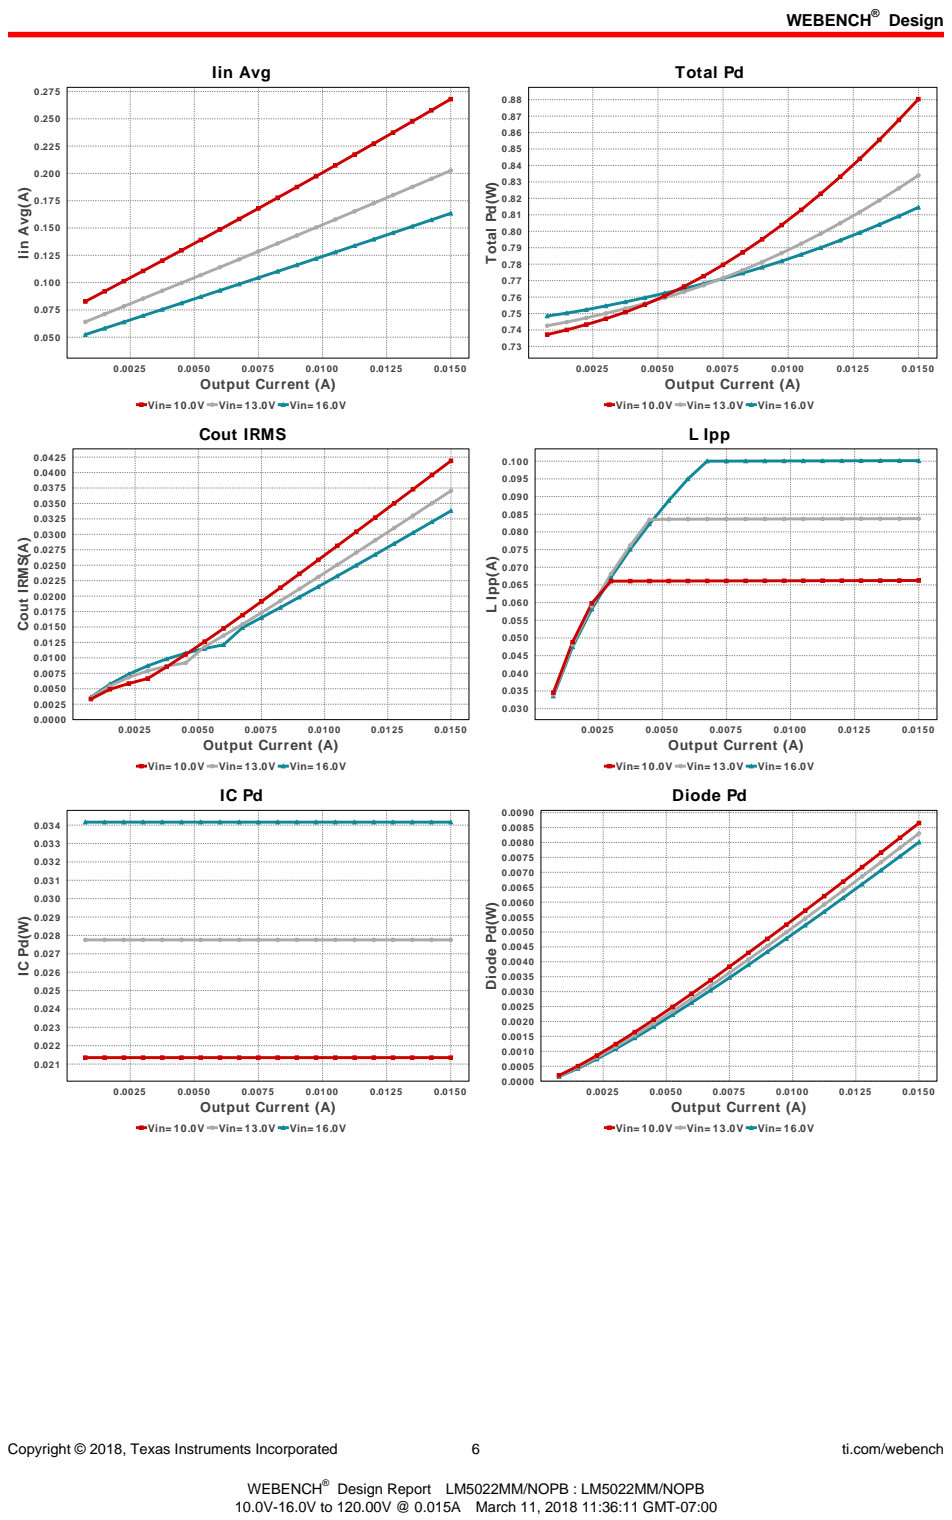
[picture p73: page 6]
Copyright © 2018, Texas Instruments Incorporated; ti.com/webench; Iin Avg; 0.0150 Output Current (A); Iin Avg(A); Total Pd; Total Pd(W); Cout IRMS(A); L Ipp; L Ipp(A); Diode Pd(W)

Vin= 10.0V Vin= 13.0V Vin= 16.0V
Cout IRMS

Diode Pd

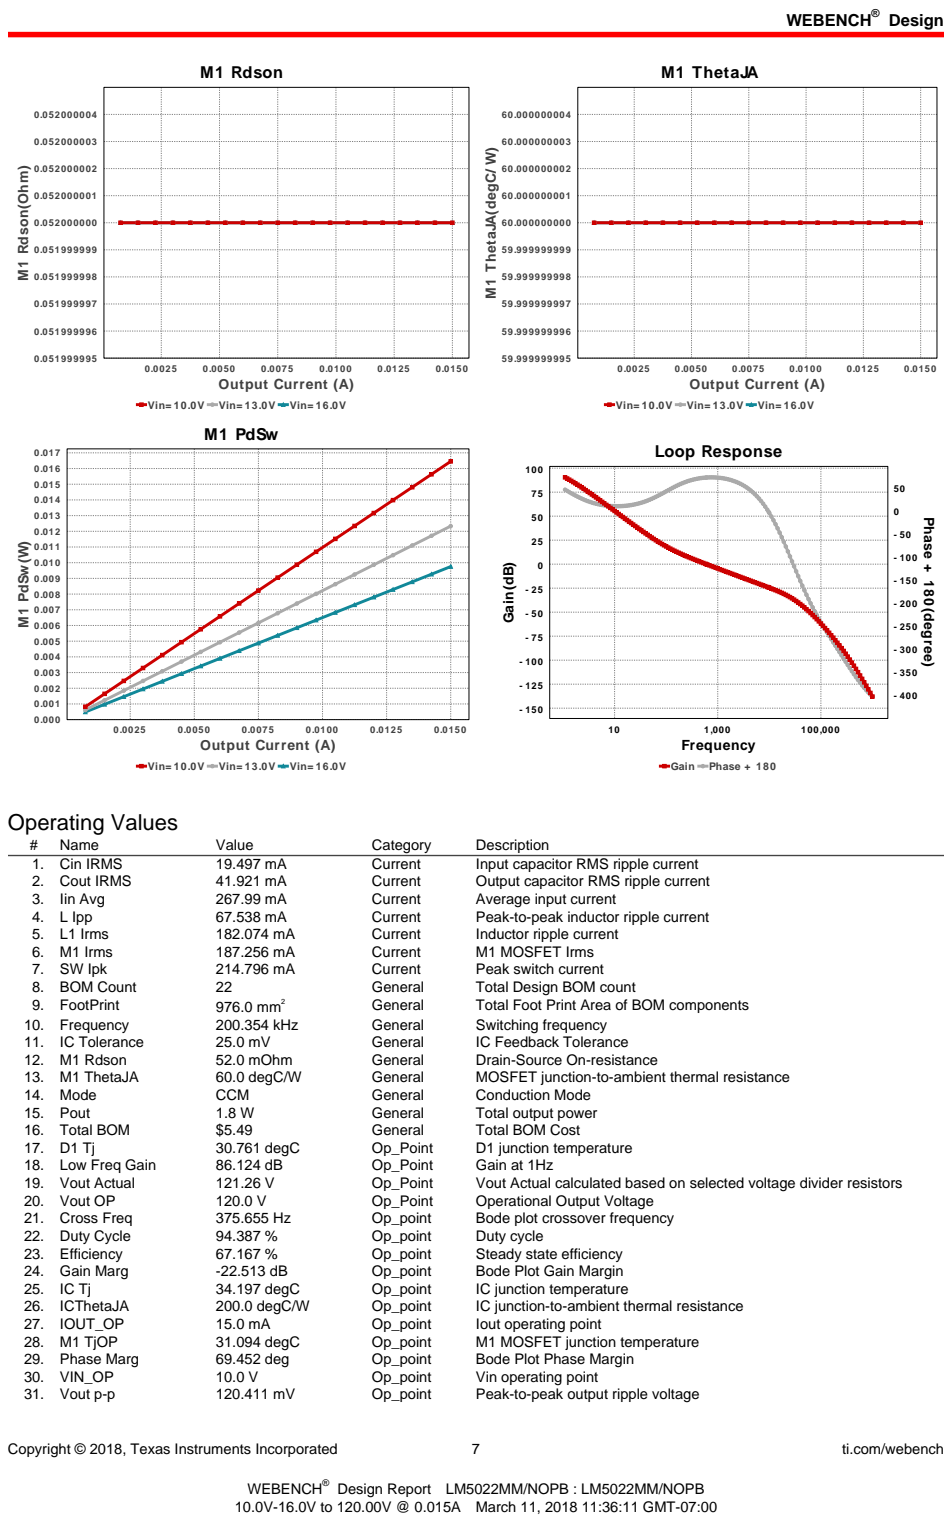
[picture p74: page 7]
Copyright © 2018, Texas Instruments Incorporated; ti.com/webench; M1 Rdson; 0.0150 Output Current (A); M1 Rdson(Ohm); M1 ThetaJA; M1 ThetaJA(degC/ W); M1 PdSw(W); Loop Response; Gain Phase + 180; 100,000 Frequency; Gain(dB); Phase + 180(degree); Operating Values; Name; Value; Category; Description; 1. Cin IRMS; Current; Input capacitor RMS ripple current; 2. Cout IRMS; Output capacitor RMS ripple current; 3. Iin Avg; Average input current; 4. L Ipp; Peak-to-peak inductor ripple current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

Vin= 10.0V Vin= 13.0V Vin= 16.0V
M1 PdSw

Copyright © 2018, Texas Instruments Incorporated | 8 | ti.com/webench
# | Name | Value | Category | Description

32. Cin Pd | 513.162 µW | Power | Input capacitor power dissipation
33. Cout Pd | 702.951 µW | Power | Output capacitor power dissipation
34. Diode Pd | 8.65 mW | Power | Diode power dissipation
35. IC Pd | 20.984 mW | Power | IC power dissipation
36. L Pd | 103.43 mW | Power | Inductor power dissipation
37. M1 Pd | 18.239 mW | Power | M1 MOSFET total power dissipation
38. M1 PdCond | 1.918 mW | Power | M1 MOSFET conduction losses
39. M1 PdSw | 16.321 mW | Power | M1 MOSFET switching losses
40. Rfb Pd | 712.519 mW | Power | Rfb Power Dissipation
41. Total Pd | 879.892 mW | Power | Total Power Dissipation
42. M1 Vds Act | 9.737 mV | M Vds
43. Vout Tolerance | 4.023 % | Vout Tolerance based on IC Tolerance (no load) and voltage divider
| | | | resistors if applicable

## Design Inputs

# | Name | Value | Description

1. Iout | 15.0 m | Maximum Output Current
2. VinMax | 16.0 | Maximum input voltage
3. VinMin | 10.0 | Minimum input voltage
4. Vout | 120.0 | Output Voltage
5. base_pn | LM5022 | Base Product Number
6. source | DC | Input Source Type
7. Ta | 30.0 | Ambient temperature

## Design Assistance

1. LM5022 Product Folder : http://www.ti.com/product/LM5022 : contains the data sheet and other resources.

Texas Instruments' WEBENCH simulation tools attempt to recreate the performance of a substantially equivalent physical implementation
of the design. Simulations are created using Texas Instruments' published specifications as well as the published specifications of other device manufacturers. While Texas Instruments does update this information periodically, this information may not be current at the time the simulation is built. Texas Instruments does not warrant the accuracy or completeness of the specifications or any information contained therein. Texas Instruments does not warrant that any designs or recommended parts will meet the specifications you entered, will be suitable for your application or fit for any particular purpose, or will operate as shown in the simulation in a physical implementation. Texas Instruments does not warrant that the designs are production worthy.
You should completely validate and test your design implementation to confirm the system functionality for your application prior to production.
Use of Texas Instruments' WEBENCH simulation tools is subject to Texas Instruments' Site Terms and Conditions of Use. (http://www.ti.com/corp/docs/legal/termsofuse.shtml) Prototype boards based on WEBENCH created designs are provided AS IS without warranty of any kind for evaluation and testing purposes and are subject to the terms of the Evaluation License Agreement. (http://www.ti.com/corp/docs/legal/termsofuse_estore.shtml)
