radi8/-HL_TX-RX_Filters/Schematic.pdf

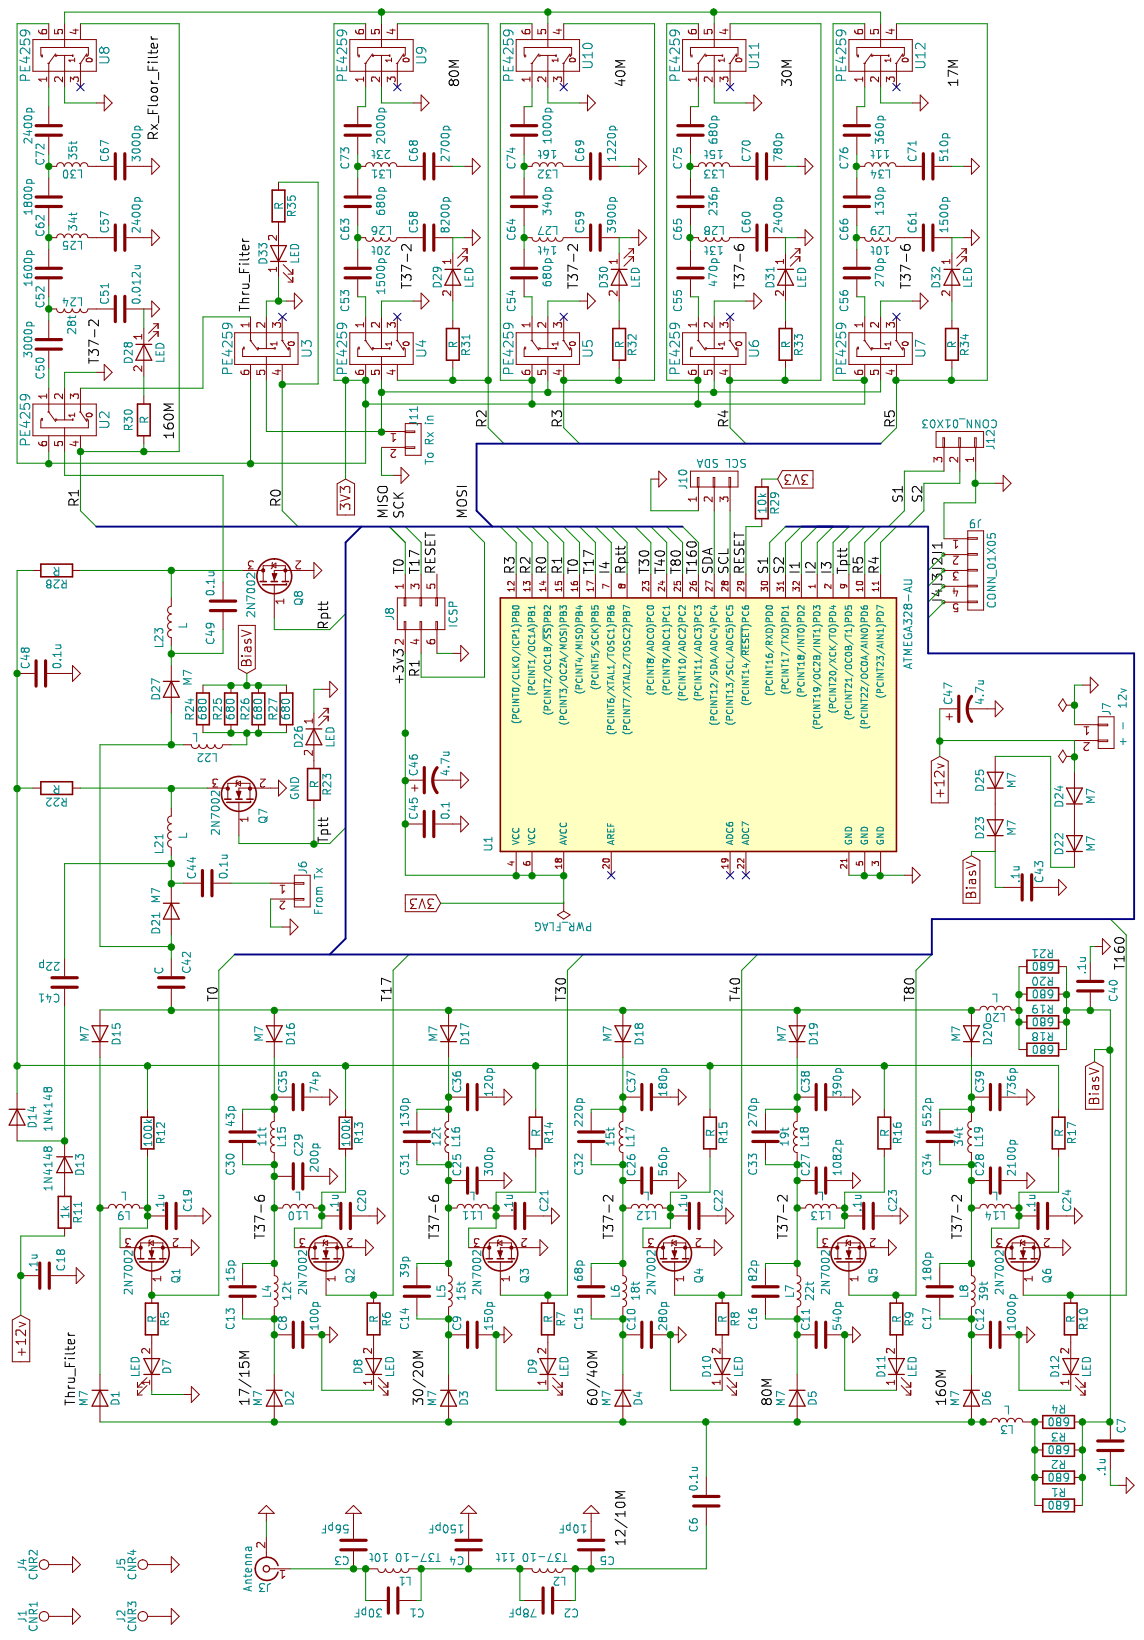
[picture p75: page 1]
