radi8/-HL_TX-RX_Filters/Resource/RS-HFIQ Rev C Schematic.pdf

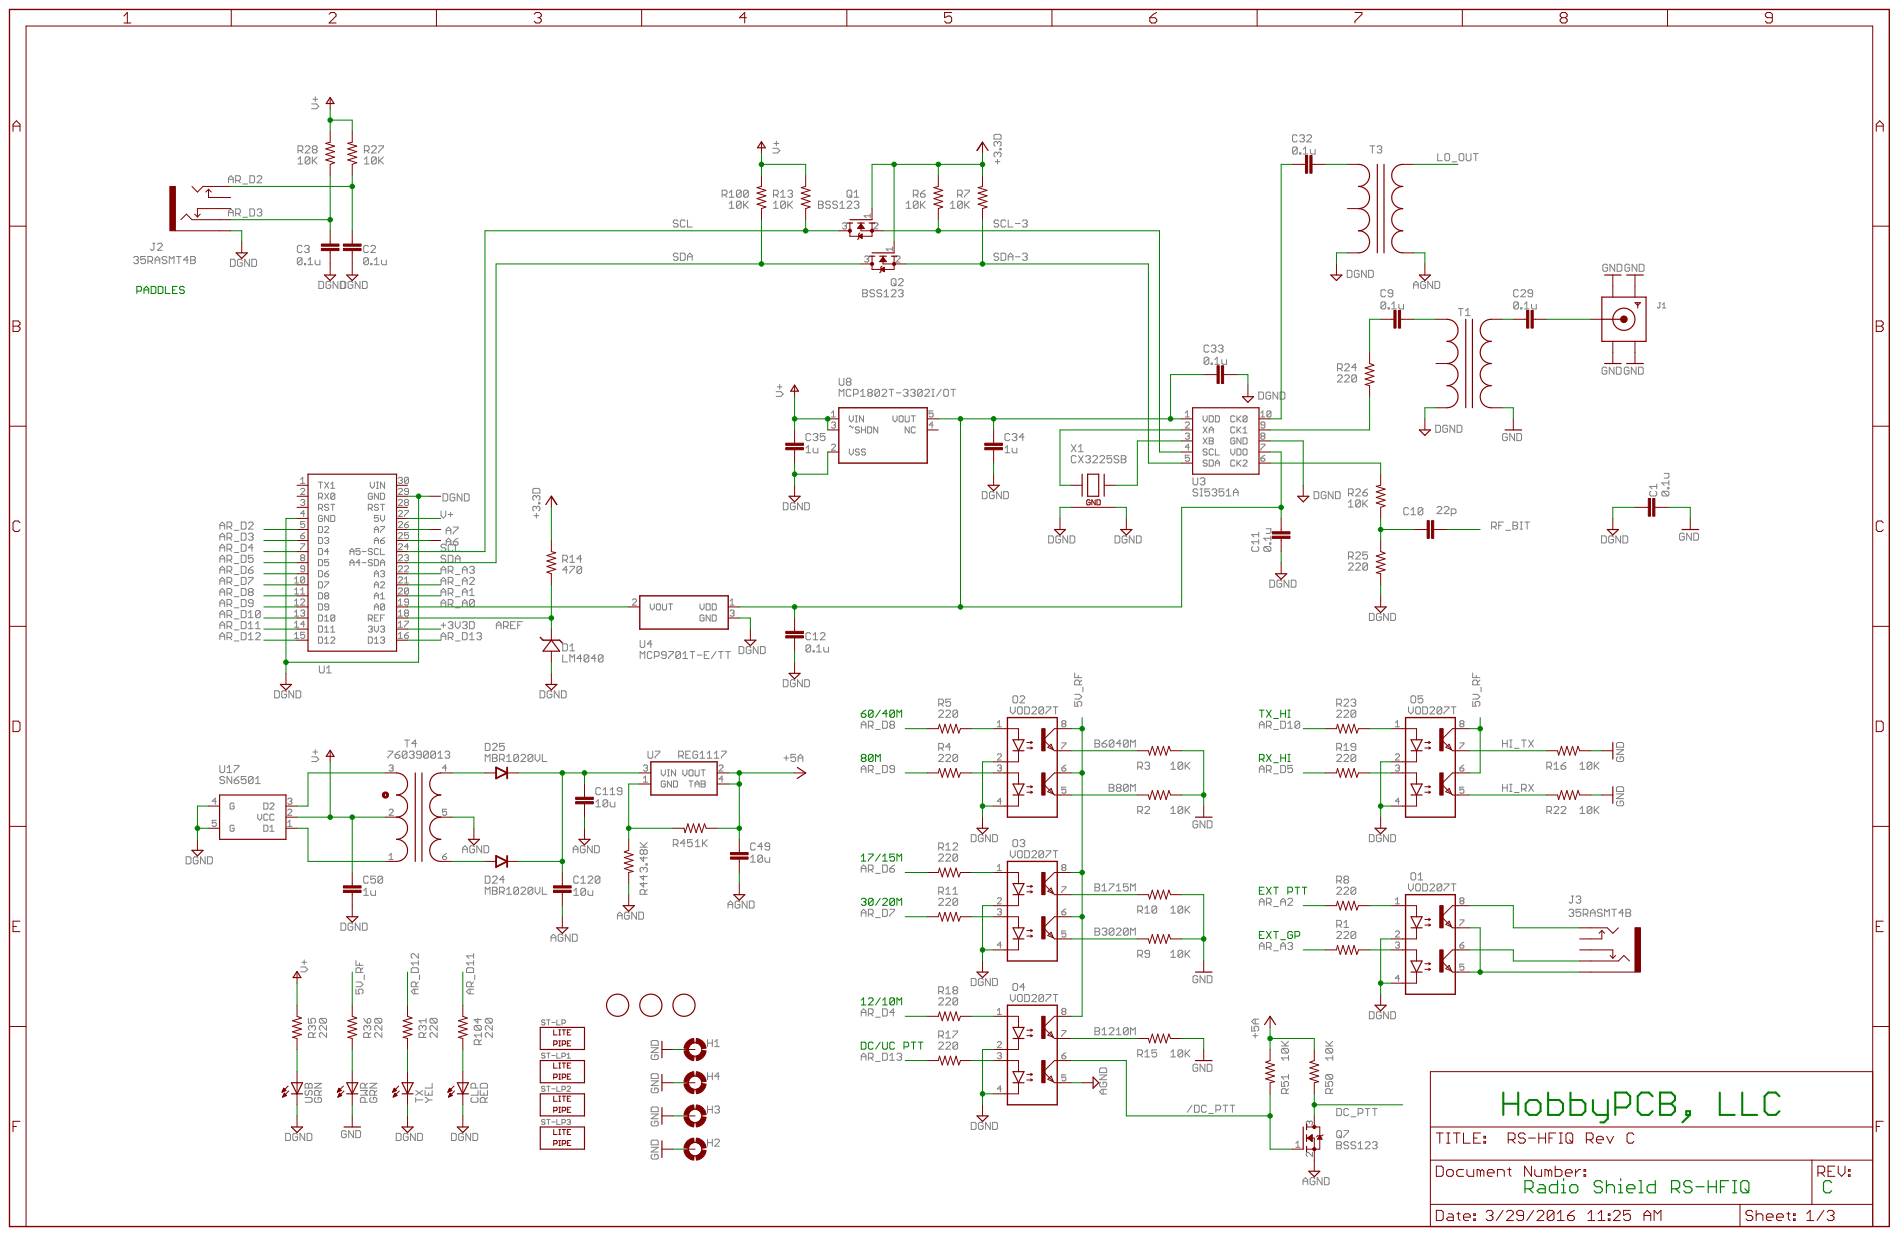
[picture p76: page 1]

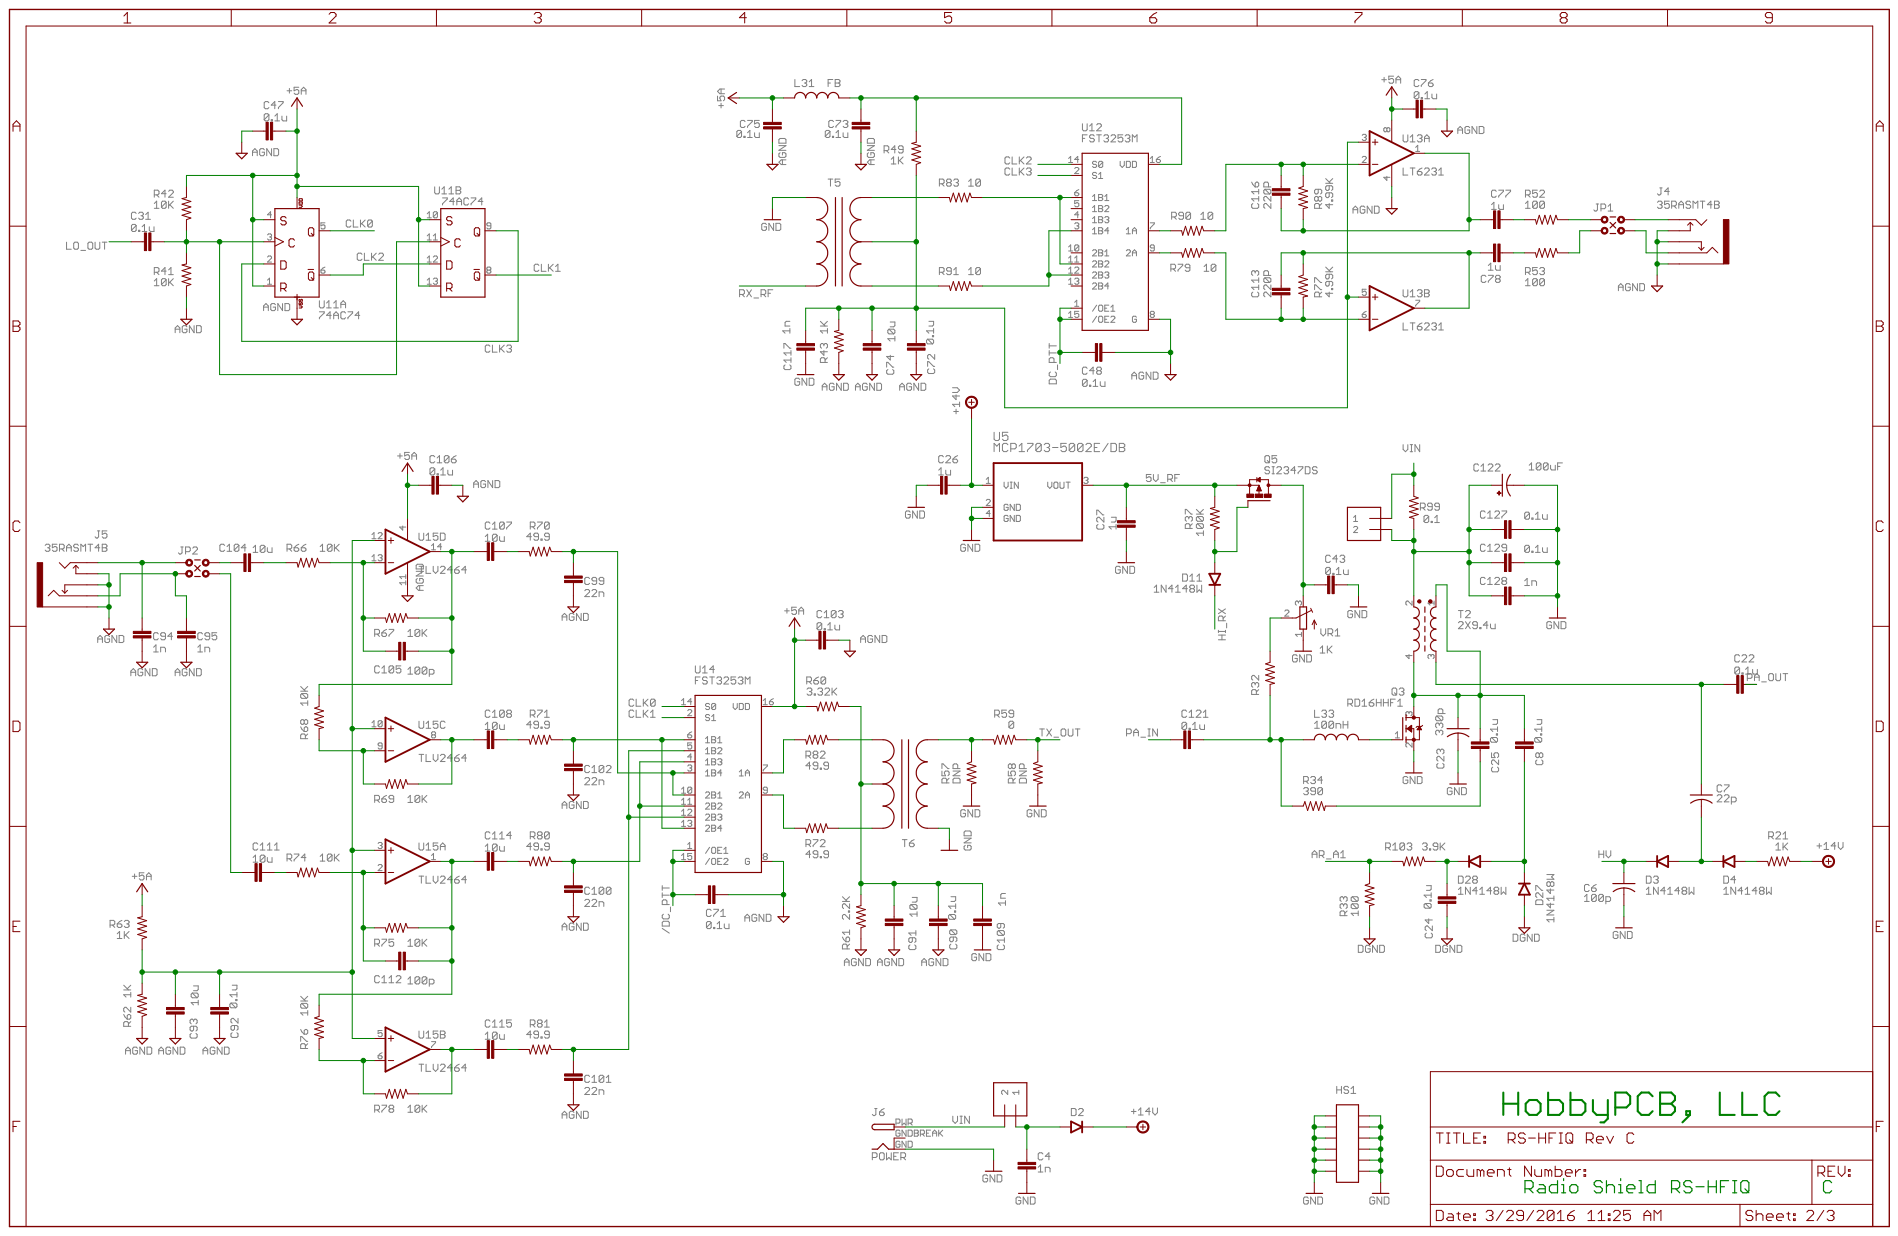
[picture p77: page 2]

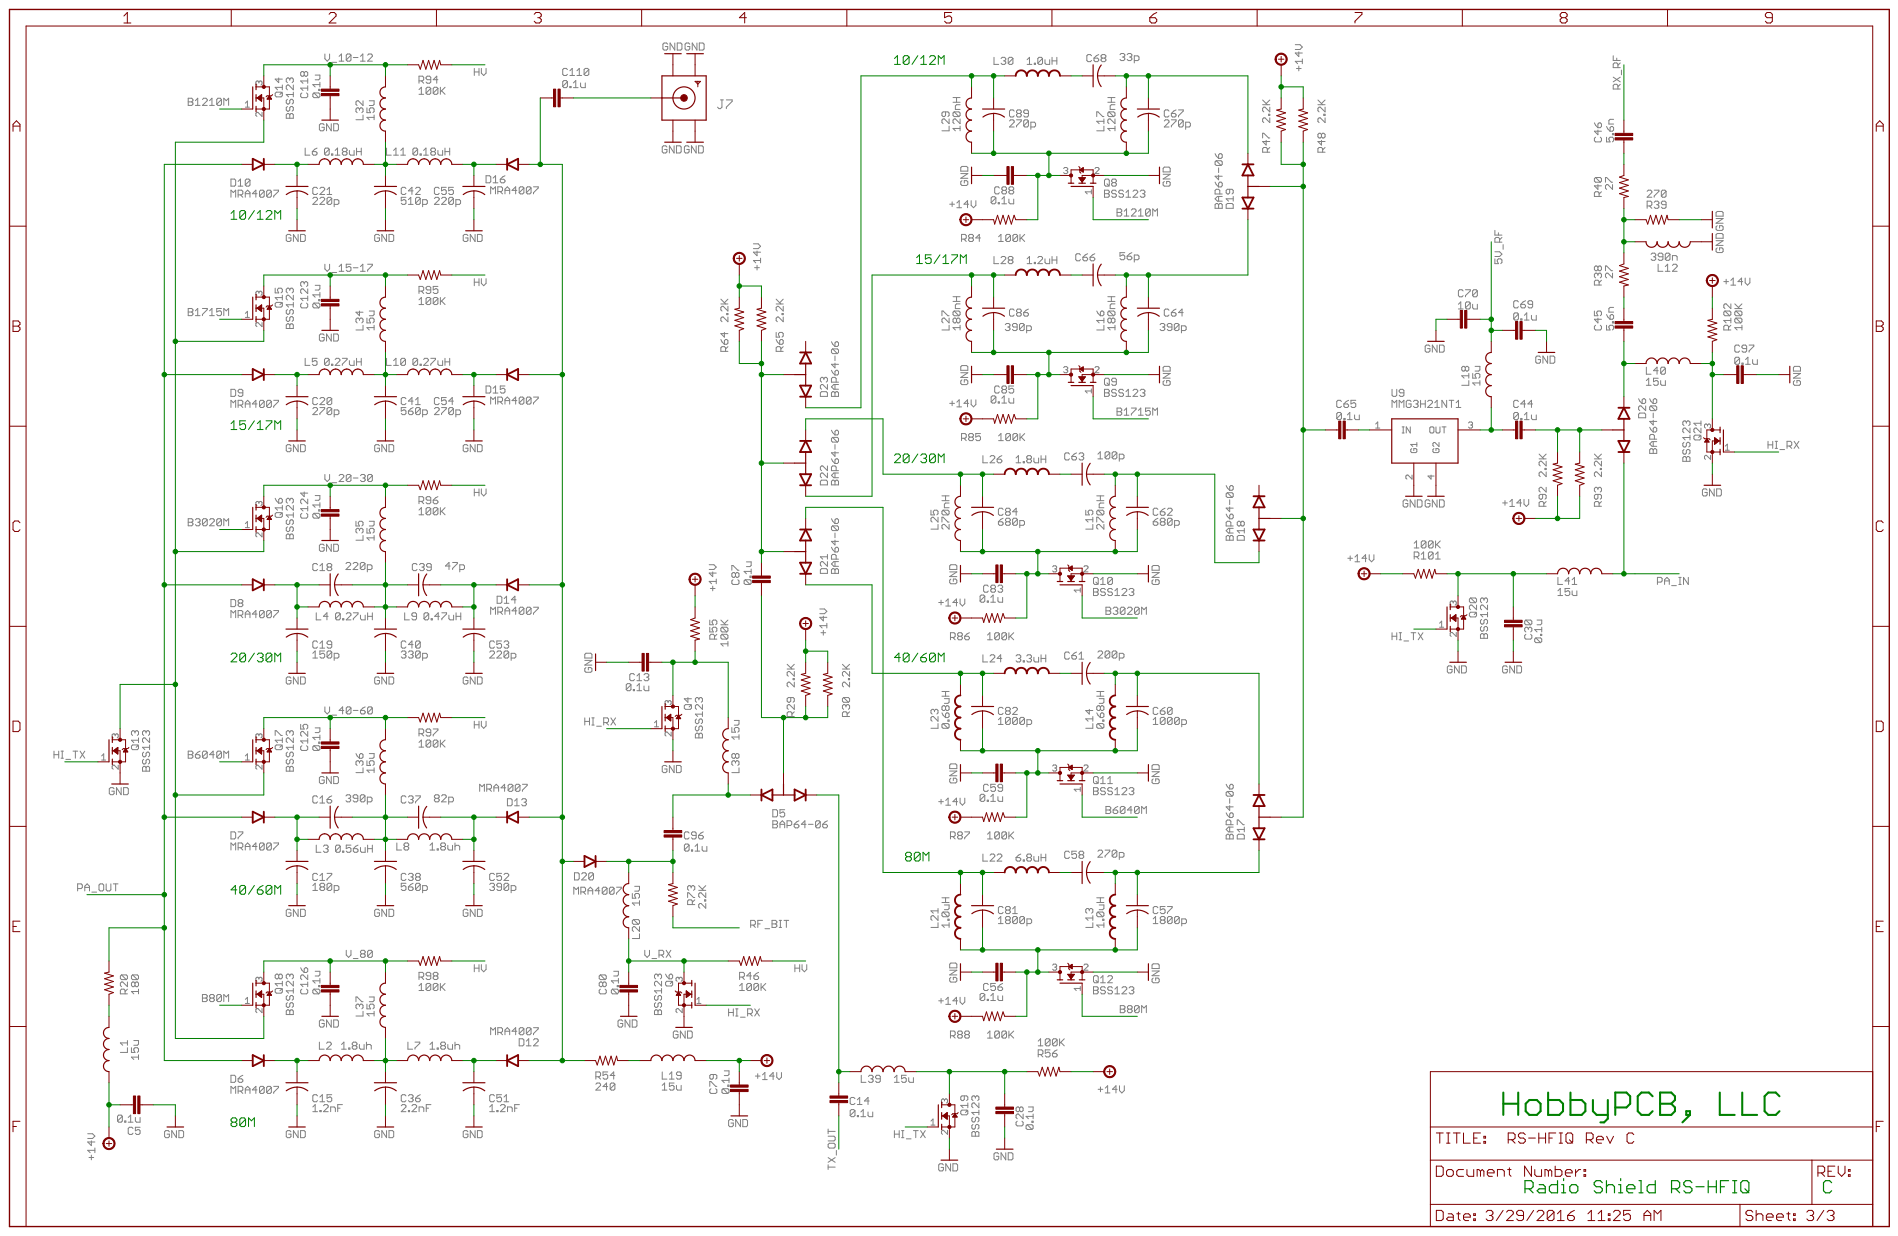
[picture p78: page 3]
