radi8/-HL_TX-RX_Filters/Experiments/Diode Filter Switching/Resource/DiodeSwitches Article.pdf

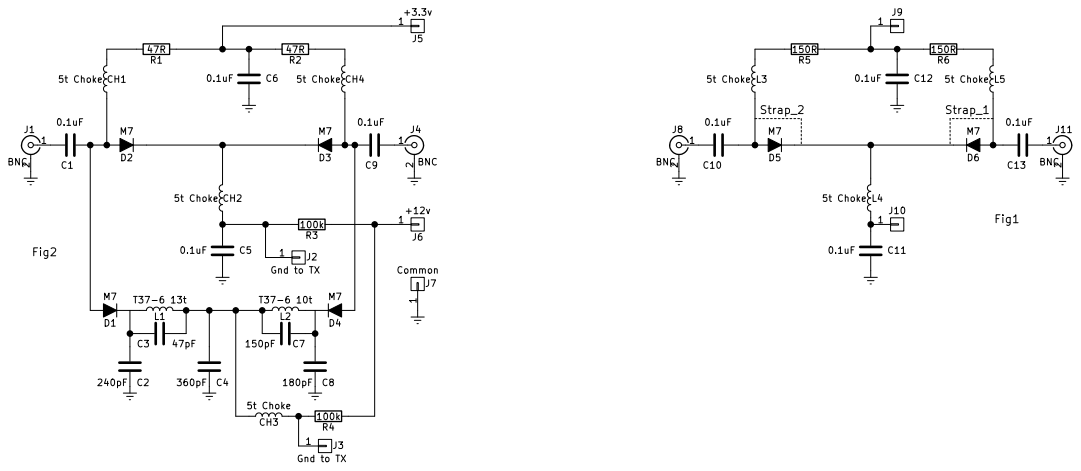
[picture p79: page 1]
