radi8/-HL_TX-RX_Filters/HL_TX-RX_Filter.kicad_pcb

## KiCad design HL_TX-RX_Filter.kicad_pcb (2017-08-04)

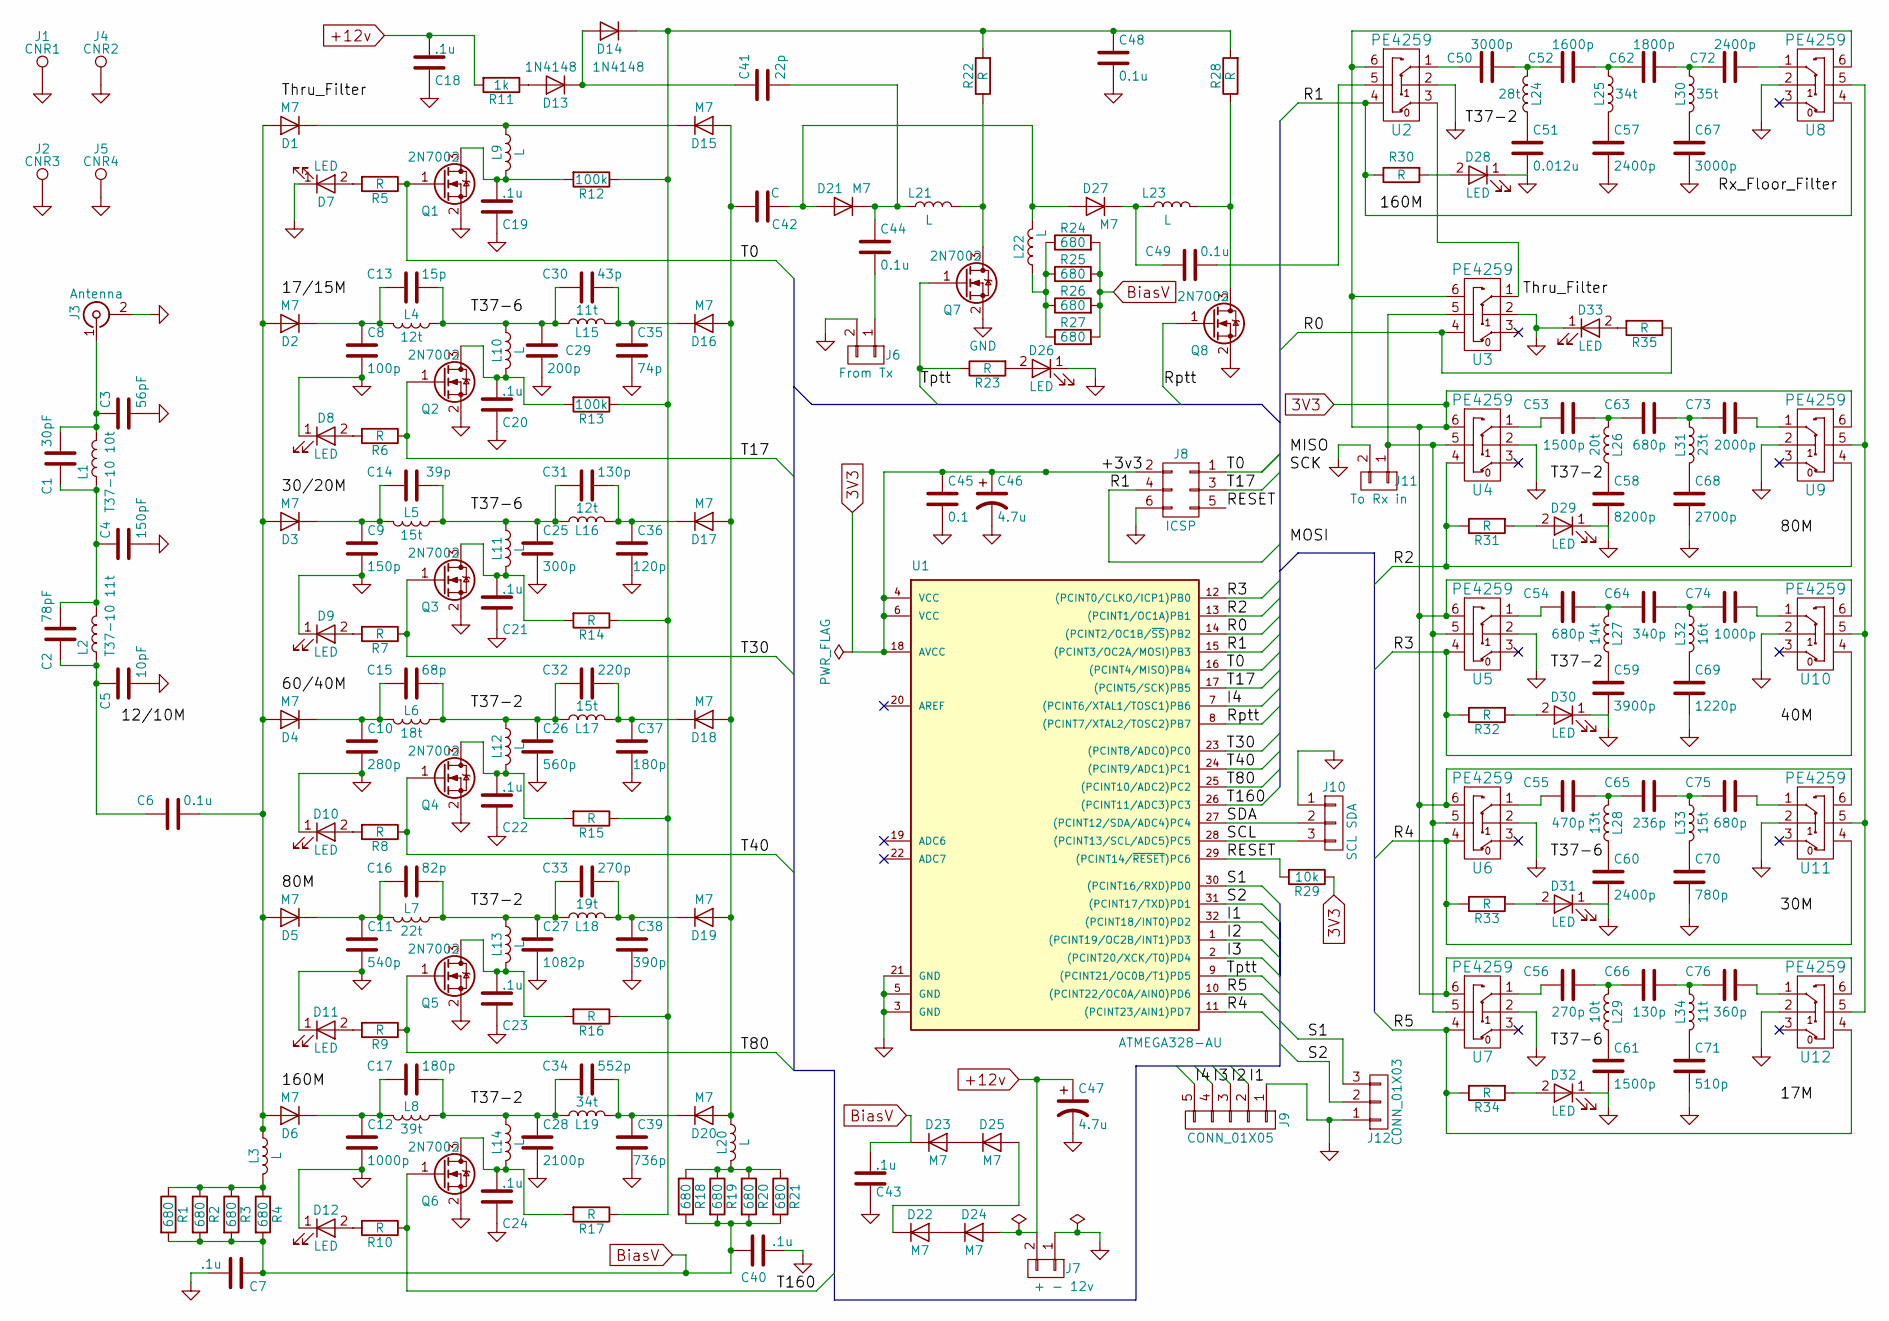
[picture p80: schematic HL_TX-RX_Filter.sch, Hermes-Lite Tx/Rx Filter]

Parts:
C1: 30pF; C_1206_HandSoldering
C2: 78pF; C_1206_HandSoldering
C3: 56pF; C_1206_HandSoldering
C4: 150pF; C_1206_HandSoldering
C5: 10pF; C_1206_HandSoldering
C6, C44, C48, C49: 0.1u; C_1206_HandSoldering
C7, C18, C19, C20, C21, C22, C23, C24, C40, C43: .1u; C_1206_HandSoldering
C8: 100p; C_1206_HandSoldering
C9: 150p; C_1206_HandSoldering
C10: 280p; C_1206_HandSoldering
C11: 540p; C_1206_HandSoldering
C12, C74: 1000p; C_1206_HandSoldering
C13: 15p; C_1206_HandSoldering
C14: 39p; C_1206_HandSoldering
C15: 68p; C_1206_HandSoldering
C16: 82p; C_1206_HandSoldering
C17, C37: 180p; C_1206_HandSoldering
C25: 300p; C_1206_HandSoldering
C26: 560p; C_1206_HandSoldering
C27: 1082p; C_1206_HandSoldering
C28: 2100p; C_1206_HandSoldering
C29: 200p; C_1206_HandSoldering
C30: 43p; C_1206_HandSoldering
C31, C66: 130p; C_1206_HandSoldering
C32: 220p; C_1206_HandSoldering
C33, C56: 270p; C_1206_HandSoldering
C34: 552p; C_1206_HandSoldering
C35: 74p; C_1206_HandSoldering
C36: 120p; C_1206_HandSoldering
C38: 390p; C_1206_HandSoldering
C39: 736p; C_1206_HandSoldering
C41: 22p; C_1206_HandSoldering
C42: C; C_1206_HandSoldering
C45: 0.1; C_1206_HandSoldering
C46, C47: 4.7u; CP_Radial_D5.0mm_P2.00mm
C50, C67: 3000p; C_1206_HandSoldering
C51: 0.012u; C_1206_HandSoldering
C52: 1600p; C_1206_HandSoldering
C53, C61: 1500p; C_1206_HandSoldering
C54, C63, C75: 680p; C_1206_HandSoldering
C55: 470p; C_1206_HandSoldering
C57, C60, C72: 2400p; C_1206_HandSoldering
C58: 8200p; C_1206_HandSoldering
C59: 3900p; C_1206_HandSoldering
C62: 1800p; C_1206_HandSoldering
C64: 340p; C_1206_HandSoldering
C65: 236p; C_1206_HandSoldering
C68: 2700p; C_1206_HandSoldering
C69: 1220p; C_1206_HandSoldering
C70: 780p; C_1206_HandSoldering
C71: 510p; C_1206_HandSoldering
C73: 2000p; C_1206_HandSoldering
C76: 360p; C_1206_HandSoldering
D1, D2, D3, D4, D5, D6, D15, D16, D17, D18, D19, D20, D21, D27: M7; D_SMA_Handsoldering
D7, D8, D9, D10, D11, D12, D26, D28, D29, D30, D31, D32, D33: LED; LED_1206
D13, D14: 1N4148; D_MiniMELF_Handsoldering
D22, D23, D24, D25: M7; D_SMA
J1: CNR1; 1pin
J2: CNR3; 1pin
J3: Antenna; SMAEDGE_TH
J4: CNR2; 1pin
J5: CNR4; 1pin
J6: From Tx; Pin_Header_Straight_1x02_Pitch2.54mm
J7: + - 12v; Pin_Header_Straight_1x02_Pitch2.54mm
J8: ICSP; Pin_Header_Straight_2x03_Pitch2.54mm
J9: CONN_01X05; Pin_Header_Straight_1x05_Pitch2.54mm
J10: SCL SDA; Pin_Header_Straight_1x03_Pitch2.54mm
J11: To Rx in; Pin_Header_Straight_1x02_Pitch2.54mm
J12: CONN_01X03; Pin_Header_Straight_1x03_Pitch2.54mm
L1: T37-10 10t; Toroid_T37_Vertical
L2: T37-10 11t; Toroid_T37_Vertical
L3, L9, L10, L11, L12, L13, L14, L20, L21, L22, L23: L; L_1812_HandSoldering
L4, L16: 12t; Toroid_T37_Vertical
L5, L17, L33: 15t; Toroid_T37_Vertical
L6: 18t; Toroid_T37_Vertical
L7: 22t; Toroid_T37_Vertical
L8: 39t; Toroid_T37_Vertical
L15, L34: 11t; Toroid_T37_Vertical
L18: 19t; Toroid_T37_Vertical
L19, L25: 34t; Toroid_T37_Vertical
L24: 28t; Toroid_T37_Vertical
L26: 20t; Toroid_T37_Vertical
L27: 14t; Toroid_T37_Vertical
L28: 13t; Toroid_T37_Vertical
L29: 10t; Toroid_T37_Vertical
L30: 35t; Toroid_T37_Vertical
L31: 23t; Toroid_T37_Vertical
L32: 16t; Toroid_T37_Vertical
Q1, Q2, Q3, Q4, Q5, Q6, Q7, Q8: 2N7002; SOT-23
R1, R2, R3, R4, R18, R19, R20, R21, R24, R25, R26, R27: 680; R_1206_HandSoldering
R5, R6, R7, R8, R9, R10, R14, R15, R16, R17, R22, R23, R28, R30, R31, R32, R33, R34, R35: R; R_1206_HandSoldering
R11: 1k; R_1206_HandSoldering
R12, R13: 100k; R_1206_HandSoldering
R29: 10k; R_1206_HandSoldering
U1: ATMEGA328-AU; TQFP-32_7x7mm_Pitch0.8mm
U2, U3, U4, U5, U6, U7, U8, U9, U10, U11, U12: PE4259; SOT-363_SC-70-6_Handsoldering

Connections:
3V3: C45.1, C46.1, J8.2, R29.1, U1.4 (VCC), U1.6 (VCC), U1.18 (AVCC), U2.6, U3.6, U4.6, U5.6, U6.6, U7.6, U8.6, U9.6, U10.6, U11.6, U12.6
+12v: C18.1, C47.1, D24.2 (A), J7.2, R11.2
/I1: J9.2, U1.32 ((PCINT18/INT0)PD2)
/I2: J9.3, U1.1 ((PCINT19/OC2B/INT1)PD3)
/I3: J9.4, U1.2 ((PCINT20/XCK/T0)PD4)
/I4: J9.5, U1.7 ((PCINT6/XTAL1/TOSC1)PB6)
/R0: R35.1, U1.14 ((PCINT2/OC1B/~SS~)PB2), U3.4
/R1: J8.4, R30.1, U1.15 ((PCINT3/OC2A/MOSI)PB3), U2.4, U8.4
/R2: R31.1, U1.13 ((PCINT1/OC1A)PB1), U4.4, U9.4
/R3: R32.1, U1.12 ((PCINT0/CLKO/ICP1)PB0), U5.4, U10.4
/R4: R33.1, U1.11 ((PCINT23/AIN1)PD7), U6.4, U11.4
/R5: R34.1, U1.10 ((PCINT22/OC0A/AIN0)PD6), U7.4, U12.4
/RESET: J8.5, R29.2, U1.29 ((PCINT14/~RESET~)PC6)
/Rptt: Q8.1 (G), U1.8 ((PCINT7/XTAL2/TOSC2)PB7)
/S1: J12.3, U1.30 ((PCINT16/RXD)PD0)
/S2: J12.2, U1.31 ((PCINT17/TXD)PD1)
/SCL: J10.3, U1.28 ((PCINT13/SCL/ADC5)PC5)
/SDA: J10.2, U1.27 ((PCINT12/SDA/ADC4)PC4)
/T0: J8.1, Q1.1 (G), R5.1, U1.16 ((PCINT4/MISO)PB4)
/T17: J8.3, Q2.1 (G), R6.1, U1.17 ((PCINT5/SCK)PB5)
/T30: Q3.1 (G), R7.1, U1.23 ((PCINT8/ADC0)PC0)
/T40: Q4.1 (G), R8.1, U1.24 ((PCINT9/ADC1)PC1)
/T80: Q5.1 (G), R9.1, U1.25 ((PCINT10/ADC2)PC2)
/T160: Q6.1 (G), R10.1, U1.26 ((PCINT11/ADC3)PC3)
/Tptt: Q7.1 (G), R23.1, U1.9 ((PCINT21/OC0B/T1)PD5)
BiasV: C7.2, C40.2, C43.1, D23.1 (K), R1.2, R2.2, R3.2, R4.2, R18.2, R19.2, R20.2, R21.2, R24.2, R25.2, R26.2, R27.2
GND: C3.2, C4.2, C5.2, C7.1, C8.2, C9.2, C10.2, C11.2, C12.2, C18.2, C19.2, C20.2, C21.2, C22.2, C23.2, C24.2, C25.2, C26.2, C27.2, C28.2, C29.2, C35.2, C36.2, C37.2, C38.2, C39.2, C40.1, C43.2, C45.2, C46.2, C47.2, C48.2, C51.2, C57.2, C58.2, C59.2, C60.2, C61.2, C67.2, C68.2, C69.2, C70.2, C71.2, D7.1 (K), D8.1 (K), D9.1 (K), D10.1 (K), D11.1 (K), D12.1 (K), D26.1 (K), D28.1 (K), D29.1 (K), D30.1 (K), D31.1 (K), D32.1 (K), D33.1 (K), J1.1, J2.1, J3.2 (Ext), J4.1, J5.1, J6.2, J7.1, J8.6, J9.1, J10.1, J11.2, J12.1, Q1.2 (S), Q2.2 (S), Q3.2 (S), Q4.2 (S), Q5.2 (S), Q6.2 (S), Q7.2 (S), Q8.2 (S), U1.3 (GND), U1.5 (GND), U1.21 (GND), U2.2, U3.2, U4.2, U5.2, U6.2, U7.2, U8.2, U9.2, U10.2, U11.2, U12.2
unnamed: C1.1, C2.2, C4.1, L1.1, L2.2
unnamed: C1.2, C3.1, J3.1 (In), L1.2
unnamed: C2.1, C5.1, C6.1, L2.1
unnamed: C6.2, D1.2 (A), D2.2 (A), D3.2 (A), D4.2 (A), D5.2 (A), D6.2 (A), L3.1
unnamed: C10.1, C15.1, D4.1 (K), L6.2
unnamed: C11.1, C16.1, D5.1 (K), L7.2
unnamed: C12.1, C17.1, D6.1 (K), L8.2
unnamed: C8.1, C13.1, D2.1 (K), L4.2
unnamed: C13.2, C29.1, C30.1, L4.1, L10.1, L15.1
unnamed: C9.1, C14.1, D3.1 (K), L5.2
unnamed: C14.2, C25.1, C31.1, L5.1, L11.1, L16.1
unnamed: C15.2, C26.1, C32.1, L6.1, L12.1, L17.1
unnamed: C16.2, C27.1, C33.1, L7.1, L13.1, L18.1
unnamed: C17.2, C28.1, C34.1, L8.1, L14.1, L19.1
unnamed: C19.1, L9.2, Q1.3 (D), R12.2
unnamed: C20.1, L10.2, Q2.3 (D), R13.2
unnamed: C21.1, L11.2, Q3.3 (D), R14.2
unnamed: C22.1, L12.2, Q4.3 (D), R15.2
unnamed: C23.1, L13.2, Q5.3 (D), R16.2
unnamed: C24.1, L14.2, Q6.3 (D), R17.2
unnamed: C30.2, C35.1, D16.1 (K), L15.2
unnamed: C31.2, C36.1, D17.1 (K), L16.2
unnamed: C32.2, C37.1, D18.1 (K), L17.2
unnamed: C33.2, C38.1, D19.1 (K), L18.2
unnamed: C34.2, C39.1, D20.1 (K), L19.2
unnamed: C41.1, D13.1 (K), D14.2 (A)
unnamed: C41.2, C44.1, D21.1 (K), L21.1
unnamed: C42.1, D15.2 (A), D16.2 (A), D17.2 (A), D18.2 (A), D19.2 (A), D20.2 (A), L20.1
unnamed: C42.2, D21.2 (A), D27.2 (A), L22.2
unnamed: C44.2, J6.1
unnamed: C48.1, D14.1 (K), R12.1, R13.1, R14.1, R15.1, R16.1, R17.1, R22.2, R28.2
unnamed: C49.1, D27.1 (K), L23.1
unnamed: C49.2, U2.5
unnamed: C50.1, U2.1
unnamed: C50.2, C52.1, L24.2
unnamed: C51.1, L24.1
unnamed: C52.2, C62.1, L25.1
unnamed: C53.1, U4.1
unnamed: C53.2, C63.1, L26.2
unnamed: C54.1, U5.1
unnamed: C54.2, C64.1, L27.2
unnamed: C55.1, U6.1
unnamed: C55.2, C65.1, L28.2
unnamed: C56.1, U7.1
unnamed: C56.2, C66.1, L29.2
unnamed: C57.1, L25.2
unnamed: C58.1, L26.1
unnamed: C59.1, L27.1
unnamed: C60.1, L28.1
unnamed: C61.1, L29.1
unnamed: C62.2, C72.1, L30.1
unnamed: C63.2, C73.1, L31.1
unnamed: C64.2, C74.1, L32.1
unnamed: C65.2, C75.1, L33.1
unnamed: C66.2, C76.1, L34.1
unnamed: C67.1, L30.2
unnamed: C68.1, L31.2
unnamed: C69.1, L32.2
unnamed: C70.1, L33.2
unnamed: C71.1, L34.2
unnamed: C72.2, U8.1
unnamed: C73.2, U9.1
unnamed: C74.2, U10.1
unnamed: C75.2, U11.1
unnamed: C76.2, U12.1
unnamed: D1.1 (K), D15.1 (K), L9.1
unnamed: D7.2 (A), R5.2
unnamed: D8.2 (A), R6.2
unnamed: D9.2 (A), R7.2
unnamed: D10.2 (A), R8.2
unnamed: D11.2 (A), R9.2
unnamed: D12.2 (A), R10.2
unnamed: D13.2 (A), R11.1
unnamed: D22.1 (K), D25.2 (A)
unnamed: D22.2 (A), D24.1 (K)
unnamed: D23.2 (A), D25.1 (K)
unnamed: D26.2 (A), R23.2
unnamed: D28.2 (A), R30.2
unnamed: D29.2 (A), R31.2
unnamed: D30.2 (A), R32.2
unnamed: D31.2 (A), R33.2
unnamed: D32.2 (A), R34.2
unnamed: D33.2 (A), R35.2
unnamed: J11.1, U3.5, U4.5, U5.5, U6.5, U7.5
unnamed: L3.2, R1.1, R2.1, R3.1, R4.1
unnamed: L20.2, R18.1, R19.1, R20.1, R21.1
unnamed: L21.2, Q7.3 (D), R22.1
unnamed: L22.1, R24.1, R25.1, R26.1, R27.1
unnamed: L23.2, Q8.3 (D), R28.1
unnamed: U2.3, U3.1
unnamed: U8.5, U9.5, U10.5, U11.5, U12.5

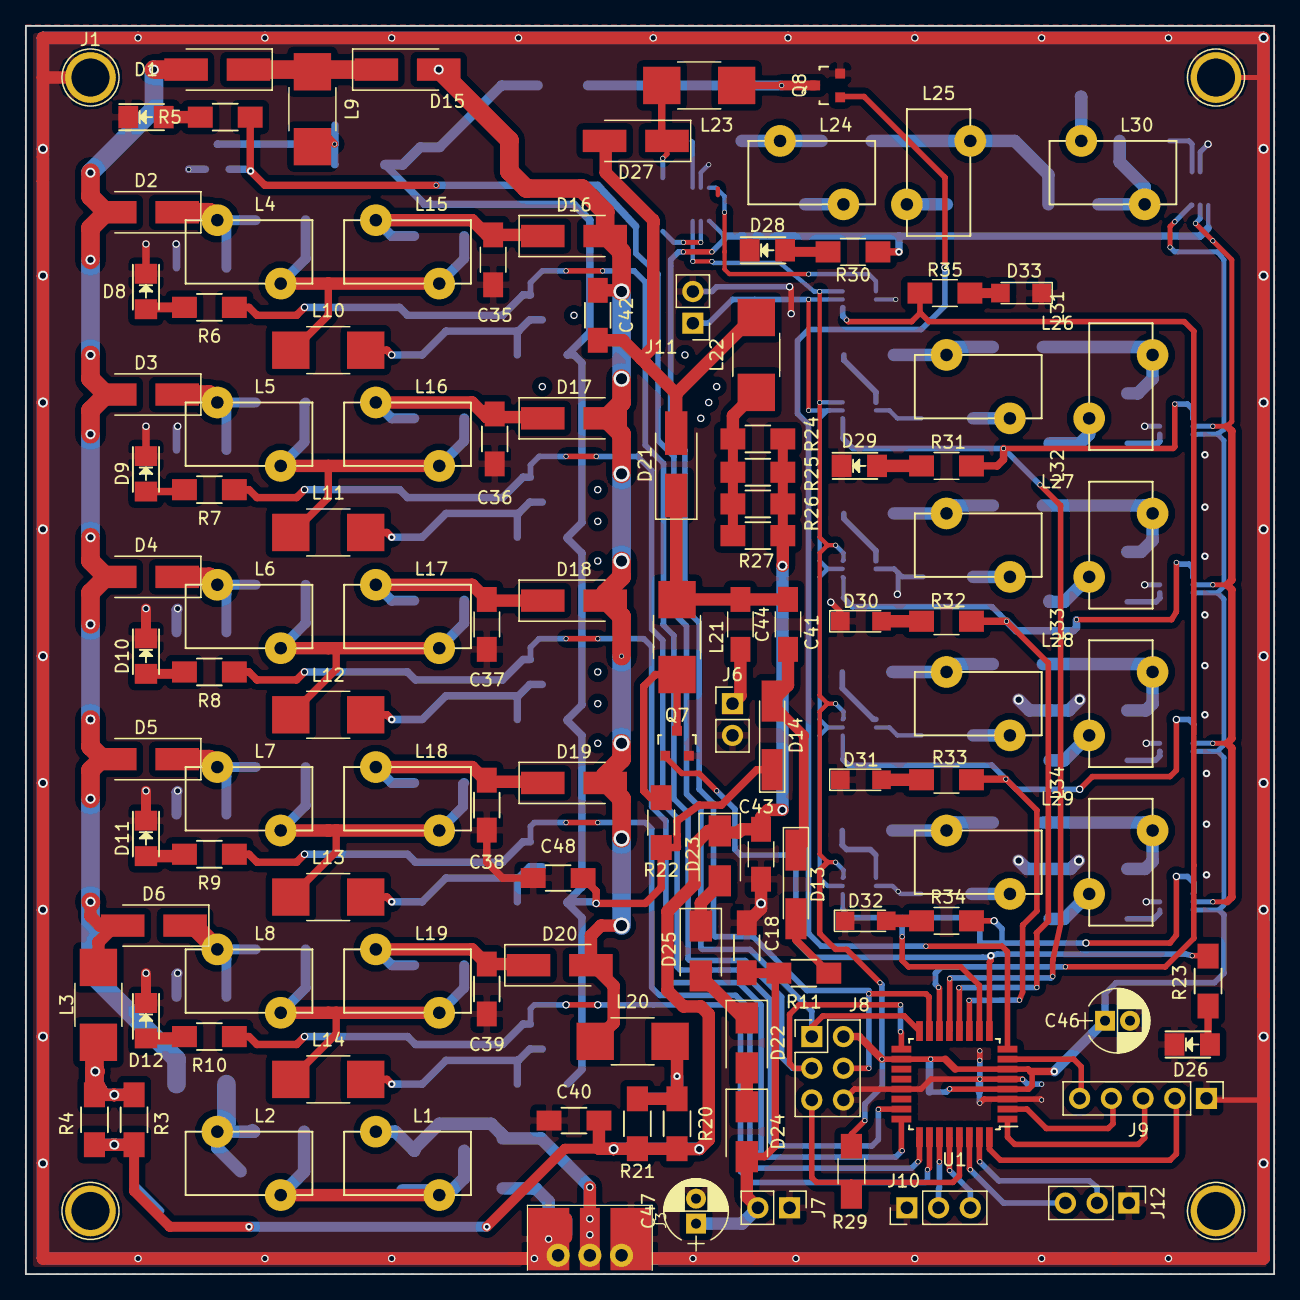
[picture p81: board HL_TX-RX_Filter.kicad_pcb from above]

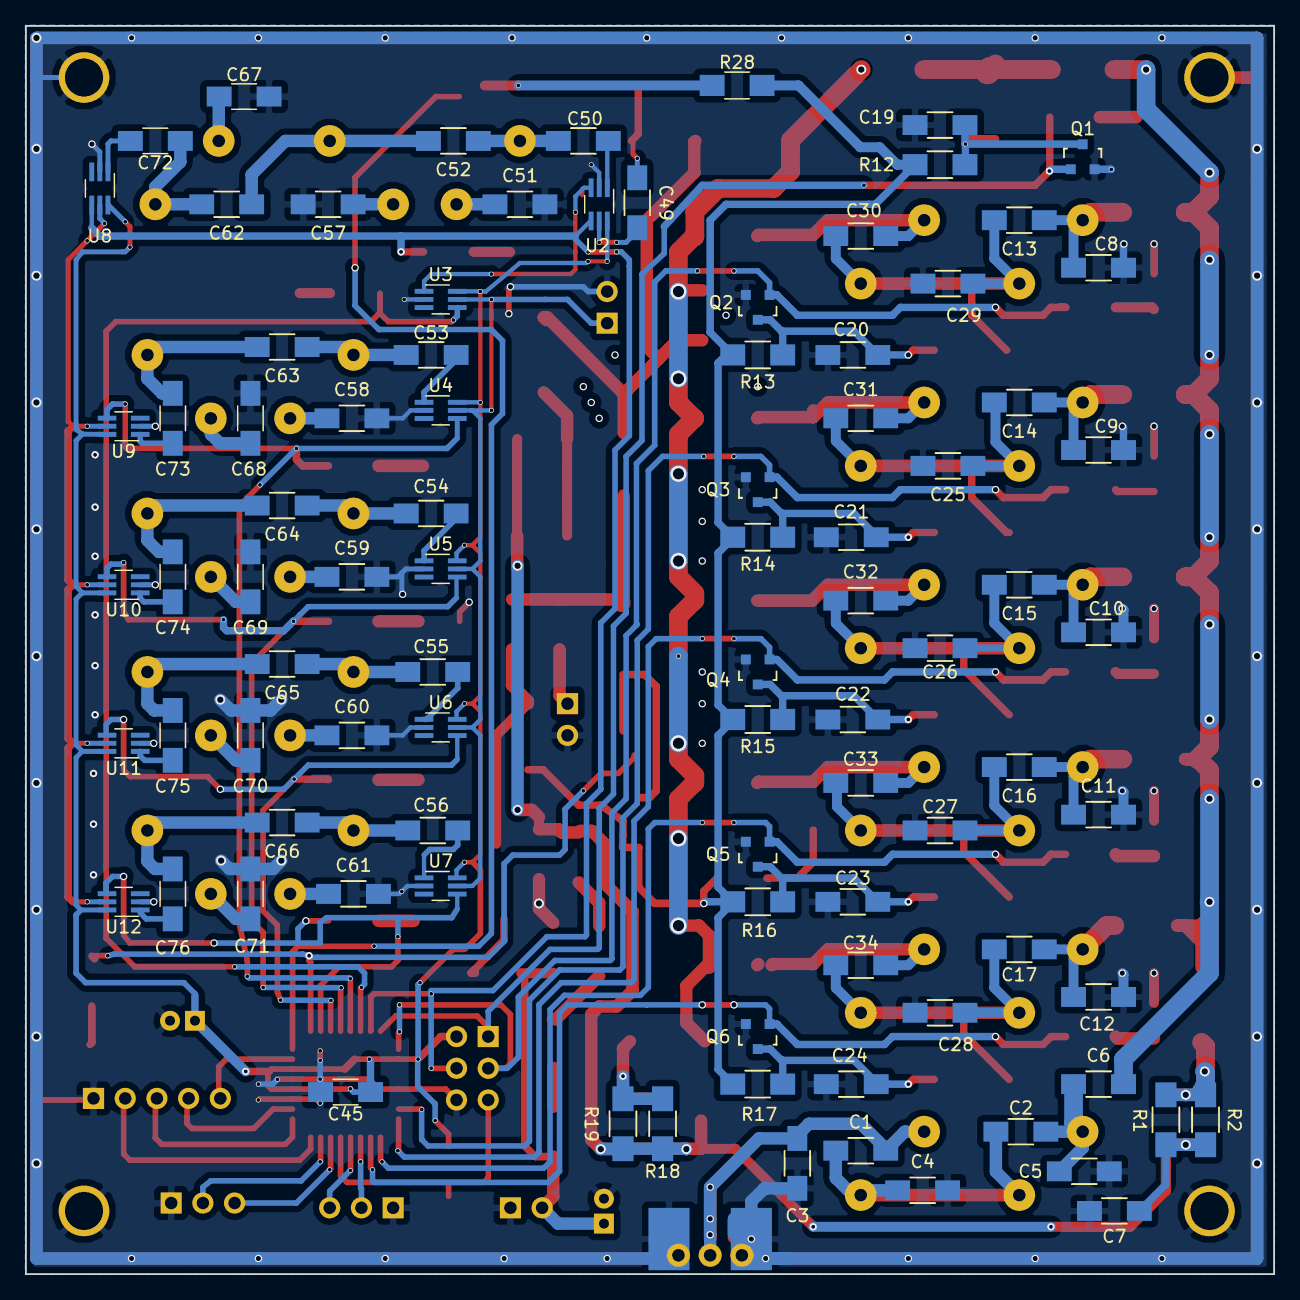
[picture p82: board HL_TX-RX_Filter.kicad_pcb from below]

Board: 2 copper layers, 100.0 x 100.0 mm, 210 parts (90 on the bottom side), 118 nets.
