radi8/-HL_TX-RX_Filters/(commit log)

2017-05-09 Drawn in roofing filter and through diodes
    [HL_TX-RX_Filter.sch]
2017-05-10 Totalled up capacitors
    [Filter Components.ods]
2017-05-10 Updated capacitor values
    [CapacitorList.ods, Filter Components.ods]
2017-05-11 Tweaking capacitor values
    [Filter Components.ods]
2017-05-12 Working on BOM
    [Filter Components.ods]
2017-05-13 Progress on schematic
    [HL_TX-RX_Filter.sch]
2017-05-18 Added ICSP circuitry
    [HL_TX-RX_Filter.sch]
2017-05-18 Added Tx LED indicators and ptt wiring
    [HL_TX-RX_Filter.sch]
2017-06-13 minor layout changes
    [HL_TX-RX_Filter.sch]
2017-07-05 Added 60/40M to Tx filter catalog
    [ElsieConfiguration.CFG]
2017-07-06 Changes to ISP wiring
    [HL_TX-RX_Filter.sch]
2017-07-12 Corrections and further additions
    [HL_TX-RX_Filter.sch]
2017-07-12 Diode switching experiment added
2017-07-13 Further progress on PCB
    [HL_TX-RX_Filter.sch]
2017-07-13 Added information on cascaded filters
2017-07-13 Linked footprints with CvPcb
    [HL_TX-RX_Filter.sch]
2017-07-14 Progressing with board layout
    [HL_TX-RX_Filter.sch]
2017-07-16 Organising the project and other housekeeping
    [HL_TX-RX_Filter.kicad_pcb]
2017-07-16 Resized toroids and M7 diodes
    [HL_TX-RX_Filter.kicad_pcb, HL_TX-RX_Filter.sch]
2017-07-17 Work on Tx Filter layout
    [HL_TX-RX_Filter.kicad_pcb]
2017-07-17 More Tx filter layout
    [HL_TX-RX_Filter.kicad_pcb]
2017-07-18 More Tx layout and choke footprint mods
    [HL_TX-RX_Filter.kicad_pcb, HL_TX-RX_Filter.sch]
2017-07-19 More progress with Tx filter board layout
    [HL_TX-RX_Filter.kicad_pcb, HL_TX-RX_Filter.sch]
2017-07-20 Further progress on layout
    [HL_TX-RX_Filter.kicad_pcb, HL_TX-RX_Filter.sch]
2017-07-20 Rearranging pins on microprocessor to better fit layout
    [HL_TX-RX_Filter.kicad_pcb, HL_TX-RX_Filter.sch]
2017-07-21 Sorted out some footprints
    [HL_TX-RX_Filter.kicad_pcb]
2017-07-21 Squeezed up Tx filters to hold 30M filter
    [HL_TX-RX_Filter.kicad_pcb]
2017-07-21 Re-annotated board
    [HL_TX-RX_Filter.kicad_pcb, HL_TX-RX_Filter.sch]
2017-07-22 Re-building PCB after annotation redo
    [HL_TX-RX_Filter.kicad_pcb, HL_TX-RX_Filter.sch]
2017-07-22 Rearranging layout for re-annotated schematic
    [HL_TX-RX_Filter.kicad_pcb, HL_TX-RX_Filter.sch]
2017-07-23 More layout progress
    [HL_TX-RX_Filter.kicad_pcb]
2017-07-23 Working on laying out Receive Filters
    [HL_TX-RX_Filter.kicad_pcb]
2017-07-23 Wiring of Rx filters
    [HL_TX-RX_Filter.kicad_pcb]
2017-07-23 Laying tracks for Tx switching
    [HL_TX-RX_Filter.kicad_pcb]
2017-07-24 Further progress on Filter switching lines
    [HL_TX-RX_Filter.kicad_pcb, HL_TX-RX_Filter.sch]
2017-07-26 Placing inputs to microprocessor
    [HL_TX-RX_Filter.kicad_pcb, HL_TX-RX_Filter.sch]
2017-07-29 Adjusted toroid sizes
    [HL_TX-RX_Filter.kicad_pcb]
2017-07-29 Added Jim's filters
    [ElsieConfiguration.CFG]
2017-07-30 Removed surplus choke etc from TX, RX switch
    [HL_TX-RX_Filter.kicad_pcb, HL_TX-RX_Filter.sch]
2017-07-31 Changed to Bourns chokes and progressed layout
    [ElsieConfiguration.CFG, HL_TX-RX_Filter.kicad_pcb, HL_TX-RX_Filter.sch]
2017-08-01 Add Tx/Rx changeover components
    [HL_TX-RX_Filter.kicad_pcb, HL_TX-RX_Filter.sch]
2017-08-01 More layout around bias voltage area
    [HL_TX-RX_Filter.kicad_pcb, HL_TX-RX_Filter.sch]
2017-08-01 Got last of components placed on board
    [HL_TX-RX_Filter.kicad_pcb, HL_TX-RX_Filter.sch]
2017-08-01 Saving state before complete annotate of schematic
    [HL_TX-RX_Filter.kicad_pcb]
2017-08-02 Reorganizing the components after annotate done
    [HL_TX-RX_Filter.kicad_pcb, HL_TX-RX_Filter.sch]
2017-08-02 Continuing layout
    [HL_TX-RX_Filter.kicad_pcb]
2017-08-03 Nearly there
    [HL_TX-RX_Filter.kicad_pcb]
2017-08-03 All DRC checks are now OK
    [HL_TX-RX_Filter.kicad_pcb]
2017-08-04 Fabricated and prepared Gerbers
    [HL_TX-RX_Filter-B.Cu.gbr, HL_TX-RX_Filter-B.Mask.gbr, HL_TX-RX_Filter-B.SilkS.gbr, HL_TX-RX_Filter-Edge.Cuts.gbr, HL_TX-RX_Filter-F.Cu.gbr, HL_TX-RX_Filter-F.Mask.gbr, HL_TX-RX_Filter-F.SilkS.gbr, HL_TX-RX_Filter-drl_map.gbr]
2017-09-05 Corrections to filter values
    [ElsieConfiguration.CFG, Filter Components.ods, HL_TX-RX_Filter.sch]
2017-09-05 Fixed merge problems
    [ElsieConfiguration.CFG]
2017-09-06 Replaced accidently deleted Tx filter catalog
2017-09-06 Added plot files and updated Tx filter catalog
2017-10-29 Terminated PE4259s and annotated more components
    [HL_TX-RX_Filter.sch]
2018-06-28 Filter plots worked on
    [CapacitorList.ods, Components.ods, ElsieConfiguration.CFG, Filter Components.ods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]
2018-06-28 Rearrange filters
    [HL_TX-RX_Filter.sch]
2018-06-28 Filter tests etc
    [CapacitorList.ods, Components.ods, ElsieConfiguration.CFG, Filter Components.ods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]
2018-06-29 Aligning masters
    [HL_TX-RX_Filter.sch]
2018-06-29 Tx filters config changed
2018-06-29 Progressing new filter design
    [HL_TX-RX_Filter.sch]
2018-06-30 More tweaks
    [HL_TX-RX_Filter.sch]
2018-07-06 Altered to piggy back on HL2 board
    [HL_TX-RX_Filter.sch]
2018-09-30 Upgraded to Kicad ver 5
    [HL_TX-RX_Filter-2018-09-30-22-53-34.sch]
2018-11-02 Changes to match HL2 pinouts
    [ElsieConfiguration.CFG, HL_TX-RX_Filter.sch]
